jper1679/sorter-v2/docs/src/content/lab/concepts/index.md

---
layout: default
title: Concepts
type: explanation
section: lab
slug: lab-concepts
kicker: Design and research — Variants
lede: Design proposals for the Sorter V2 that nobody has built yet, written down so they can be read, checked and argued with.
permalink: /lab/concepts/
audience: contributor or builder interested in changing the design
applies_to: hardware-v2
owner: docs
last_verified: 2026-10-11
---

A concept is a proposal for changing the standard Sorter V2 that has not been built. That is the difference from a [tested variant]({{ '/lab/variants/' | relative_url }}), which somebody has made and run on their own machine. A concept page says what is measured and what is estimated, so the claims in it can be checked before anyone prints anything.

None of these is part of the build instructions in [Hardware]({{ '/hardware/' | relative_url }}), and none is in the parts calculator.

## Proposals so far

<div class="callout-grid">
  <div class="callout">
    <strong><a href="{{ '/lab/concepts/floating-chute-stack/' | relative_url }}">Floating chute stack</a></strong>
    <p>Take every electrical part off the rotating chute stack, build each bin layer as its own module, and hold a column of chutes at two points.</p>
  </div>
  <div class="callout">
    <strong><a href="{{ '/lab/concepts/power-manager/' | relative_url }}">Push-button power manager</a></strong>
    <p>Start the machine with one button and shut it down cleanly through a remote-control power supply, with the Orange Pi shutting itself down first.</p>
  </div>
</div>
