jper1679/sorter-v2/docs/src/content/hardware/assembly/distribution/top-interface.md

---
layout: default
title: Top interface
type: how-to
section: hardware
slug: assembly-top-interface
kicker: Distribution — Top interface
lede: The interface between the feeder and the bin tower.
permalink: /hardware/assembly/distribution/top-interface/
og_image: https://assets.basically.website/sorter-parts/top-interface-finished-full-65eb32ba52dc.png
author: zed0
contributors: [barthel, brickcyclealice, dodgybob]
parts_needed:
  - part: interface-upper-fixed-section
    qty: 1
  - part: interface-rib
    qty: 5
  - part: interface-rib-switch
    qty: 1
  - part: interface-bracket
    qty: 6
  - part: interface-spacer
    qty: 6
  - part: interface-nema23-bracket
    qty: 1
  - part: interface-big-spacer
    qty: 1
  - part: limit-switch-housing
    qty: 1
  - part: limit-switch-dowel-pin
    qty: 1
  - part: limit-switch-hammer
    qty: 1
  - part: top-interface-split-spur-gear-3
    qty: 1
  - part: top-interface-split-spur-gear-1
    qty: 1
  - part: top-interface-split-spur-gear-2
    qty: 1
  - part: interface-spur-gear
    qty: 1
  - part: interface-idler-gear
    qty: 1
  - part: chute-stepper-idler-bearing-retainer-outer
    qty: 1
  - part: chute-stepper-idler-bearing-retainer-inner
    qty: 1
  - part: interface-cage-bracket
    qty: 5
  - part: interface-cage-bracket-cable
    qty: 1
  - part: top-plate
    qty: 1
  - part: cable-cage-top
    qty: 1
  - part: cable-cage-bottom
    qty: 1
  - part: cage-top-hex-corner
    qty: 10
  - part: cage-top-motor-piece
    qty: 1
  - part: cable-clamp-outer
    qty: 1
  - part: cable-clamp-inner
    qty: 1
  - part: ribbon-cable-clamp
    qty: 1
  - part: ext-2020-e
    qty: 6
  - part: ext-2020-f
    qty: 6
  - part: brg-lazy-susan
    qty: 1
  - part: brg-608-2rs
    qty: 1
  - part: motor-nema23
    qty: 1
  - part: pulley-20t-8mm
    qty: 1
  - part: endstop-mechanical
    qty: 1
  - part: cable-idc-2x8-long
    qty: 1
  - part: hsi-m3
    qty: 16
  - part: hsi-m4
    qty: 8
  - part: hsi-m5
    qty: 24
  - part: scr-m3-6-cs
    qty: 1
  - part: scr-m3-8-cs
    qty: 9
  - part: scr-m3-12-bhcs
    qty: 3
  - part: scr-m3-12-cs
    qty: 6
  - part: scr-m3-16-shcs
    qty: 2
  - part: scr-m3-20-cs
    qty: 1
  - part: scr-m3-40-fhcs
    qty: 1
  - part: scr-m4-16-cs
    qty: 8
  - part: scr-m5-8-cs
    qty: 6
  - part: scr-m5-12-shcs
    qty: 4
  - part: scr-m5-16-shcs
    qty: 50
  - part: scr-m5-20-shcs
    qty: 24
  - part: scr-m5-22-cs
    qty: 14
  - part: scr-m5-30-shcs
    qty: 6
  - part: scr-m5-35-fhcs
    qty: 6
  - part: nut-m3
    qty: 1
  - part: tnut-m5-2020
    qty: 56
  - part: nut-m5
    qty: 6
tools_needed: ["Hex keys, 2 mm, 2.5 mm, 3 mm and 4 mm", "Spanner, 8 mm, for the M5 nuts", "Soldering iron or heat-set insert press"]
last_verified: 2026-09-24
---

The top interface holds a chute that rotates on a lazy-susan bearing to aim incoming parts at whichever bin layer is currently selected. A NEMA 23 stepper drives the rotation through a small gear train (steps 6 and 9), and a limit switch and hammer (steps 4, 6, 8) give it a fixed reference point to home against, since the stepper alone has no way to know which way it is pointed. Everything on this page bolts onto the Top plate, which then sits on the hex frame built on the bin-frame page.

<div class="prep-item">
  <div class="prep-item-body">
    <p><strong>Have a <a href="{{ '/hardware/assembly/distribution/bin-frame/hex-frame/' | relative_url }}">hex frame</a> ready by step 13.</strong> It's a required component of this page — step 13 places one onto the assembly, it doesn't build one. The rest of this page (steps 1-12, 14+) doesn't need it.</p>
  </div>
  <figure class="prep-item-figure">
    A finished hex frame from above: six B spokes and their printed crossbeams forming the inner ring inside the aluminum outer hexagon, with a printed corner bracket at each of the six vertices
    <figcaption>A finished hex frame. <cite>Photo: BrickCycleAlice.</cite></figcaption>
  </figure>
</div>

<div class="prep-item">
  <div class="prep-item-body">
    <p><strong>Have the <a href="https://parts-calculator.basically.website/lasercut">Top plate</a> laser-cut and ready by step 2.</strong> It's not printed or built on any page, it's ordered or hand-cut ahead of time — see the parts calculator's lasercut page for the DXF and hand-cut instructions.</p>
  </div>
  <figure class="prep-item-figure">
    The machine's hexagonal top plate, laser-cut, with cable holes and stepper mount holes visible
    <figcaption>The Top plate.</figcaption>
  </figure>
</div>

<div class="prep-item">
  <div class="prep-item-body">
    <p><strong>Have the <a href="https://parts-calculator.basically.website/lasercut">Cable cage top</a> laser-cut and ready by step 10, and the Cable cage bottom by step 12.</strong> Same as the Top plate: laser-cut ahead of time, not built on this page.</p>
    <p><strong>Printing the cable cage plates instead?</strong> The parts list offers two options: the two laser-cut plates, or ten printed hex corners and one printed motor piece. For the printed ones, glue the pieces into the two plates first, on <a href="{{ '/hardware/helpers/cable-cage-plates/' | relative_url }}">Preparing the 3D printed cable cage plates</a>, and have them ready by step 10 and step 12. The steps below are the same either way.</p>
  </div>
  <div class="prep-item-figure prep-item-figure-split">
    <figure>
      The Cable cage top, a laser-cut hexagonal plate with a keyed centre cutout
      <figcaption>Cable cage top.</figcaption>
    </figure>
    <figure>
      The Cable cage bottom, a laser-cut hexagonal plate with a large centre cutout
      <figcaption>Cable cage bottom.</figcaption>
    </figure>
  </div>
</div>

The fasteners and quantities are in the parts list above and are called out inline at each step.

{% include fastener-legend.html %}

Several steps below refer to holes in the Top plate by name (S2 and S3 for the stepper mount, I1 to I6 and O1 to O6 for the interface brackets). This map shows which hole is which:

<figure>
  Hole map of the hexagonal top plate: three stepper holes S1 to S3 in a row left of the center opening, six inner-ring holes I1 to I6, six outer-ring holes O1 to O6, and five cable holes C1 to C5, colour-coded by group
  <figcaption>Top plate hole map. S = stepper trio, I = inner ring, O = outer ring, C = cable holes. <cite>Render: Balloon.</cite></figcaption>
</figure>

{% include step.html n="1" title="Preparation" %}

Before assembling anything, press all the heat inserts listed below into their parts while the parts are still loose — this covers every insert used on this page. Fusing them in afterwards is much harder, for example once the Interface upper fixed section is mounted to the Top plate. Later steps repeat each insert count as a reminder only; you don't need to press anything a second time. See [installing heat inserts]({{ '/hardware/helpers/heat-inserts/' | relative_url }}) for the technique.

<div class="prep-item">
  <div class="prep-item-body">
    <p><strong>Interface upper fixed section:</strong> 4 × M4</p>
  </div>
  <figure class="prep-item-figure">
    The Interface upper fixed section ring, underside with the NEMA 23 bracket attached, showing four brass M4 heat inserts around its face
    <figcaption>Underside, with the NEMA 23 bracket attached. <cite>Photo: zed0, a still from the assembly video.</cite></figcaption>
  </figure>
</div>

<div class="prep-item">
  <div class="prep-item-body">
    <p><strong>Interface NEMA 23 bracket:</strong> 6 × M5 (4 at the corners of the motor plate, 2 in a pair on the centre line) and 1 × M3 (on the tail)</p>
  </div>
  <figure class="prep-item-figure">
    The Interface NEMA 23 bracket held up, showing four brass M5 inserts on the top edges and one M3 insert on the long tail
    The underside of the Interface NEMA 23 bracket, showing the two remaining brass M5 heat inserts
    <figcaption>The four at the corners of the motor plate and the M3 on the tail, with the pair on the centre line on the other face. On the machine the four face down, towards the motor, and the pair face up, towards the Top plate. <cite>Photo: zed0, a still from the assembly video.</cite></figcaption>
  </figure>
</div>

<div class="prep-item">
  <div class="prep-item-body">
    <p><strong>Top interface chute mount:</strong> 4 × M4 and 7 × M3</p>
  </div>
  <div class="prep-item-figure prep-item-figure-split">
    <figure>
      The underside of the white Top interface chute mount, showing brass M4 and M3 heat inserts around the ring
      <figcaption>Underside: the 4 M4 and 5 of the M3. The other 2 M3 sit by the cable-clamp recess on the top face. <cite>Photo: zed0, a still from the assembly video.</cite></figcaption>
    </figure>
    <figure>
      A closer grey view of the Top interface chute mount underside, showing two of the M3 inserts on the ring beside the recess for the Limit switch hammer screw
      <figcaption>A closer look at two of the M3 inserts, next to the recess for the Limit switch hammer screw. <cite>Photo: BrickCycleAlice.</cite></figcaption>
    </figure>
  </div>
</div>

<div class="prep-item">
  <div class="prep-item-body">
    <p><strong>Interface bracket:</strong> 3 × M5 (each of the 6)</p>
  </div>
  <figure class="prep-item-figure">
    An Interface bracket held up, showing three brass M5 heat inserts: one near the top boss, one in the middle of the channel, and one at the bottom end
    <figcaption>One M5 on each long side and one on the tail end, including the one in the channel that's easy to miss. <cite>Photo: BrickCycleAlice.</cite></figcaption>
  </figure>
</div>

<div class="prep-item">
  <div class="prep-item-body">
    <p><strong>Limit switch housing:</strong> 2 × M3</p>
  </div>
  <figure class="prep-item-figure">
    The grey Limit switch housing, showing two brass M3 heat inserts on the angled face where the roller lever limit switch mounts, with the dowel pin hole above them
    <figcaption>The two M3 inserts, where the roller lever limit switch mounts. <cite>Photo: BrickCycleAlice.</cite></figcaption>
  </figure>
</div>

<div class="prep-item">
  <div class="prep-item-body">
    <p><strong>Limit switch hammer:</strong> 1 × M3</p>
  </div>
  <figure class="prep-item-figure">
    The Limit switch hammer held up, showing a single brass M3 heat insert in its round disc
    <figcaption>One M3 insert in the round disc. <cite>Photo: zed0, a still from the assembly video.</cite></figcaption>
  </figure>
</div>

<div class="prep-item">
  <div class="prep-item-body">
    <p><strong>Cable cage bracket (cable mount):</strong> 1 × M3</p>
  </div>
  <figure class="prep-item-figure">
    The Cable cage bracket (cable mount) held up, showing a single brass M3 heat insert
    <figcaption>The one M3 insert in the Cable cage bracket (cable mount). <cite>Photo: zed0, a still from the assembly video.</cite></figcaption>
  </figure>
</div>

<div class="prep-item">
  <div class="prep-item-body">
    <p><strong>Interface idler gear:</strong> 4 × M3, around the bearing pocket on the underside</p>
    <p>Build the bearing sub-assembly now too, while the gear is still loose — it is easier off the bracket than on it. Push a 608 2RS bearing into the pocket, fit the Chute stepper idler bearing retainer (inner) over the bearing's bore, then the Chute stepper idler bearing retainer (outer) over that, seated flush in the recess with its 4 holes lined up on the gear's 4 inserts. Secure it with 4 × {% include fastener.html size="M3" variant="countersunk" length="8" %} screws, the same M3 x 8 mm countersunk screw used on the Interface spur gear in step 9. See step 9 for how the idler gear then goes onto the bracket.</p>
  </div>
  <div class="prep-item-figure prep-item-figure-split">
    <figure>
      The Interface idler gear alone, showing all 4 brass M3 heat inserts around the bearing pocket
      <figcaption>The 4 M3 inserts around the bearing pocket, before the bearing goes in. <cite>Photo: BrickCycleAlice.</cite></figcaption>
    </figure>
    <figure>
      An exploded view from below of the idler gear stack in build order: the grey gear, the bearing highlighted in blue, and the inner and outer bearing retainer caps highlighted in red
      <figcaption>Exploded, in build order: gear, bearing, inner cap, outer ring. <cite>Render: Balloon.</cite></figcaption>
    </figure>
    <figure>
      608 2RS bearing pressed into the centre of the grey Interface idler gear, with the 4 brass M3 heat inserts visible around it, before the bearing retainer caps go on
      <figcaption>608 2RS bearing pressed into the pocket, inserts visible, caps not yet on. <cite>Photo: BrickCycleAlice.</cite></figcaption>
    </figure>
    <figure>
      The Interface idler gear seen from below at an angle, assembled, with the bearing highlighted in blue showing through the centre and the outer and inner bearing retainer caps highlighted in red, the outer retainer's four countersunk screw holes visible
      <figcaption>Assembled: bearing pocket recess with both retainer caps fitted. <cite>Render: Balloon.</cite></figcaption>
    </figure>
    <figure>
      The Interface idler gear with the bearing retainer caps mounted for real, the 4 screws seated flush in place of the heat inserts
      <figcaption>The retainer caps mounted for real, matching the render above. <cite>Photo: BrickCycleAlice.</cite></figcaption>
    </figure>
  </div>
</div>

{% include step.html n="2" title="Attach the interface ribs to the upper fixed section" %}

<figure class="video-figure">
  <div class="video-embed video-embed-wide">
    <iframe
      src="https://www.youtube.com/embed/O_ApnzrWRsE?mute=1"
      title="Attaching the interface ribs to the interface upper fixed section"
      allow="encrypted-media; picture-in-picture; web-share"
      allowfullscreen
      loading="lazy"></iframe>
  </div>
  <figcaption><cite>Video: zed0.</cite></figcaption>
</figure>

**Heat inserts first:** press the 4 × M4 inserts into the Interface upper fixed section and the 6 × M5 and 1 × M3 inserts into the Interface NEMA 23 bracket before you assemble anything here.

Attach the Interface rib (switch gap) to the Interface upper fixed section, two positions counterclockwise of the stepper-mount notch when viewed from above (see photo). Use two {% include fastener.html size="M5" variant="socket-button" length="16" %} screws, tapping directly into the plastic.

Attach the remaining 5 Interface ribs to the Interface upper fixed section, two {% include fastener.html size="M5" variant="socket-button" length="16" %} screws each, again tapping into the plastic.

Slot the Interface NEMA 23 bracket into the Interface upper fixed section and secure it from below with an {% include fastener.html size="M3" variant="countersunk" length="12" %} screw.

Attach the whole assembly to the bottom of the Top plate with 2 {% include fastener.html size="M5" variant="countersunk" length="22" %} screws, one through hole S2 and one through hole S3, into the Interface NEMA 23 bracket's pair of M5 inserts. Hole S1 stays empty.

**Alternative:** whether these need a countersunk head depends on how your Top plate was cut. If the S2/S3 holes have a countersink cut in, use a countersunk head; if they don't, {% include fastener.html size="M5" variant="socket-button" length="20" %} screws work here instead. Builder's call depending on their plate, the same as the I1-I6/O1-O6 screws in step 5.

<div class="img-row">
  <figure>
    Six grey Interface ribs attached around the circular Interface upper fixed section
    <figcaption>The 6 Interface ribs attached to the Interface upper fixed section. <cite>Photo: BrickCycleAlice.</cite></figcaption>
  </figure>
  <figure>
    Underside of the Interface upper fixed section with the Interface NEMA 23 bracket seated in its notch
    <figcaption>Underside, with the Interface NEMA 23 bracket seated in its notch. <cite>Photo: BrickCycleAlice.</cite></figcaption>
  </figure>
</div>

<div class="img-row">
  <figure>
    Close-up of a hand-cut plywood Top plate showing a countersunk screw hole near the S3 hole position
    <figcaption>A hand-cut Top plate with the S2/S3 holes countersunk. <cite>Photo: BrickCycleAlice.</cite></figcaption>
  </figure>
</div>

{% include step.html n="3" title="Prepare the interface brackets" %}

<figure class="video-figure">
  <div class="video-embed video-embed-wide">
    <iframe
      src="https://www.youtube.com/embed/-mtU3WXP73M?mute=1"
      title="Preparing the interface brackets"
      allow="encrypted-media; picture-in-picture; web-share"
      allowfullscreen
      loading="lazy"></iframe>
  </div>
  <figcaption><cite>Video: zed0.</cite></figcaption>
</figure>

**Heat inserts first:** each Interface bracket takes 3 × M5 inserts. Press them in before fitting the extrusion.

These six brackets are what the vertical extrusion legs (piece F, step 13) will anchor into once the framing goes on.

Align an Interface bracket with a length of aluminum extrusion, **piece E (Interface spoke, long), 238 mm**.

Place T-nuts in the extrusion, lined up with the 4 holes on the side of the Interface bracket. See [Fitting T-nuts]({{ '/hardware/helpers/t-nuts/' | relative_url }}) for how they go in.

Slide the extrusion into the Interface bracket, careful not to dislodge the T-nuts, and drive four {% include fastener.html size="M5" variant="socket-button" length="16" %} screws into them.

<div class="callout">
  <span class="callout-icon" aria-hidden="true">💡</span>
  <p>Thread the four screws a couple of turns into the T-nuts before sliding the extrusion in, so they hang in place instead of sitting loose in the channel. Easier than aligning four free T-nuts by feel. <cite>Tip: BrickCycleAlice.</cite></p>
</div>

<div class="img-row">
  <figure>
    Four M5 screws threaded a few turns into T-nuts hanging in the Interface bracket's channel before the extrusion is slid in
    <figcaption>Screws threaded into the T-nuts first, ready for the extrusion. <cite>Photo: BrickCycleAlice.</cite></figcaption>
  </figure>
  <figure>
    The extrusion slid into the Interface bracket's channel, with the four M5 screws driven into the T-nuts along the bracket's face and a brass M5 insert at each end of it
    <figcaption>The extrusion slid home and all four screws driven into the T-nuts. <cite>Photo: BrickCycleAlice.</cite></figcaption>
  </figure>
  <figure>
    The joined Interface bracket and extrusion from the outer side, the extrusion projecting past the bracket's lower end and the square socket for the vertical leg at the top
    <figcaption>The finished joint from the outer side, with the socket for the vertical leg at the top. <cite>Photo: BrickCycleAlice.</cite></figcaption>
  </figure>
</div>

Repeat for all 6 Interface brackets.

{% include step.html n="4" title="Prepare the limit switch interface bracket" %}

<figure class="video-figure">
  <div class="video-embed video-embed-wide">
    <iframe
      src="https://www.youtube.com/embed/YzYzytRl3p4?mute=1"
      title="Preparing the limit switch interface bracket"
      allow="encrypted-media; picture-in-picture; web-share"
      allowfullscreen
      loading="lazy"></iframe>
  </div>
  <figcaption><cite>Video: zed0.</cite></figcaption>
</figure>

**Heat inserts first:** the Limit switch housing takes 2 × M3 inserts. Press them in before assembling it.

This switch is the chute's home reference: because the stepper motor that will drive the chute (step 9) has no inherent sense of position, the machine homes against this switch and hammer on startup to know which bin the chute is aimed at.

Push the Printed dowel pin into the Limit switch housing.

Attach the Roller lever limit switch (the "endstop-mechanical" part in your kit) with two {% include fastener.html size="M3" variant="socket-button" length="16" %} screws (into the housing's 2 M3 inserts) so the roller sits next to the dowel pin.

<div class="img-row">
  <figure>
    The roller lever limit switch screwed to the grey Limit switch housing, its roller sitting alongside the printed dowel pin
    <figcaption>The switch on the housing, roller alongside the dowel pin. <cite>Photo: BrickCycleAlice.</cite></figcaption>
  </figure>
  <figure>
    The same limit switch housing from behind, showing both M3 screws through the switch body and the dowel pin standing proud of the housing
    <figcaption>From behind, with both M3 screws in and the dowel pin seated. <cite>Photo: BrickCycleAlice.</cite></figcaption>
  </figure>
</div>

Align the switch housing with the extrusion of one of the prepared Interface brackets so the limit switch is on the same face as the sloped side of the bracket. Slide 2 T-nuts into the extrusion and fasten the Limit switch housing to the extrusion with two {% include fastener.html size="M5" variant="socket-button" length="16" %} screws. Slide it as far toward the Interface bracket as possible for now; it gets aligned properly later.

<div class="callout">
  <span class="callout-icon" aria-hidden="true">💡</span>
  <p>Same trick as the Interface brackets above: thread the two screws into the T-nuts first, then slide the extrusion in with them already hanging in place. <cite>Tip: BrickCycleAlice.</cite></p>
</div>

<div class="img-row">
  <figure>
    Two T-nuts threaded onto their screws on the Limit switch housing's mounting face, ready for the extrusion
    <figcaption>T-nuts threaded on before the extrusion goes in. <cite>Photo: BrickCycleAlice.</cite></figcaption>
  </figure>
</div>

<div class="img-row">
  <figure>
    The limit switch housing bolted to the extrusion of a prepared Interface bracket, seen along the whole length of the bracket
    <figcaption>The housing on the bracket's extrusion, slid up toward the bracket. <cite>Photo: BrickCycleAlice.</cite></figcaption>
  </figure>
  <figure>
    Close view of the limit switch housing on the extrusion, with its two M5 screws and the switch facing the same way as the sloped side of the bracket
    <figcaption>Closer: the two M5 screws, switch on the same face as the bracket's slope. <cite>Photo: BrickCycleAlice.</cite></figcaption>
  </figure>
</div>

{% include step.html n="5" title="Install the brackets" %}

<figure class="video-figure">
  <div class="video-embed video-embed-wide">
    <iframe
      src="https://www.youtube.com/embed/K7r15si5yxI?mute=1"
      title="Installing the interface brackets"
      allow="encrypted-media; picture-in-picture; web-share"
      allowfullscreen
      loading="lazy"></iframe>
  </div>
  <figcaption><cite>Video: zed0.</cite></figcaption>
</figure>

Slide a T-nut just into the end of the extrusion of the limit switch interface bracket. Slide the extrusion into the Interface rib (switch gap) and Interface upper fixed section, securing it loosely with an {% include fastener.html size="M5" variant="countersunk" length="8" %} screw. Slide the extrusion slightly in and out to align the holes on the Interface bracket with the holes on the Top plate, then tighten the screw.

<div class="callout">
  <span class="callout-icon" aria-hidden="true">💡</span>
  <p>Keep this loose for now, the bracket also gets fixed through the Top plate in the next step. Check by looking straight through the Top plate's own screw hole, not by feel alone. <cite>Tip: BrickCycleAlice.</cite></p>
</div>

<div class="img-row">
  <figure>
    A bracket's extrusion slid into an Interface rib on the underside of the Top plate, held by a single screw
    <figcaption>The extrusion slid into its rib, still loose on one screw. <cite>Photo: BrickCycleAlice.</cite></figcaption>
  </figure>
  <figure>
    Closer view of the same joint with the rib, the bracket and the Top plate's hole lined up
    <figcaption>Closer, with the bracket's holes lined up on the Top plate's. <cite>Photo: BrickCycleAlice.</cite></figcaption>
  </figure>
</div>

<div class="img-row">
  <figure>
    Looking down through one of the Top plate's screw holes, with light visible through it into the extrusion channel below
    <figcaption>What a clear sightline through the hole looks like. <cite>Photo: BrickCycleAlice.</cite></figcaption>
  </figure>
</div>

<div class="callout callout-warning">
  <span class="callout-icon" aria-hidden="true">⚠</span>
  <p>The M5 × 8 mm is a snug fit here, it barely reaches the T-nut. Opening the countersink a little and tightening firmly gets the head to sit flush.</p>
</div>

Repeat with the 5 other prepared Interface brackets into the 5 other Interface ribs.

Flip the whole assembly and screw all 6 Interface brackets into place with 12 {% include fastener.html size="M5" variant="countersunk" length="22" %} screws, one through each of holes I1 to I6 and O1 to O6.

<div class="img-row">
  <figure>
    All six Interface brackets and their extrusions installed around the Interface upper fixed section, seen from above, with the limit switch bracket among them
    <figcaption>All six brackets in, the limit switch one among them. <cite>Photo: BrickCycleAlice.</cite></figcaption>
  </figure>
  <figure>
    The assembly flipped onto its Top plate, the plate's face up with the marked I and O holes around the centre opening
    <figcaption>Flipped over, ready for the I and O screws. <cite>Photo: BrickCycleAlice.</cite></figcaption>
  </figure>
</div>

<div class="callout callout-warning">
  <span class="callout-icon" aria-hidden="true">⚠</span>
  <p>Alternative: the Top plate's laser-cut holes are not countersunk, so a countersunk head does not seat flush. {% include fastener.html size="M5" variant="socket-button" length="20" %} screws work here instead.</p>
</div>

<div class="callout">
  <span class="callout-icon" aria-hidden="true">💡</span>
  <p>Go back and fully tighten the M5 × 8 mm screws left loose earlier in this step, now that each bracket is also bolted through its I/O holes. This is also where a hand-cut Top plate's I/O holes show up as inaccurate, if they do; widen them if a bolt is binding. <cite>Tip: BrickCycleAlice.</cite></p>
</div>

{% include step.html n="6" title="Prepare the interface chute gear and mount" %}

<figure class="video-figure">
  <div class="video-embed video-embed-wide">
    <iframe
      src="https://www.youtube.com/embed/7oYiOXYF8rA?mute=1"
      title="Preparing the interface chute gear and mount"
      allow="encrypted-media; picture-in-picture; web-share"
      allowfullscreen
      loading="lazy"></iframe>
  </div>
  <figcaption><cite>Video: zed0.</cite></figcaption>
</figure>

**Heat inserts first:** the Top interface chute mount takes 4 × M4 and 7 × M3 inserts, and the Limit switch hammer takes 1 × M3. Press them in before assembling.

Slot the Limit switch hammer into the Top interface chute mount, then secure it from below with an {% include fastener.html size="M3" variant="countersunk" length="6" %} screw (into the hammer's M3 insert).

<div class="callout callout-warning">
  <span class="callout-icon" aria-hidden="true">⚠</span>
  <p>The M3 × 6 mm screw head must sit completely flush with the printed Top interface chute mount. It lies inside the Lazy Susan's rotation path, so a raised head will catch.</p>
</div>

Align the Chute gear on the Top interface chute mount with the notch by the screw for the Limit switch hammer. Attach it with five {% include fastener.html size="M3" variant="countersunk" length="12" %} screws.

Align the Top interface lazy Susan washer with the 4 inner heat inserts on the Top interface chute mount. Align the inner ring of the [Lazy Susan]({{ '/hardware/parts/lazy-susan/' | relative_url }}) with these 4 heat inserts too. Screw the Lazy Susan into position through the washer and into the Top interface chute mount with four {% include fastener.html size="M4" variant="countersunk" length="16" %} screws.

<div class="callout callout-warning">
  <span class="callout-icon" aria-hidden="true">⚠</span>
  <p>These screws have to be very tight. A drill or electric screwdriver will not get them there, so finish them with a hex key by hand. Machine vibration works a loose one out.</p>
</div>

Once complete, the free section of the Lazy Susan should rotate freely.

<div class="img-row">
  <figure>
    Gear side of the assembled Top interface chute mount, showing the chute gear, Lazy Susan, and Limit switch hammer
    <figcaption>Gear side, with the Chute gear, Lazy Susan, and Limit switch hammer installed. <cite>Photo: BrickCycleAlice.</cite></figcaption>
  </figure>
  <figure>
    Chute side of the assembled Top interface chute mount with the Limit switch hammer extending from the edge
    <figcaption>Chute side of the assembled gear and mount. <cite>Photo: BrickCycleAlice.</cite></figcaption>
  </figure>
</div>

{% include step.html n="7" title="Attach the interface chute to the assembly" %}

<figure class="video-figure">
  <div class="video-embed video-embed-wide">
    <iframe
      src="https://www.youtube.com/embed/FxpaGbyANHA?mute=1"
      title="Attaching the interface chute to the assembly"
      allow="encrypted-media; picture-in-picture; web-share"
      allowfullscreen
      loading="lazy"></iframe>
  </div>
  <figcaption><cite>Video: zed0.</cite></figcaption>
</figure>

Place the Interface big spacer on the Interface upper fixed section with its 4 holes lined up with the 4 heat inserts.

Rotate the free part of the Lazy Susan on the chute mount assembly from step 6 so that 3 of its holes line up with the holes in the Top interface chute mount. Place the assembly on top of the Interface big spacer with the 3 holes aligned with 3 of the heat inserts. Screw these together tightly with three {% include fastener.html size="M4" variant="countersunk" length="16" %} screws.

Rotate the Top interface chute mount 90 degrees relative to the Interface upper fixed section to reveal the 4th screw hole in the Lazy Susan (it should also line up with a hole in the Interface big spacer and a heat insert). Drive a fourth {% include fastener.html size="M4" variant="countersunk" length="16" %} screw tightly through this hole.

Once done, check that the chute rotates freely relative to the Interface upper fixed section.

{% include step.html n="8" title="Adjust the limit switch" %}

<figure class="video-figure">
  <div class="video-embed video-embed-wide">
    <iframe
      src="https://www.youtube.com/embed/FxpaGbyANHA?start=160&mute=1"
      title="Adjusting the limit switch"
      allow="encrypted-media; picture-in-picture; web-share"
      allowfullscreen
      loading="lazy"></iframe>
  </div>
  <figcaption><cite>Video: zed0.</cite></figcaption>
</figure>

Loosen the screws attaching the Limit switch housing to the extrusion. Slide the housing so the Limit switch hammer passes between the Roller lever limit switch and the Printed dowel pin. **The hammer has to strike the switch from both directions of rotation, and it must not run on the dowel pin.** Rotate the chute slowly to each limit by hand: you should feel and hear the switch click just before the hammer would otherwise hit the dowel pin. If the hammer rubs against the dowel pin, slide the housing slightly further away and re-test. Tighten the screws to keep the housing in this position.

<div class="img-row">
  <figure>
    The chute and its ring gear installed on the interface assembly, seen from above with all six brackets around it
    <figcaption>The chute in place, which is the state this adjustment starts from. <cite>Photo: BrickCycleAlice.</cite></figcaption>
  </figure>
  <figure>
    Close view of the Limit switch hammer swung in between the roller lever limit switch and the printed dowel pin, beside the chute's ring gear teeth
    <figcaption>The hammer passing between the roller and the dowel pin, clear of both. <cite>Photo: BrickCycleAlice.</cite></figcaption>
  </figure>
  <figure>
    Looking straight down on the ring gear and the limit switch housing: the hammer swung in towards the roller lever of the microswitch, with a clear gap between the hammer and the printed dowel pin beside it
    <figcaption>From above, where the gap to the dowel pin is easiest to judge. <cite>Photo: BrickCycleAlice.</cite></figcaption>
  </figure>
</div>

{% include step.html n="9" title="Install the chute stepper motor" %}

<figure class="video-figure">
  <div class="video-embed video-embed-wide">
    <iframe
      src="https://www.youtube.com/embed/z-L7_pNB8A8?mute=1"
      title="Installing the chute stepper motor"
      allow="encrypted-media; picture-in-picture; web-share"
      allowfullscreen
      loading="lazy"></iframe>
  </div>
  <figcaption><cite>Video: zed0.</cite></figcaption>
</figure>

<div class="callout callout-warning">
  <span class="callout-icon" aria-hidden="true">⚠</span>
  <p>This video predates the idler gear's bearing retainer caps. It shows the idler gear built the old way, with a loose washer under the M3 × 35 screw instead of the two printed caps from step 1.</p>
</div>

The idler gear bridges the gap between the spur gear on the motor shaft and the chute's ring gear (built in step 6), so the motor can sit off to the side of the chute mount rather than driving it directly.

Slide the prepared [Timing pulley]({{ '/hardware/helpers/pulley-gear-mod/' | relative_url }}) over the shaft of the NEMA 23 stepper motor and tighten its two set screws (grub screws). Slide the Interface spur gear onto the Timing pulley and secure it with five {% include fastener.html size="M3" variant="countersunk" length="8" %} screws: three tapped into the Interface spur gear and two bracing against the Timing pulley (exact split may vary — check the hole pattern in the photo).

<div class="img-row">
  <figure>
    Timing pulley installed on the shaft of a NEMA 23 stepper motor
    <figcaption>Timing pulley installed on the NEMA 23 shaft. <cite>Photo: BrickCycleAlice.</cite></figcaption>
  </figure>
  <figure>
    Grey Interface spur gear secured over the timing pulley with five countersunk screws
    <figcaption>Interface spur gear secured over the Timing pulley with five M3 × 8 mm screws. <cite>Photo: BrickCycleAlice.</cite></figcaption>
  </figure>
</div>

Push the prepared Interface idler gear — bearing, inner retainer cap, and outer retainer already fitted, see step 1 — onto the Interface NEMA 23 bracket with the bearing facing outwards.

<div class="img-row">
  <figure>
    The Interface idler gear pushed onto the NEMA 23 bracket and meshed with the chute's ring gear, its bearing bore still open with no screw through it
    <figcaption>The idler gear pushed onto the bracket, bearing facing out, before the screw goes in. <cite>Photo: BrickCycleAlice.</cite></figcaption>
  </figure>
</div>

Drive an {% include fastener.html size="M3" variant="countersunk" length="20" %} screw through the middle of the gear and into the bracket, so its head lands on the inner retainer cap. Tighten until it's seated, then check that the idler gear still spins freely.

Use a countersunk (flat/pancake) head here, not a socket or button head. If you only have a pan head on hand, hand-rotate the chute past this screw and check it clears the Limit switch hammer before closing everything up.

Slot the NEMA 23 onto the Interface NEMA 23 bracket and secure it with four {% include fastener.html size="M5" variant="socket-button" length="12" %} screws.

At this point the chute should still rotate, but you will now feel resistance from the stepper motor. Rotate the chute fully in both directions by hand: it should turn smoothly against that resistance, with no catch or scrape as the idler screw head passes the Limit switch hammer.

<div class="img-row">
  <figure>
    The Interface idler gear on the NEMA 23 bracket with the outer retainer over its bearing and a countersunk screw driven flush through the middle of it
    <figcaption>Screw seated flush through the outer retainer. This is the last state before the motor goes on. <cite>Photo: BrickCycleAlice.</cite></figcaption>
  </figure>
  <figure>
    The NEMA 23 stepper motor installed, its spur gear meshed with the idler gear and the chute's ring gear
    <figcaption>The finished step: stepper, spur gear and idler all meshed. <cite>Photo: BrickCycleAlice.</cite></figcaption>
  </figure>
</div>

{% include step.html n="10" title="Attach the cable cage top" %}

<figure class="video-figure">
  <div class="video-embed video-embed-wide">
    <iframe
      src="https://www.youtube.com/embed/NUDDwb5BZH8?mute=1"
      title="Attaching the cable cage top"
      allow="encrypted-media; picture-in-picture; web-share"
      allowfullscreen
      loading="lazy"></iframe>
  </div>
  <figcaption><cite>Video: zed0.</cite></figcaption>
</figure>

The cable cage (top, bottom, and clamps) is the channel the ribbon cable (`RIB1`) runs in while the chute rotates.

**Heat inserts first:** the Cable cage bracket (cable mount) takes 1 × M3 insert. Press it in before assembling.

Slot the Cable cage top over the Top interface chute mount, with the corners of the hexagon aligning with the Interface brackets. Of the two cage plates, the one that goes on here is the one with the **plain round centre hole**. The plate with the keyed cutout in its centre hole is the other one, and it goes on at [step 12](#step-12).

Screw the Cable cage bracket (cable mount) to the tail end of the Interface bracket opposite the Limit switch housing, using an {% include fastener.html size="M5" variant="socket-button" length="30" %} screw into the M5 heat insert. This clamps the Cable cage top firmly in place.

<figure class="diagram diagram-inline">
    <svg viewBox="0 0 660 350" width="620" xmlns="http://www.w3.org/2000/svg" role="img" aria-label="Two top-down hexagon diagrams of the top interface, each with the NEMA 23 stepper on a flat side, the limit switch bracket on the corner two round from it and the cable mount bracket on the corner straight across from the limit switch. Left, looking at the underside of the plate while you build: the stepper is on the left, so the limit switch is at the top and the cable mount at the bottom. Right, looking down on the finished machine: the same layout mirrored, with the stepper on the right.">
      <text x="175" y="49" text-anchor="middle" font-size="13" font-weight="700" fill="var(--ink)">While you build</text>
      <text x="175" y="65" text-anchor="middle" font-size="11" fill="var(--muted)">looking at the underside of the plate</text>
      <polygon points="175.0,113.0 95.3,159.0 95.3,251.0 175.0,297.0 254.7,251.0 254.7,159.0" fill="var(--surface)" stroke="var(--ink)" stroke-width="1.6"/>
      <circle cx="175" cy="205" r="34" fill="var(--bg)" stroke="var(--muted)" stroke-width="1.4"/>
      <text x="175" y="209" text-anchor="middle" font-size="11" fill="var(--muted)">chute</text>
      <line x1="175.0" y1="123.0" x2="175.0" y2="287.0" stroke="var(--muted)" stroke-width="1" stroke-dasharray="4 4"/>
      <circle cx="95.3" cy="159.0" r="5" fill="var(--bg)" stroke="var(--ink)" stroke-width="1.4"/>
      <circle cx="95.3" cy="251.0" r="5" fill="var(--bg)" stroke="var(--ink)" stroke-width="1.4"/>
      <circle cx="254.7" cy="251.0" r="5" fill="var(--bg)" stroke="var(--ink)" stroke-width="1.4"/>
      <circle cx="254.7" cy="159.0" r="5" fill="var(--bg)" stroke="var(--ink)" stroke-width="1.4"/>
      <rect x="167.0" y="105.0" width="16" height="16" fill="var(--primary)" stroke="var(--ink)" stroke-width="1.4"/>
      <text x="175.0" y="97.0" text-anchor="middle" font-size="12" font-weight="700" fill="var(--primary)">Limit switch</text>
      <polygon points="175.0,287.0 185.0,297.0 175.0,307.0 165.0,297.0" fill="#0055bf" stroke="var(--ink)" stroke-width="1.4"/>
      <text x="175.0" y="323.0" text-anchor="middle" font-size="12" font-weight="700" fill="#0055bf">Cable mount</text>
      <rect x="63.3" y="183.0" width="30" height="44" rx="3" fill="var(--ink)"/>
      <text x="55.3" y="209" text-anchor="end" font-size="12" font-weight="700" fill="var(--ink)">Stepper</text>
      <text x="495" y="49" text-anchor="middle" font-size="13" font-weight="700" fill="var(--ink)">On the machine</text>
      <text x="495" y="65" text-anchor="middle" font-size="11" fill="var(--muted)">looking down from above</text>
      <polygon points="495.0,113.0 415.3,159.0 415.3,251.0 495.0,297.0 574.7,251.0 574.7,159.0" fill="var(--surface)" stroke="var(--ink)" stroke-width="1.6"/>
      <circle cx="495" cy="205" r="34" fill="var(--bg)" stroke="var(--muted)" stroke-width="1.4"/>
      <text x="495" y="209" text-anchor="middle" font-size="11" fill="var(--muted)">chute</text>
      <line x1="495.0" y1="123.0" x2="495.0" y2="287.0" stroke="var(--muted)" stroke-width="1" stroke-dasharray="4 4"/>
      <circle cx="415.3" cy="159.0" r="5" fill="var(--bg)" stroke="var(--ink)" stroke-width="1.4"/>
      <circle cx="415.3" cy="251.0" r="5" fill="var(--bg)" stroke="var(--ink)" stroke-width="1.4"/>
      <circle cx="574.7" cy="251.0" r="5" fill="var(--bg)" stroke="var(--ink)" stroke-width="1.4"/>
      <circle cx="574.7" cy="159.0" r="5" fill="var(--bg)" stroke="var(--ink)" stroke-width="1.4"/>
      <rect x="487.0" y="105.0" width="16" height="16" fill="var(--primary)" stroke="var(--ink)" stroke-width="1.4"/>
      <text x="495.0" y="97.0" text-anchor="middle" font-size="12" font-weight="700" fill="var(--primary)">Limit switch</text>
      <polygon points="495.0,287.0 505.0,297.0 495.0,307.0 485.0,297.0" fill="#0055bf" stroke="var(--ink)" stroke-width="1.4"/>
      <text x="495.0" y="323.0" text-anchor="middle" font-size="12" font-weight="700" fill="#0055bf">Cable mount</text>
      <rect x="576.7" y="183.0" width="30" height="44" rx="3" fill="var(--ink)"/>
      <text x="614.7" y="209" text-anchor="start" font-size="12" font-weight="700" fill="var(--ink)">Stepper</text>
    </svg>

  <figcaption>The cable mount bracket goes on the corner straight across from the limit switch bracket, and the limit switch bracket is the second corner round from the stepper. Looking at the underside, as the build video and most build photos do, the limit switch is clockwise of the stepper. From above, as the <a href="{{ '/hardware/electronics/installation/' | relative_url }}">electronics layout</a> is drawn, it is counter-clockwise.</figcaption>
</figure>

Screw the remaining Cable cage brackets to the other 5 corners of the Cable cage top with {% include fastener.html size="M5" variant="socket-button" length="30" %} screws.

<div class="callout callout-warning">
  <span class="callout-icon" aria-hidden="true">⚠</span>
  <p><b>Check the chute still turns after every single screw.</b> The cage jams the rotation easily, and the two usual causes are a hand-cut cage plate and an over-tightened screw. Checking after each one tells you which screw did it; checking at the end of the step only tells you that something did.</p>
</div>

<div class="img-row">
  <figure>
    Looking down on the hexagonal plywood cage top slotted over the chute mount, the square mount standing through its centre hole and the printed brackets at the hexagon's corners
    <figcaption>The cage top over the chute mount, corners on the interface brackets. <cite>Photo: BrickCycleAlice.</cite></figcaption>
  </figure>
  <figure>
    The same plate from a lower angle, the round centre hole and the gap between it and the chute mount visible
    <figcaption>The gap around the mount is where the ribbon runs. <cite>Photo: BrickCycleAlice.</cite></figcaption>
  </figure>
  <figure>
    A wider view of the plate in place with all six brackets around it and the cable clamp at the near edge of the centre hole
    <figcaption>All six corners on, clamp at the near edge. <cite>Photo: BrickCycleAlice.</cite></figcaption>
  </figure>
</div>

{% include step.html n="11" title="Put the ribbon cable (`RIB1`) in the cable cage" %}

<figure class="video-figure">
  <div class="video-embed video-embed-wide">
    <iframe
      src="https://www.youtube.com/embed/aCNjETS1X9A?mute=1"
      title="Installing the ribbon cable (RIB1) in the cable cage"
      allow="encrypted-media; picture-in-picture; web-share"
      allowfullscreen
      loading="lazy"></iframe>
  </div>
  <figcaption><cite>Video: zed0.</cite></figcaption>
</figure>

Place an {% include fastener.html size="M3" variant="nut" %} into the bottom of the Cable clamp (outer) (the video skips this), then push it into the recess in the Top interface chute mount. Fasten it with two {% include fastener.html size="M3" variant="socket-button" length="12" %} screws.

<div class="callout callout-warning">
  <span class="callout-icon" aria-hidden="true">⚠</span>
  <p>The nut is not captive: nothing holds it in the pocket until the clamp is pushed into the recess. Check it is lying flat on the bottom of the pocket and keep that face upwards while you mount the clamp. If it falls out or sits skewed, the long screw later in this step has nothing to start on, and you cannot get at it once the clamp is bolted down.</p>
</div>

Rotate the chute until it hits the limit switch.

Fold your IDC ribbon cable (`RIB1`) around the Cable clamp (inner), following the guides on the clamp. Slide the cable and clamp together into the Cable clamp (outer), leaving a tail to connect to the chute above.

**Leave about 80 mm (3 in) of tail**, measured from where it leaves the clamp, which is what it takes to reach the layer adapter board on the chute core that sits on top of this assembly.

**The connector goes on pins up.** You should be able to see into the connector from above when the tail is lying where it will sit; if it is facing down at the bench, the cable is on the wrong way round. Getting this wrong is expensive: three steps have to come apart to turn it over.

<figure class="single-figure">
  The ribbon cable folded around the white cable clamp with its grey IDC plug standing at the end of the tail, the plug's socket openings facing up so you can see into it
  <figcaption>The plug pins up, so you can see into it. <cite>Photo: DodgyBob.</cite></figcaption>
</figure>

Guide the rest of the ribbon cable (`RIB1`) around the side of the Top interface chute mount, in the direction the chute can rotate, back to the Cable cage bracket (cable mount).

Screw the Ribbon cable clamp lightly to the Cable cage bracket (cable mount) with one {% include fastener.html size="M3" variant="socket-button" length="12" %} screw, clamping the ribbon cable (`RIB1`) between the two. Leave the clamp standing slightly off the bracket face rather than pulling it down hard, so the ribbon is not crushed.

<div class="img-row">
  <figure>
    The curved ribbon cable clamp screwed to the post of the cable mount bracket with a single screw through its middle, no cable in it yet
    <figcaption>The clamp on the bracket's post, before the ribbon goes in. <cite>Photo: BrickCycleAlice.</cite></figcaption>
  </figure>
  <figure>
    The ribbon cable running under the clamp on the bracket and folding back on itself, the red stripe along its edge, with one screw holding the clamp
    <figcaption>The ribbon clamped and turning back on itself at the bracket. <cite>Photo: BrickCycleAlice.</cite></figcaption>
  </figure>
</div>

<figure class="single-figure">
  The ribbon cable brought up beside the chute mount with its IDC connector standing free, a loop of cable running down to the plywood, and four brass heat inserts in the face beside it
  <figcaption>The tail left standing for the chute above, about 80 mm (3 in) of it. The layer adapter board is not fitted here; it mounts on the four inserts in view. <cite>Photo: BrickCycleAlice.</cite></figcaption>
</figure>

<figure class="single-figure">
  Onshape render of the cable-mount cage bracket (teal) with the ribbon cable clamp (purple) bolted to its post, one M3 hole visible through both
  <figcaption>The clamp (purple) on the bracket's post (teal), and the one M3 that goes through both. The ribbon cable is not shown. <cite>Rendered from the part geometry, not from a build. Render: Spencer.</cite></figcaption>
</figure>

Check that the chute can rotate fully to the limit switch in both directions, then tighten the Ribbon cable clamp screw. Use a long {% include fastener.html size="M3" variant="flat" length="40" %} screw through the Cable clamp (inner) into the {% include fastener.html size="M3" variant="nut" %} in the bottom of the Cable clamp (outer) to secure that end.

{% include step.html n="12" title="Attach the cable cage bottom" %}

<figure class="video-figure">
  <div class="video-embed video-embed-wide">
    <iframe
      src="https://www.youtube.com/embed/CE3OKs5nXSk?mute=1"
      title="Attaching the cable cage bottom"
      allow="encrypted-media; picture-in-picture; web-share"
      allowfullscreen
      loading="lazy"></iframe>
  </div>
  <figcaption><cite>Video: zed0.</cite></figcaption>
</figure>

Place the Cable cage bottom over the Top interface chute mount. This is the plate with the **keyed cutout** in its centre hole, the pocket that bulges outward on one side. Use 6 {% include fastener.html size="M5" variant="flat" length="35" %} screws and {% include fastener.html size="M5" variant="nut" %}s to clamp the Cable cage bottom, Cable cage top, and Cable cage brackets together.

After this step the chute should still rotate to each of its limits. Same as step 10: check after each screw rather than at the end, and back a screw off rather than forcing the chute past a tight spot.

{% include step.html n="13" title="Attach the framing" %}

Install four T-nuts and their {% include fastener.html size="M5" variant="socket-button" length="20" %} screws in each Interface bracket, then fit in an extrusion **piece F (Interface vertical support), 274 mm**. The [framing cut list](https://parts-calculator.basically.website/framing) has every length on this page. Leave **165 mm of the extrusion standing out of the bracket**, measured from the edge where it exits to the free end. <a href="{{ '/hardware/assembly/distribution/top-interface/' | relative_url }}#step-14">Step 14</a> shows the corner in section.

<figure>
  Six vertical extrusion supports bolted into the interface brackets, seen from above on the hexagonal top plate
  <figcaption><cite>Photo: zed0.</cite></figcaption>
</figure>

Slide an Interface spacer onto each piece of extrusion, with the lip at the top facing toward the center of the assembly.

<figure>
  An interface spacer slid onto each vertical extrusion support, lips facing inward
  <figcaption><cite>Photo: zed0.</cite></figcaption>
</figure>

Build a [hex frame]({{ '/hardware/assembly/distribution/bin-frame/hex-frame/' | relative_url }}), then place it onto the interface assembly.

Roll 6 {% include fastener.html size="M5" variant="t-nut" text="T-nuts" %} into this hex frame's own extrusions while you are here, 2 each for the PSU box, the control board housing and the Orange Pi housing. All three bolt onto this frame later, and the layout render on [installing the electronics]({{ '/hardware/electronics/installation/' | relative_url }}) shows where each one sits. Their screws and the rest of their hardware are listed on those pages, not here.

<div class="callout">
  <p><b>No problem if you forget them.</b> The {% include fastener.html size="M5" variant="t-nut" text="T-nut" %} this build specifies is the spring-loaded roll-in kind, which drops into the slot anywhere along its length, so these six can still go in later without taking the frame apart.</p>
</div>

<figure>
  A hex frame lowered onto the interface assembly
  <figcaption><cite>Photo: zed0.</cite></figcaption>
</figure>

Attach an External bracket cover to each of the External bracket sides, then fasten each one with 2 {% include fastener.html size="M5" variant="socket-button" length="16" %} screws into the holes at the base of the External bracket sides, bracing against the extrusion. These holes run parallel to the extrusion profile, and the screws are self-tapping. There is no External bracket — bottom vertical at this joint; see [step 14](#step-14) for what's different here.

{% include step.html n="14" title="How the interface joins the top layer" %}

<figure>
  <a href="https://assets.basically.website/sorter-docs/assembly-top-interface-framing-joint-full-ed0a06d244ff.png" target="_blank" rel="noopener">
    The interface assembly upside down on its top plate with six vertical extrusions standing out of it, each held in an interface bracket and sleeved by an interface spacer
  </a>
  <figcaption>The interface framing before the top layer goes on, with one arm marked 1 to 3. Click the photo to open it full size. <cite>Photo: zed0.</cite></figcaption>
</figure>

<figure class="figure-float-right">
  <a href="https://assets.basically.website/sorter-docs/assembly-top-interface-joint-section-v4-full-61893a48b612.png" target="_blank" rel="noopener">
    Vertical cross-section through one interface corner, drawn the right way up with the top plate across the top
  </a>
  <figcaption>Cut through the centre of the profile. On the build the assembly is upside down at this stage. Purple is the interface, blue the top layer's bracket, grey the extrusion. The pale band is how far the Interface bracket really reaches and how it slopes out as it rises to the plate, in outline because its arms run at right angles to this cut. Part lengths are measured; heights come from seating each part on the one below. Click to enlarge. <cite>Drawn from the part geometry rather than from a build, by Balloon.</cite></figcaption>
</figure>

This joint is not the same as the one between two layers, so it is worth naming what is different. There is **no External bracket — bottom vertical and no flange here**, and therefore none of the vertical screws that hold one layer to the next. Piece F is instead gripped at the interface end and clamped at the layer end, and it is sleeved the whole way between them, so no extrusion shows on a finished machine.

The numbers on the photo and the drawing:

<ol class="keyed-list">
  <li><strong>Interface bracket</strong>, one per corner, a 120 mm channel around the extrusion. Piece F is held in it by 4 {% include fastener.html size="M5" variant="socket-button" length="20" %} screws into {% include fastener.html size="M5" variant="t-nut" text="T-nuts" %}, the only place in the framing where a vertical is fixed with T-nuts rather than a self-tapping screw.</li>
  <li><strong>Interface spacer</strong>, a 129.7 mm sleeve, slid onto the extrusion with its lip at the top facing the centre. It takes no screws and simply sits between the bracket and the layer's collar.</li>
  <li><strong>Piece F</strong>, 274 mm cut (280 mm in CAD) against a layer's 154 mm, so the interface sits 120 mm further above the top layer than one layer's spacing.</li>
  <li><strong>The top layer's External bracket — side</strong>, with its cover, exactly the collar any layer has.</li>
  <li class="key-screw"><strong>Two {% include fastener.html size="M5" variant="socket-button" length="16" %} screws</strong> at the base of that bracket brace it against the extrusion, the same screws and holes a layer's own vertical gets. Nothing else fastens the interface to the layer.</li>
</ol>

**Piece F does not reach the top of the Interface bracket, and it comes nowhere near the top plate.** The 165 mm standing out of the bracket in step 13 is what sets where it sits.

## The finished result

The top plate, its six bracket mounts and their extrusion, the rotating chute mount and its gear train, and a hex frame closed onto the bottom of the verticals.

<figure class="single-figure">
  The finished top interface seen the way up it sits on the machine: the hexagonal top plate uppermost with the round opening through its centre, the six interface brackets splayed below it, and the chute mount hanging in the middle
  <figcaption>The finished interface the way up it sits on the machine, with the plate at the top and the chute mount hanging through it. <cite>Rendered from the parts' own geometry in assembly position, not from a build. Render: Balloon.</cite></figcaption>
</figure>

The [Distribution]({{ '/hardware/assembly/distribution/' | relative_url }}) page contains the instructions for the entire assembly, and is where you should return once you're done here.
