jper1679/sorter-v2/docs/src/content/hardware/electronics/installation/psu-box.md

---
layout: default
title: PSU box
type: how-to
section: hardware
slug: electronics-psu-box
kicker: Electronics — PSU box
lede: The printed housing around the Mean Well LRS-350-24, its mains inlet, and the wiring inside it.
permalink: /hardware/electronics/installation/psu-box/
author: barthel
contributors: [spencer, brickcyclealice, jensr80, dodgybob]
og_image: https://assets.basically.website/sorter-docs/psu-box-finished-closed-w1600-f8bd8bb5814a.jpg
last_verified: 2026-09-26
tools_needed: ["Hex keys, 2 mm and 2.5 mm", "Screwdriver for the supply's M3.5 terminal screws", "Pliers, for the jacks' nuts", "Multimeter, with a continuity buzzer"]
parts_needed:
  - part: psu-24v-350w
    qty: 1
  - part: psu-switch-fused
    qty: 1
  - part: mains-cord-c13
    qty: 1
  - part: meanwell-psu-housing-shell-rear
    qty: 1
  - part: meanwell-psu-housing-shell-front
    qty: 1
  - part: meanwell-psu-housing-front-panel
    qty: 1
  - part: meanwell-psu-housing-lid-rear
    qty: 1
  - part: meanwell-psu-housing-lid-front
    qty: 1
  - part: scr-m4-12-cs
    qty: 4
  - part: scr-m3-12-cs
    qty: 8
  - part: scr-m3-8-cs
    qty: 2
---

<div class="prep-item">
  <div class="prep-item-body">
    <p><strong>Make three <a href="{{ '/hardware/helpers/psu-pigtail/' | relative_url }}">PSU output pigtails</a> (<code>PSU1</code> to <code>PSU3</code>) before you start.</strong> Each is a panel-mount barrel jack with a fork terminal crimped onto each of its two leads, and they are commonly sold with the leads already on. That page builds them; step 1 here fits and wires them.</p>
  </div>
  <figure class="prep-item-figure">
    An assembled PSU output pigtail: a panel-mount barrel jack with red and black 18 AWG (0.82 mm²) leads, each ending in an insulated fork terminal
    <figcaption>One finished pigtail: the jack, its red and black leads, and a fork terminal on each. <cite>Photo: Jon.</cite></figcaption>
  </figure>
</div>

The fasteners and quantities are in the parts list above and are called out inline at each step.

{% include fastener-legend.html %}

<div class="callout callout-warning">
  <span class="callout-icon" aria-hidden="true">⚠</span>
  <p><b>Until this box is finished it has exposed mains wiring.</b> Observe basic electrical safety precautions: do not plug a cable into the IEC inlet until the assembly is complete, the wiring is verified and both lids are on.</p>
</div>

## The five printed parts

<figure class="harness-figure">
  Exploded render of the five printed parts of the PSU housing in build order: the blue front panel at the front left, the light grey shell front module behind it, the grey shell rear tray with its honeycomb floor and vented walls, and above them the plain front lid and the vented rear lid
  <figcaption>The five parts, in the order they go together. The blue front panel carries the mains inlet and the three jacks. The two lids screw down onto the two shells. <cite>Rendered from the parts' own STLs.</cite></figcaption>
</figure>

**Build the front panel in your hand first.** Both wiring steps are easier with it loose, and it is the last thing that goes on.

{% include step.html n="1" title="Fit and wire the three jacks" %}

Push each jack through a round hole **from the outside**, so its knurled bezel sits on the outer face of the panel and the threaded barrel and the two leads come through into the box. Any of the three round holes will do.

<figure class="harness-figure">
  Dimensioned drawing of the PSU housing front panel seen from outside: a landscape panel 131 by 50 mm, with three 12 mm round jack holes in a row on the left at 20 mm pitch, and on the right a 47.5 by 28 mm rectangular mains inlet cutout with a 2.8 mm screw pilot hole above it and another below it, 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
  <figcaption>The front panel from outside: inlet on the right, jacks on the left. <cite>Drawn from the part's STL, not from a build.</cite></figcaption>
</figure>

Each jack comes with a hex nut and a **spring washer**. Both go on the thread inside the box, in that order:

<ol class="numbered-steps">
  <li><b>Spring washer first</b>, down the thread until it sits flat against the inside face of the panel.</li>
  <li><b>Then the nut</b>, run down onto the washer and tightened until the washer has flattened out.</li>
</ol>

Without the washer the nut works loose in the printed plastic, and a loose jack turns in its hole every time a plug goes in.

<figure class="single-figure">
  The inside of the front panel with three barrel jacks through it: the left jack bare, the middle one with its spring washer down on the thread and its nut still loose on the leads below, and the right one with the washer flattened under a tightened nut
  <figcaption>The three jacks from inside, left to right in the order they go on: bare, spring washer down against the panel, then the nut tightened onto it. <cite>Photo: JensR80.</cite></figcaption>
</figure>

Set the panel down beside the supply for now. The leads land on the terminal block in step 4, once the supply is in the tray.

{% include step.html n="2" title="Fit the mains inlet" %}

<div class="callout callout-warning">
  <span class="callout-icon" aria-hidden="true">⚠</span>
  <p><b>No mains cable (<code>AC1</code>) in the inlet.</b> Not for this step, not for any of the ones after it, and not until the box is closed and the wiring checked.</p>
</div>

The **IEC C14 inlet, switch + 10 A fuse** is the machine's mains entry and its on/off switch. Its three leads come already attached, so there is no AC cable to make.

**The cable from the wall is an ordinary IEC C13 mains lead (`AC1`)**, the cord a desktop PC or a monitor comes with, with the plug your country uses. It is in the parts above. Three core, because the machine earths through it and out to the supply's earth screw, and 10 A or better, which matches the module's own fuse and is far more than the machine draws. It is the one part of this build most people already own, so check a drawer before buying one.

Push the inlet module into the rectangular cutout from the outside, so its flange sits flat on the outer face of the panel and its two holes line up with the panel's two small holes. **The rocker can face either way**, left or right, and nothing later depends on which.

Run an {% include fastener.html size="M3" variant="countersunk" length="8" %} into each of the two holes. Each screw cuts its own thread in the panel, and nothing goes behind it.

Stop as soon as the flange is tight. The panel bows outward before the screw gives, so the screw will not tell you when to stop.

**If a screw turns and never pulls the flange down**, your front panel is an older print whose holes are too wide to bite. Print the front panel again from the file in the parts list above: it is the smallest part in the set, under an hour on the plate.

{% include step.html n="3" title="Bolt the supply into the rear tray" %}

<div class="callout callout-warning">
  <span class="callout-icon" aria-hidden="true">⚠</span>
  <p><b>Set the supply's input voltage selector before it goes in the tray.</b> The LRS-350-24 is not universal input: a small slide switch on the side of its case, marked <code>115V</code> and <code>230V</code>, sets which mains voltage it runs on, and it has to match the socket the machine will be plugged into. Check which way it is set now, while the supply is loose and nothing is plugged in, and slide it across if it is wrong. Once it is bolted into the tray with both lids over it you cannot reach it. Left on 115 V and plugged into 230 V mains, the supply is destroyed the moment the rocker goes on.</p>
</div>

The supply's case has four threaded holes in its back face, and the tray's floor has four plain round holes that line up with them. Sit the supply in the tray and run 4 {% include fastener.html size="M4" variant="countersunk" length="12" %} screws up through the floor into the case.

**Nothing longer goes in these four holes.** The supply's circuit board is right behind that face. If a screw stops before it pulls the supply down, back it out rather than force it.

**Put the terminal-block end at the open end of the tray**, the end the front module butts up to. The other end is where the supply's own fan is, and that is the end the vented rear lid covers.

<div class="img-row">
  <figure>
    Photograph of the Mean Well LRS-350-24 seen from its back, with its four plain M4 threaded holes ringed, two at each end of the case, and the finned terminal-block end labelled
    <figcaption>The four threaded holes on the back of the supply, and which end the terminal block is on. The hex-stamped holes beside them are the case's own screws, not these. <cite>Manufacturer photo, marked up.</cite></figcaption>
  </figure>
  <figure>
    Render of the shell rear tray seen from above and to one side, its honeycomb floor and vented walls visible, with the four round clearance holes the M4 screws pass through ringed
    <figcaption>The same four, in the tray's floor. The screws go in from underneath. <cite>Rendered from the part's own STL.</cite></figcaption>
  </figure>
</div>

{% include step.html n="4" title="Land every lead on the terminal block" %}

The block is nine screws and the numbers are Mean Well's own, printed on the supply beside it.

If you have been testing the inlet module on the bench, screw it into the panel first: once these leads are under the terminal screws there is no slack left to work with.

Hold the front panel up to the open end of the tray, close enough that its leads reach, and land them all:

<ol class="numbered-steps">
  <li><b>The three pigtails (<code>PSU1</code> to <code>PSU3</code>)</b>, one per <b>+V/-V</b> pair: <b>7 with 4, 8 with 5, 9 with 6</b>, the red terminal on the +V screw and the black on the -V screw of the same pair. Each pigtail must keep to one pair.</li>
  <li><b>The inlet's three leads</b>: <b>live on 1</b> (AC/L), <b>neutral on 2</b> (AC/N), <b>earth on 3</b>. The earth lead is the green-yellow one.</li>
</ol>

<div class="callout callout-warning">
  <span class="callout-icon" aria-hidden="true">⚠</span>
  <p><b>Find out which of the other two is live. Do not go by colour.</b> These modules are sold with red and blue leads and <b>both orders have been found in the post</b>, so the colour tells you nothing about which one the fuse and the switch are in. Land them the wrong way round and the machine is fused and switched in its neutral: the supply stays live with the rocker off.</p>
</div>

**The test**, with nothing plugged in: take the fuse out of its drawer, [set the meter to continuity]({{ '/hardware/helpers/multimeter/' | relative_url }}#continuity-for-tracing-a-cable), and probe from each coloured lead to each of the two flat pins inside the C14. The pair that still beeps with the fuse out is **neutral**. The one that beeps only with the fuse back in and the rocker on is **live**, because the fuse and the switch sit in the live side. That lead goes on screw 1.

**Nothing tinned goes under a screw terminal.** Solder cold-flows under a clamped screw, so a tinned end that is tight today is slack in a few months, and a slack joint carrying this much current heats up. Use the fork terminals this page calls for. If you would rather put a bare lead straight under the screw, cut the tinned end off first and clamp clean stranded copper.

For each one: back the screw off a few turns, slide the fork terminal in under it, and tighten it down. Mean Well's figure for these M3.5 screws is 8 to 10 kgf&middot;cm, about 0.8 to 1.0 N&middot;m, which is firm rather than hard. Tug-test each terminal once it is down.

<figure class="harness-figure">
  Diagram of the Mean Well LRS-350-24 seen from above, its nine-way terminal block down the left edge numbered 1 at the bottom to 9 at the top, the numbers being Mean Well's own and printed on the supply. Red leads run from screws 9, 8 and 7 and black leads from 6, 5 and 4, pairing 9 with 6, 8 with 5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
  <figcaption>Every lead that lands on the block, and the screw it lands on. The red and blue drawn at the bottom are one module's: check which of yours is live rather than copying the colours. <cite>Drawn from the Mean Well LRS-350 spec sheet, the inlet's catalog entry and the harness drawings.</cite></figcaption>
</figure>

{% include step.html n="5" title="Close the box" %}

Slot the front panel down into the front module, either way up, then bring the front module up against the tray so the two shells meet. Lay the leads so none of them rests against the mains screws.

Then the two lids, 8 {% include fastener.html size="M3" variant="countersunk" length="12" %}. They cut their own thread in the shell parts, so run each one in until the lid is tight and stop.

<ol class="numbered-steps">
  <li><b>Rear lid</b>, the vented one, over the supply's fan end.</li>
  <li><b>Front lid</b>, over the other end. It traps the front panel, so check the panel is fully seated before it goes on.</li>
</ol>

<figure class="harness-figure">
  Render of the PSU housing with both lids lifted off and set down beside it, the plain front lid and the vented rear lid side by side, and all eight self-tapping bosses in the two shell parts ringed on the open box
  <figcaption>Both lids lifted off, with all eight screw holes ringed. <cite>Rendered from the parts' own STLs.</cite></figcaption>
</figure>

The box is closed before the machine sees mains.

## The finished result

The supply inside the closed housing, both lids down, the mains inlet and the three jacks in the front panel, and the two clamp bosses ready for the frame.

<figure class="harness-figure">
  The closed PSU box on a white table, seen from the front corner: the front panel with three barrel jacks, the mains inlet and its red rocker switch, the black lids screwed down over the shells with the vented rear lid at the far end, and a clamp boss with a screw hole at each end of the base
  <figcaption>The box closed, with its two clamp bosses ready for the frame. <cite>Photo: DodgyBob.</cite></figcaption>
</figure>

<div class="callout callout-warning">
  <span class="callout-icon" aria-hidden="true">⚠</span>
  <p><b>Once it is in service, pull the cord (<code>AC1</code>) out of the wall before you open this box.</b> The rocker is not an isolator you can rely on: a plug that goes in either way round means the switch may be breaking the neutral rather than the live, so treat everything inside as live whenever the cord is in.</p>
</div>

**Bolting it to the frame is on the [installation overview]({{ '/hardware/electronics/installation/' | relative_url }})**, once all three enclosures are built.

Next: [preparing the control board]({{ '/hardware/electronics/installation/control-board-prep/' | relative_url }}).
