jper1679/sorter-v2/docs/src/content/hardware/assembly/feeder/c-channels/index.md

---
layout: default
title: C-channels
type: landing
section: hardware
slug: assembly-c-channels
kicker: Feeder — C-channels
lede: Four drive stages on one common core, each finished differently for the job it does.
permalink: /hardware/assembly/feeder/c-channels/
og_image: https://assets.basically.website/sorter-docs/assembly-channel-core-finished-top-w1600-4713962f4dfd.jpg
author: spencer
contributors: [barthel, brickcyclealice, christoph, danny]
last_verified: 2026-09-25
---

A C-channel is one drive unit: a rotor turning inside a stator, driven by a NEMA 17 stepper through a gear train. A machine has four, and **all four are built on the same core**. What differs is the rotor that drops in and what hangs off it.

Build the core four times, then finish each one on its own page.

<ol class="numbered-steps">
  <li><strong><a href="{{ '/hardware/assembly/feeder/c-channels/channel-core/' | relative_url }}">Channel core</a></strong>. Stator, NEMA bracket, gear train, stepper. Build four.</li>
  <li><strong><a href="{{ '/hardware/assembly/feeder/c-channels/bulk-channel/' | relative_url }}">Bulk channel (C1)</a></strong>. The faceted rotor and the Bulk cap. No lamp, no output guide.</li>
  <li><strong><a href="{{ '/hardware/assembly/feeder/c-channels/feeder-channels/' | relative_url }}">Feeder channels (C2 and C3)</a></strong>. The faceted rotor and an output guide. Build two.</li>
  <li><strong><a href="{{ '/hardware/assembly/feeder/c-channels/classification-channel/' | relative_url }}">Classification channel (C4)</a></strong>. The finned rotor and its cap.</li>
</ol>

Each page finishes its channel on the bench, rotor in. Once all four are built, [arranging C-channels]({{ '/hardware/assembly/feeder/arranging-c-channels/' | relative_url }}) sets their heights and hangs the [camera lamps]({{ '/hardware/assembly/feeder/camera-lamp/' | relative_url }}).

## The finished result

Each page ends in one of these.

<div class="img-row">
  <figure>
    A finished channel core from directly above: the stator ring open at one side, the three-armed NEMA bracket fastened across it with the raised hub at its centre, the gear train at the ring's edge and the stepper motor standing outside the wall with its lead, and no rotor in the hub
    <figcaption><a href="{{ '/hardware/assembly/feeder/c-channels/channel-core/' | relative_url }}">Channel core</a>, no rotor in it yet. <cite>Photo: BrickCycleAlice.</cite></figcaption>
  </figure>
  <figure>
    A finished C1 on the bench: the tall cylindrical bulk cap seated on the channel below it, its outlet opening at the front right, the stepper motor at the front with its lead coiled
    <figcaption><a href="{{ '/hardware/assembly/feeder/c-channels/bulk-channel/' | relative_url }}">Bulk channel</a>, the cap on. <cite>Photo: BrickCycleAlice.</cite></figcaption>
  </figure>
  <figure>
    A C-channel from above on a plain surface: the faceted rotor sitting down in the stator ring, with the stepper motor and its lead standing off one side
    <figcaption><a href="{{ '/hardware/assembly/feeder/c-channels/feeder-channels/' | relative_url }}">Feeder channel</a>, rotor in. The output guide is not in this shot. <cite>Photo: BrickCycleAlice.</cite></figcaption>
  </figure>
  <figure>
    A finished classification channel on a wooden bench: the white finned rotor sitting down in the black stator ring with a small grey cap at its centre, the stepper motor at the left and the orange output gear showing at the gap in the ring
    <figcaption><a href="{{ '/hardware/assembly/feeder/c-channels/classification-channel/' | relative_url }}">Classification channel</a>, the capped rotor in. <cite>Photo: JensR80.</cite></figcaption>
  </figure>
</div>
