jper1679/sorter-v2/docs/src/content/hardware/assembly/feeder/camera-lamp/lamp-arm.md

---
layout: default
title: Lamp arm
type: how-to
section: hardware
slug: assembly-lamp-arm
kicker: Feeder — Lamp arm
lede: The arm and the ring it carries, the reflector with its ring of LED strip, and the cover that goes over the top. The half of a camera lamp that is the same on all three. Build three.
permalink: /hardware/assembly/feeder/camera-lamp/lamp-arm/
author: jensr80
contributors: [spencer, danny, brickcyclealice, barthel]
og_image: https://assets.basically.website/sorter-docs/camera-lamp-render-underside-full-0e2b1e5a0fb9.png
last_verified: 2026-09-25
tools_needed: ["Hex key, 2 mm"]
parts_needed:
  - part: c-channel-arm-mount
    qty: 1
  - part: camera-lamp-arm
    qty: 1
  - part: arm-bracket-a
    qty: 1
  - part: arm-bracket-b
    qty: 1
  - part: camera-lamp-ring
    qty: 1
  - part: lamp-inner-reflector
    qty: 1
  - part: inner-reflector-led-hook
    qty: 6
  - part: lamp-outer-cover
    qty: 1
  - part: led-strip-24v
    qty: 1
  - part: scr-m3-12-cs
    qty: 12
---

This page builds the part of a camera lamp that is the same on every channel: the arm with its ring at one end and its dovetail at the other, and the shaded lamp that sits over the ring. **No camera goes on here.** That is the [feeder camera lamp]({{ '/hardware/assembly/feeder/camera-lamp/feeder-camera-lamp/' | relative_url }}) page for C2 and C3, and the [classification camera lamp]({{ '/hardware/assembly/feeder/camera-lamp/classification-camera-lamp/' | relative_url }}) page for C4.

**The parts list above is one arm's worth. Build three**, for C2, C3 and the classification channel. **The bulk channel (C1) takes none**, because the machine does not look at it.

<div class="prep-item">
  <div class="prep-item-body">
    <p><strong>Prepare an <a href="{{ '/hardware/helpers/led-strip/' | relative_url }}">LED strip</a> before you start.</strong> One per lamp: a two-turn length cut off the roll, about 920 mm (36 in), with a short pigtail (<code>LED2</code>, <code>LED3</code> or <code>LED4</code>) on the end (ending in a male barrel plug, optional but recommended), either clamped on or soldered. That page has the strip, the connector, the plug and the board cable (<code>LED2a</code>, <code>LED3a</code> or <code>LED4a</code>); step 4 here only hooks it on.</p>
  </div>
  <figure class="prep-item-figure">
    A length of 8 mm COB LED strip with a clear clamp-on connector on its cut end, a red and a black wire leaving the other side of the connector in a white sheath
    <figcaption>A prepared strip: the cut end, the joint, and the pigtail (<code>LED2</code> to <code>LED4</code>) that leaves it. <cite>Manufacturer photo (SuperBrightLEDs).</cite></figcaption>
  </figure>
</div>

{% include fastener-legend.html %}

{% include step.html n="1" title="Preparation" %}

<div class="prep-item">
  <div class="prep-item-body">
    <p><strong>Colours.</strong> The <strong>Lamp inner reflector</strong> and its six <strong>LED hooks</strong> must print ivory white, and that is not cosmetic: they are the reflector, and a coloured one tints every picture the camera takes. The <strong>Lamp outer cover</strong>, the arm, the mount, both brackets and the ring can be any colour; the parts calculator puts them in the C-channel colour.</p>
  </div>
  <figure class="prep-item-figure">
    CAD render of the camera lamp in profile: the disc-shaped lamp overhanging at the top, carried on an arm that steps down at an angle to the C-channel arm mount, with a bracket along each joint
    <figcaption>The whole thing in profile. <cite>Rendered from the part geometry, not from a build. Render: Spencer.</cite></figcaption>
  </figure>
</div>

<div class="prep-item">
  <div class="prep-item-body">
    <p><strong>Six LED hooks per lamp, 18 for the machine.</strong> They are the ones people come up short on.</p>
  </div>
  <div class="prep-item-figure prep-item-figure-split">
    <figure>
      The printed lamp inner reflector lying face up, ivory white, with six LED hooks clipped evenly around its rim and a small grey rectangular plate sitting on the flat
      <figcaption>The inner reflector with its six LED hooks around the rim. <cite>Photo: BrickCycleAlice.</cite></figcaption>
    </figure>
    <figure>
      A closer view of the same reflector, two of the hooks standing off the rim and the grey rectangular plate on the flat between them
      <figcaption>Closer, with two of the hooks in view. <cite>Photo: BrickCycleAlice.</cite></figcaption>
    </figure>
  </div>
</div>

{% include step.html n="2" title="Bracket the arm to the C-channel arm mount" %}

The arm and the mount butt together end to end, with bracket A on one face and bracket B on the other.

<ol class="numbered-steps">
  <li>Butt the arm and the mount together. The ends are shaped, so they only mate one way round. If it does not seem to fit, swap the piece end for end rather than forcing it.</li>
  <li>Lay bracket A across the joint on one face and bracket B on the other, <strong>angled ends towards the dovetail</strong>.</li>
  <li>Drive 8 {% include fastener.html size="M3" variant="countersunk" length="12" %} screws, four per bracket. Stop as each head seats.</li>
</ol>

**The two brackets share their holes**, four holes with a screw into each end, so half of every hole belongs to the other bracket's screw. **Use the 12 mm here.** Two 16 mm screws would meet inside a hole before either seated.

<div class="img-row">
  <figure>
    The camera lamp arm butted to its mount with a bracket screwed across the joint, two countersunk screws in it, and the printed dovetail at the far end of the arm
    <figcaption>The joint with a bracket on, angled end towards the dovetail. <cite>Photo: BrickCycleAlice.</cite></figcaption>
  </figure>
  <figure>
    The far section of the camera lamp arm lying on the bench, the lamp ring at one end and the shaped mating end at the other
    <figcaption>The other section, ring end and shaped end. <cite>Photo: BrickCycleAlice.</cite></figcaption>
  </figure>
  <figure>
    A wider view of a camera lamp on the machine, showing the full length of the arm from the lamp down to the C-channel, with a bracket screwed along the joint and the LED leads cable-tied along the arm
    <figcaption>The same joint on the machine, leads running down the arm. <cite>Photo: Spencer.</cite></figcaption>
  </figure>
</div>

{% include step.html n="3" title="Screw the camera lamp ring onto the arm" %}

The ring goes on the far end of the arm, and is what the lamp and the camera hang from. It straddles the arm, and it works the same way as the joint below it: 4 more {% include fastener.html size="M3" variant="countersunk" length="12" %} screws, two per side, into the same two holes.

That is **12 M3 × 12 per arm**: 8 at the mount joint, 4 here. Six holes, a screw into each end of every one.

<figure class="single-figure">
  The whole camera lamp arm assembled on the bench: the dovetailed mount end, the bracket running along the joint with its screws, the bend, and the lamp ring at the far end
  <figcaption>Both sections joined, dovetail at one end and the ring at the other. <cite>Photo: BrickCycleAlice.</cite></figcaption>
</figure>

{% include step.html n="4" title="Hook the prepared LED strip onto the reflector" %}

Push the six **Inner reflector LED hooks** into the sockets around the rim of the **Lamp inner reflector**, evenly spaced. They are a friction fit and there are no screws. Each hook holds the LED strip against the reflector.

The strip itself is cut and wired on [Preparing the LED strip]({{ '/hardware/helpers/led-strip/' | relative_url }}): two turns of the skirt, about 920 mm (36 in), cut on a printed mark, with a short pigtail (`LED2` to `LED4`) on the cut end, which ends in a barrel plug if you fit the optional but recommended plug and socket. Have one ready before you start this step.

**Fitting it.** Two turns, LEDs facing inwards. **Do not stick the strip to the skirt.** Leave the blue film on and let the hooks hold it: it hangs in the air with room behind it, which keeps it cooler, and the adhesive lets go in the end anyway.

<ol class="numbered-steps">
  <li>Start the strip under one of the hooks, film still on, with the wired end where you want the leads to leave the lamp.</li>
  <li>Work it round the skirt, under each hook in turn, until you are back where you started. That is one turn.</li>
  <li>Drop down to the next hooks and go round again for the second turn.</li>
</ol>

<div class="img-row">
  <figure>
    The strip run once around the inside of the reflector skirt, back at its starting point, with the blue film being peeled off the length still to go
    <figcaption>One turn round. <cite>Photo: BrickCycleAlice.</cite></figcaption>
  </figure>
  <figure>
    Both turns of strip in the skirt, one above the other, film gone, with the red and black leads leaving the reflector at one side
    <figcaption>Second turn in, on the next clips down, leads out at one side. <cite>Photo: BrickCycleAlice.</cite></figcaption>
  </figure>
</div>

**Nothing fastens the reflector to the arm.** The arm's ring pushes up into the middle of the reflector from underneath and is held by the fit alone. That happens on the camera page for your channel, with the camera already clasped in the ring, so the arm and the lamp stay separate until then.

The strip comes with its pigtail (`LED2` to `LED4`) already on it from [Preparing the LED strip]({{ '/hardware/helpers/led-strip/' | relative_url }}); strap that lead down the arm so it is not hanging in the channel (hook-and-loop straps rather than zip ties, see [securing the cables]({{ '/hardware/electronics/connecting/' | relative_url }}#securing-the-cables)). It can leave the lamp two ways, and machines have been built both: straight out of the bottom of the shade, or up through the slot in the cover and down the outside alongside the camera lead. Whichever you pick, keep the run clear of where the strip's own joint sits inside the shade. Plugging it into the board is step 4 of [connecting the components]({{ '/hardware/electronics/connecting/' | relative_url }}). Nothing is joined end to end here, so the far end of the strip stays dead. The strip runs at 24 V off the basically board.

{% include step.html n="5" title="Press the outer cover onto the reflector" %}

The **Lamp outer cover** pushes down over the reflector. It is a friction fit and has no screw hole anywhere. Put the reflector flat on the table, sit the cover on it and press straight down until it seats. It stands slightly proud of the reflector, so the camera clasp ends up recessed in the opening at its centre.

**The lamp is finished here, and it is finished without a camera.** The camera goes into the ring on the arm, and the arm goes up into the underside of this lamp, on the camera page for your channel. The cover stays on while that happens: the clasp is wider than the opening in the middle of the cover, so the cover overlaps its rim and is what holds the camera down once the arm is home.

<figure class="single-figure">
  The lamp lit, photographed from underneath: a ring of LED strip glowing around the outside of the white reflector, the reflector's central funnel in the middle, and the arm behind it
  <figcaption>Lit, from below. The strip rings the reflector and the light reaches the parts off the white. <cite>Photo: Spencer.</cite></figcaption>
</figure>

## The finished result

An arm with its dovetail at one end and its ring at the other, plus a finished lamp: reflector, LED strip and cover. Build three of each, and take them to the camera page for the channel they belong to, where the camera goes in the ring and the arm goes up into the lamp.

<figure class="single-figure">
  CAD render of the camera lamp seen from below: the inside of the cover with the reflector dome, the LED hooks spaced around the rim, and the arm reaching up into the middle of it
  <figcaption>From below: the reflector inside the cover, the hooks around the rim and the arm reaching up into the middle. <cite>Rendered from the part geometry, not from a build. Render: Spencer.</cite></figcaption>
</figure>

Back to [Camera lamps]({{ '/hardware/assembly/feeder/camera-lamp/' | relative_url }}).
