jper1679/sorter-v2/electronics/KiCad/1_Distribution_Board/1_Distribution_Board.kicad_pcb

## KiCad design electronics/KiCad/1_Distribution_Board/1_Distribution_Board.kicad_pcb (2026-11-07)

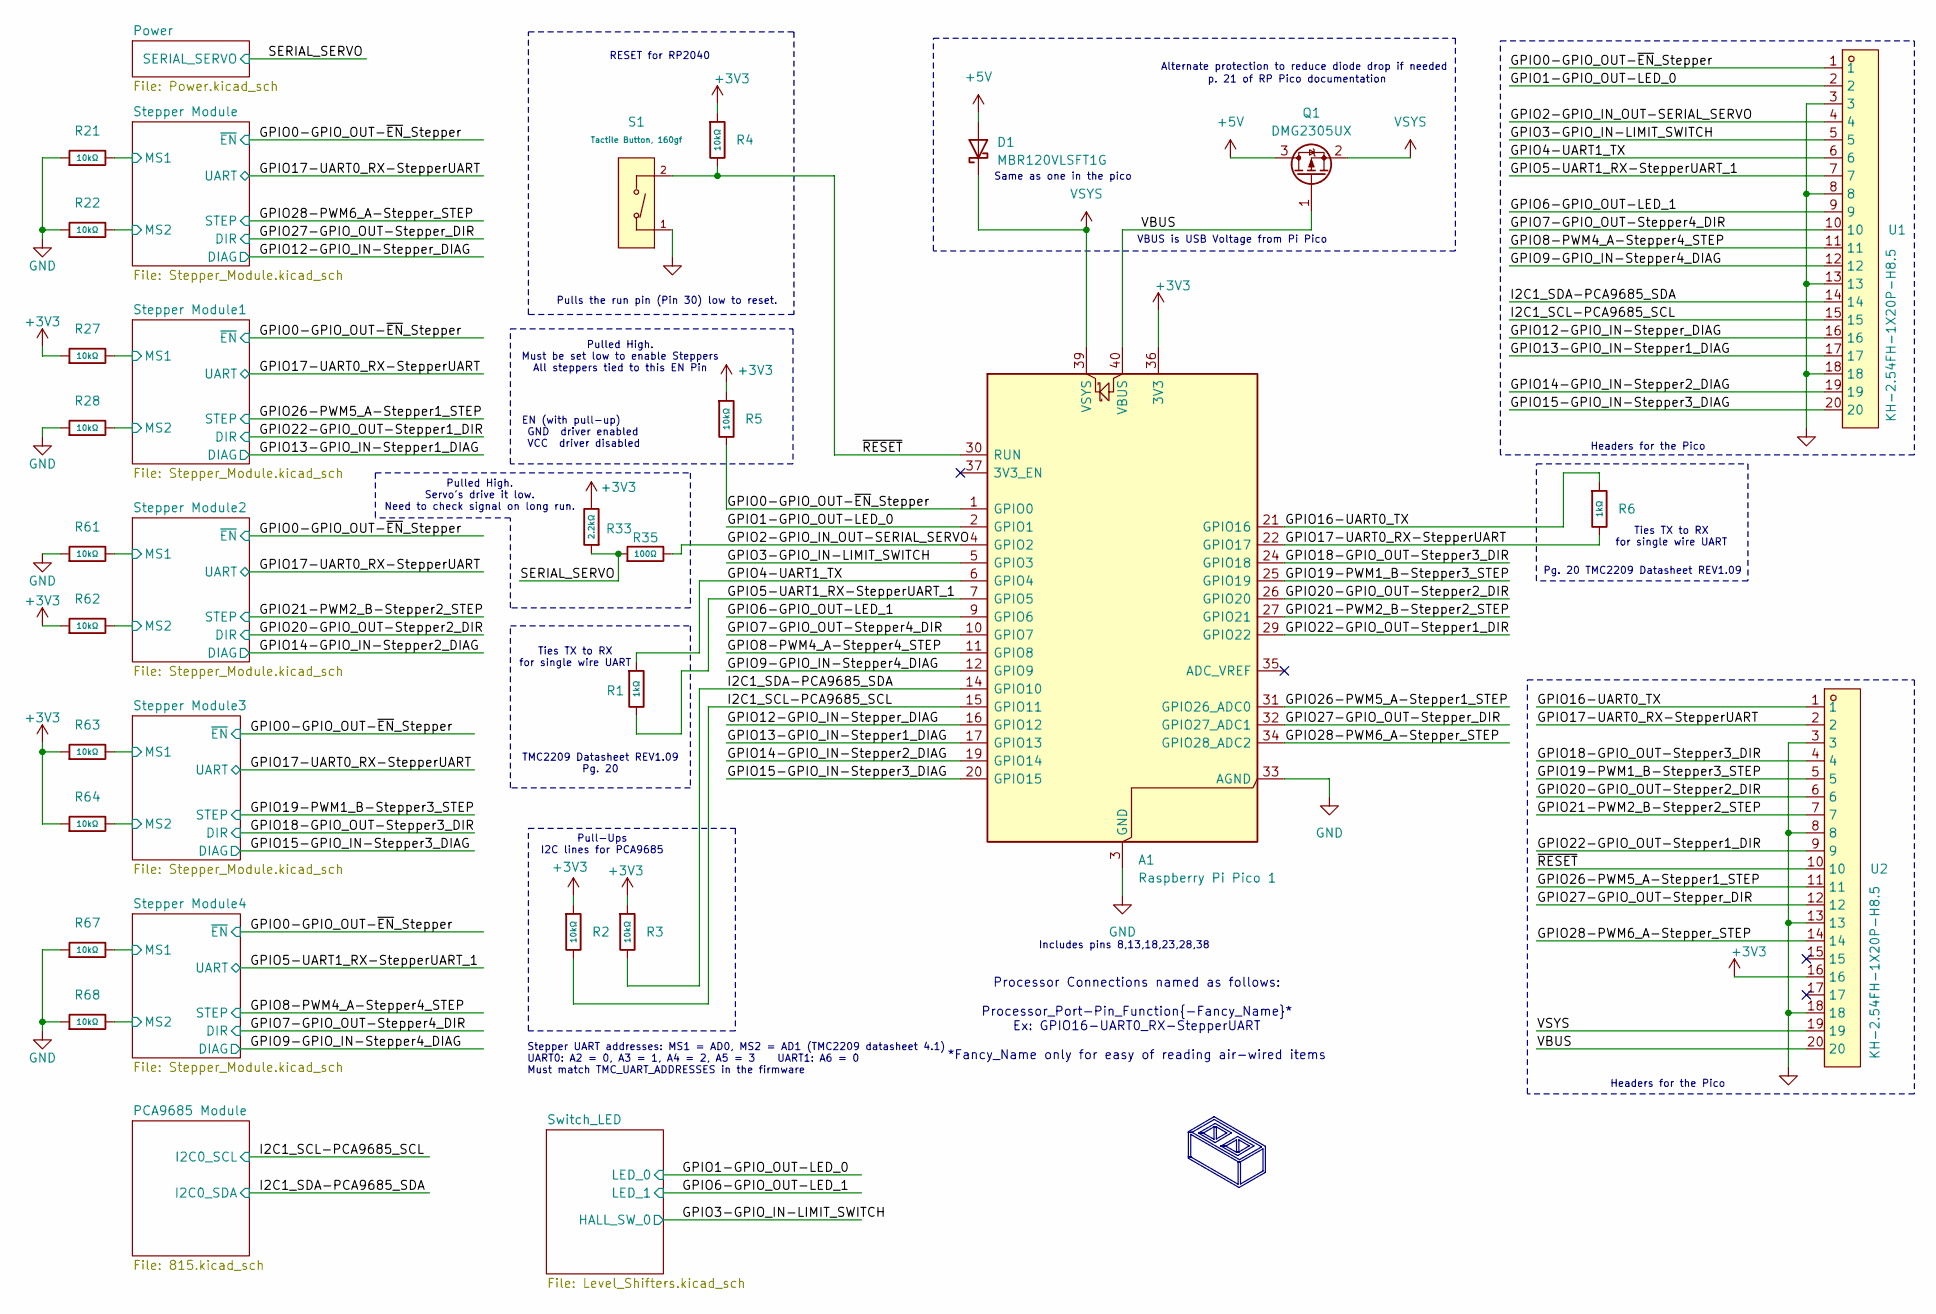
[picture p1: schematic 1_Distribution_Board.kicad_sch, Distribution Board]

Parts:
A1: Raspberry Pi Pico 1; RaspberryPi_Pico_Common_Unspecified
D1: MBR120VLSFT1G; SOD-123; LCSC C223608
Q1: DMG2305UX; SOT-23; LCSC C144153
R1, R6: 1kΩ; R_0603; Overload Voltage (Max) 75V; Tolerance ±1%; Part 0603WAF1001T5E; LCSC C21190
R2, R3, R4, R5, R21, R22, R27, R28, R61, R62, R63, R64, R67, R68: 10kΩ; R_0603; Overload Voltage (Max) 75V; Tolerance ±1%; Part 0603WAF1002T5E; LCSC C25804
R33: 2.2kΩ; R_0603; Overload Voltage (Max) 75V; Tolerance ±1%; Part 0603WAF2201T5E; LCSC C4190
R35: 100Ω; R_0603; Overload Voltage (Max) 75V; Tolerance ±1%; Part 0603WAF1000T5E; LCSC C22775
S1: Tactile Button, 160gf; SW_TS-1088-AR02016; Voltage Rating (Dc) 12V; Part TS-1088-AR02016; LCSC C720477
U1, U2: KH-2.54FH-1X20P-H8.5; HDR-TH_20P-P2.54-V-F-2; LCSC Part C2905423

Connections:
+3V3: A1.36 (3V3), R2.1, R3.1, R4.1, R5.1, R27.1, R33.2, R62.1, R63.1, R64.1, U2.16; also elsewhere on the board
+5V: D1.2 (A), Q1.3 (D); also elsewhere on the board
/GPIO0-GPIO_OUT-~EN_Stepper: A1.1 (GPIO0), R5.2, U1.1; also elsewhere on the board
/GPIO1-GPIO_OUT-LED_0: A1.2 (GPIO1), U1.2; also elsewhere on the board
/GPIO2-GPIO_IN_OUT-SERIAL_SERVO: A1.4 (GPIO2), R35.2, U1.4
/GPIO3-GPIO_IN-LIMIT_SWITCH: A1.5 (GPIO3), U1.5; also elsewhere on the board
/GPIO4-UART1_TX: A1.6 (GPIO4), R1.1, U1.6
/GPIO5-UART1_RX-StepperUART_1: A1.7 (GPIO5), R1.2, U1.7; also elsewhere on the board
/GPIO6-GPIO_OUT-LED_1: A1.9 (GPIO6), U1.9; also elsewhere on the board
/GPIO7-GPIO_OUT-Stepper4_DIR: A1.10 (GPIO7), U1.10; also elsewhere on the board
/GPIO8-PWM4_A-Stepper4_STEP: A1.11 (GPIO8), U1.11; also elsewhere on the board
/GPIO9-GPIO_IN-Stepper4_DIAG: A1.12 (GPIO9), U1.12; also elsewhere on the board
/GPIO12-GPIO_IN-Stepper_DIAG: A1.16 (GPIO12), U1.16; also elsewhere on the board
/GPIO13-GPIO_IN-Stepper1_DIAG: A1.17 (GPIO13), U1.17; also elsewhere on the board
/GPIO14-GPIO_IN-Stepper2_DIAG: A1.19 (GPIO14), U1.19; also elsewhere on the board
/GPIO15-GPIO_IN-Stepper3_DIAG: A1.20 (GPIO15), U1.20; also elsewhere on the board
/GPIO16-UART0_TX: A1.21 (GPIO16), R6.1, U2.1
/GPIO17-UART0_RX-StepperUART: A1.22 (GPIO17), R6.2, U2.2; also elsewhere on the board
/GPIO18-GPIO_OUT-Stepper3_DIR: A1.24 (GPIO18), U2.4; also elsewhere on the board
/GPIO19-PWM1_B-Stepper3_STEP: A1.25 (GPIO19), U2.5; also elsewhere on the board
/GPIO20-GPIO_OUT-Stepper2_DIR: A1.26 (GPIO20), U2.6; also elsewhere on the board
/GPIO21-PWM2_B-Stepper2_STEP: A1.27 (GPIO21), U2.7; also elsewhere on the board
/GPIO22-GPIO_OUT-Stepper1_DIR: A1.29 (GPIO22), U2.9; also elsewhere on the board
/GPIO26-PWM5_A-Stepper1_STEP: A1.31 (GPIO26_ADC0), U2.11; also elsewhere on the board
/GPIO27-GPIO_OUT-Stepper_DIR: A1.32 (GPIO27_ADC1), U2.12; also elsewhere on the board
/GPIO28-PWM6_A-Stepper_STEP: A1.34 (GPIO28_ADC2), U2.14; also elsewhere on the board
/I2C1_SCL-PCA9685_SCL: A1.15 (GPIO11), R2.2, U1.15; also elsewhere on the board
/I2C1_SDA-PCA9685_SDA: A1.14 (GPIO10), R3.2, U1.14; also elsewhere on the board
/SERIAL_SERVO: R33.1, R35.1; also elsewhere on the board
/Stepper Module1/MS1: R27.2; also elsewhere on the board
/Stepper Module1/MS2: R28.2; also elsewhere on the board
/Stepper Module2/MS1: R61.2; also elsewhere on the board
/Stepper Module2/MS2: R62.2; also elsewhere on the board
/Stepper Module3/MS1: R63.2; also elsewhere on the board
/Stepper Module3/MS2: R64.2; also elsewhere on the board
/Stepper Module4/MS1: R67.2; also elsewhere on the board
/Stepper Module4/MS2: R68.2; also elsewhere on the board
/Stepper Module/MS1: R21.2; also elsewhere on the board
/Stepper Module/MS2: R22.2; also elsewhere on the board
/VBUS: A1.40 (VBUS), Q1.1 (G), U2.20
/~RESET: A1.30 (RUN), R4.2, S1.2 (B), U2.10
GND: A1.3 (GND), A1.8 (GND), A1.13 (GND), A1.18 (GND), A1.23 (GND), A1.28 (GND), A1.33 (AGND), A1.38 (GND), R21.1, R22.1, R28.1, R61.1, R67.1, R68.1, S1.1 (A), U1.3, U1.8, U1.13, U1.18, U2.3, U2.8, U2.13, U2.18; also elsewhere on the board
VSYS: A1.39 (VSYS), D1.1 (K), Q1.2 (S), U2.19; also elsewhere on the board

Notes on the sheet:
Processor Connections named as follows: Processor_Port-Pin_Function{-Fancy_Name}* Ex: GPIO16-UART0_RX-StepperUART *Fancy_Name only for easy of reading air-wired items
Pulls the run pin (Pin 30) low to reset.
Ties TX to RX for single wire UART
p. 21 of RP Pico documentation
Pulled High. Servo's drive it low. Need to check signal on long run.
RESET for RP2040
TMC2209 Datasheet REV1.09 Pg. 20
VBUS is USB Voltage from Pi Pico
Pg. 20 TMC2209 Datasheet REV1.09
Stepper UART addresses: MS1 = AD0, MS2 = AD1 (TMC2209 datasheet 4.1) UART0: A2 = 0, A3 = 1, A4 = 2, A5 = 3 UART1: A6 = 0 Must match TMC_UART_ADDRESSES in the firmware
Pulled High. Must be set low to enable Steppers All steppers tied to this EN Pin
Pull-Ups I2C lines for PCA9685
Alternate protection to reduce diode drop if needed
Same as one in the pico
EN (with pull-up) GND driver enabled VCC driver disabled
Includes pins 8,13,18,23,28,38
Headers for the Pico

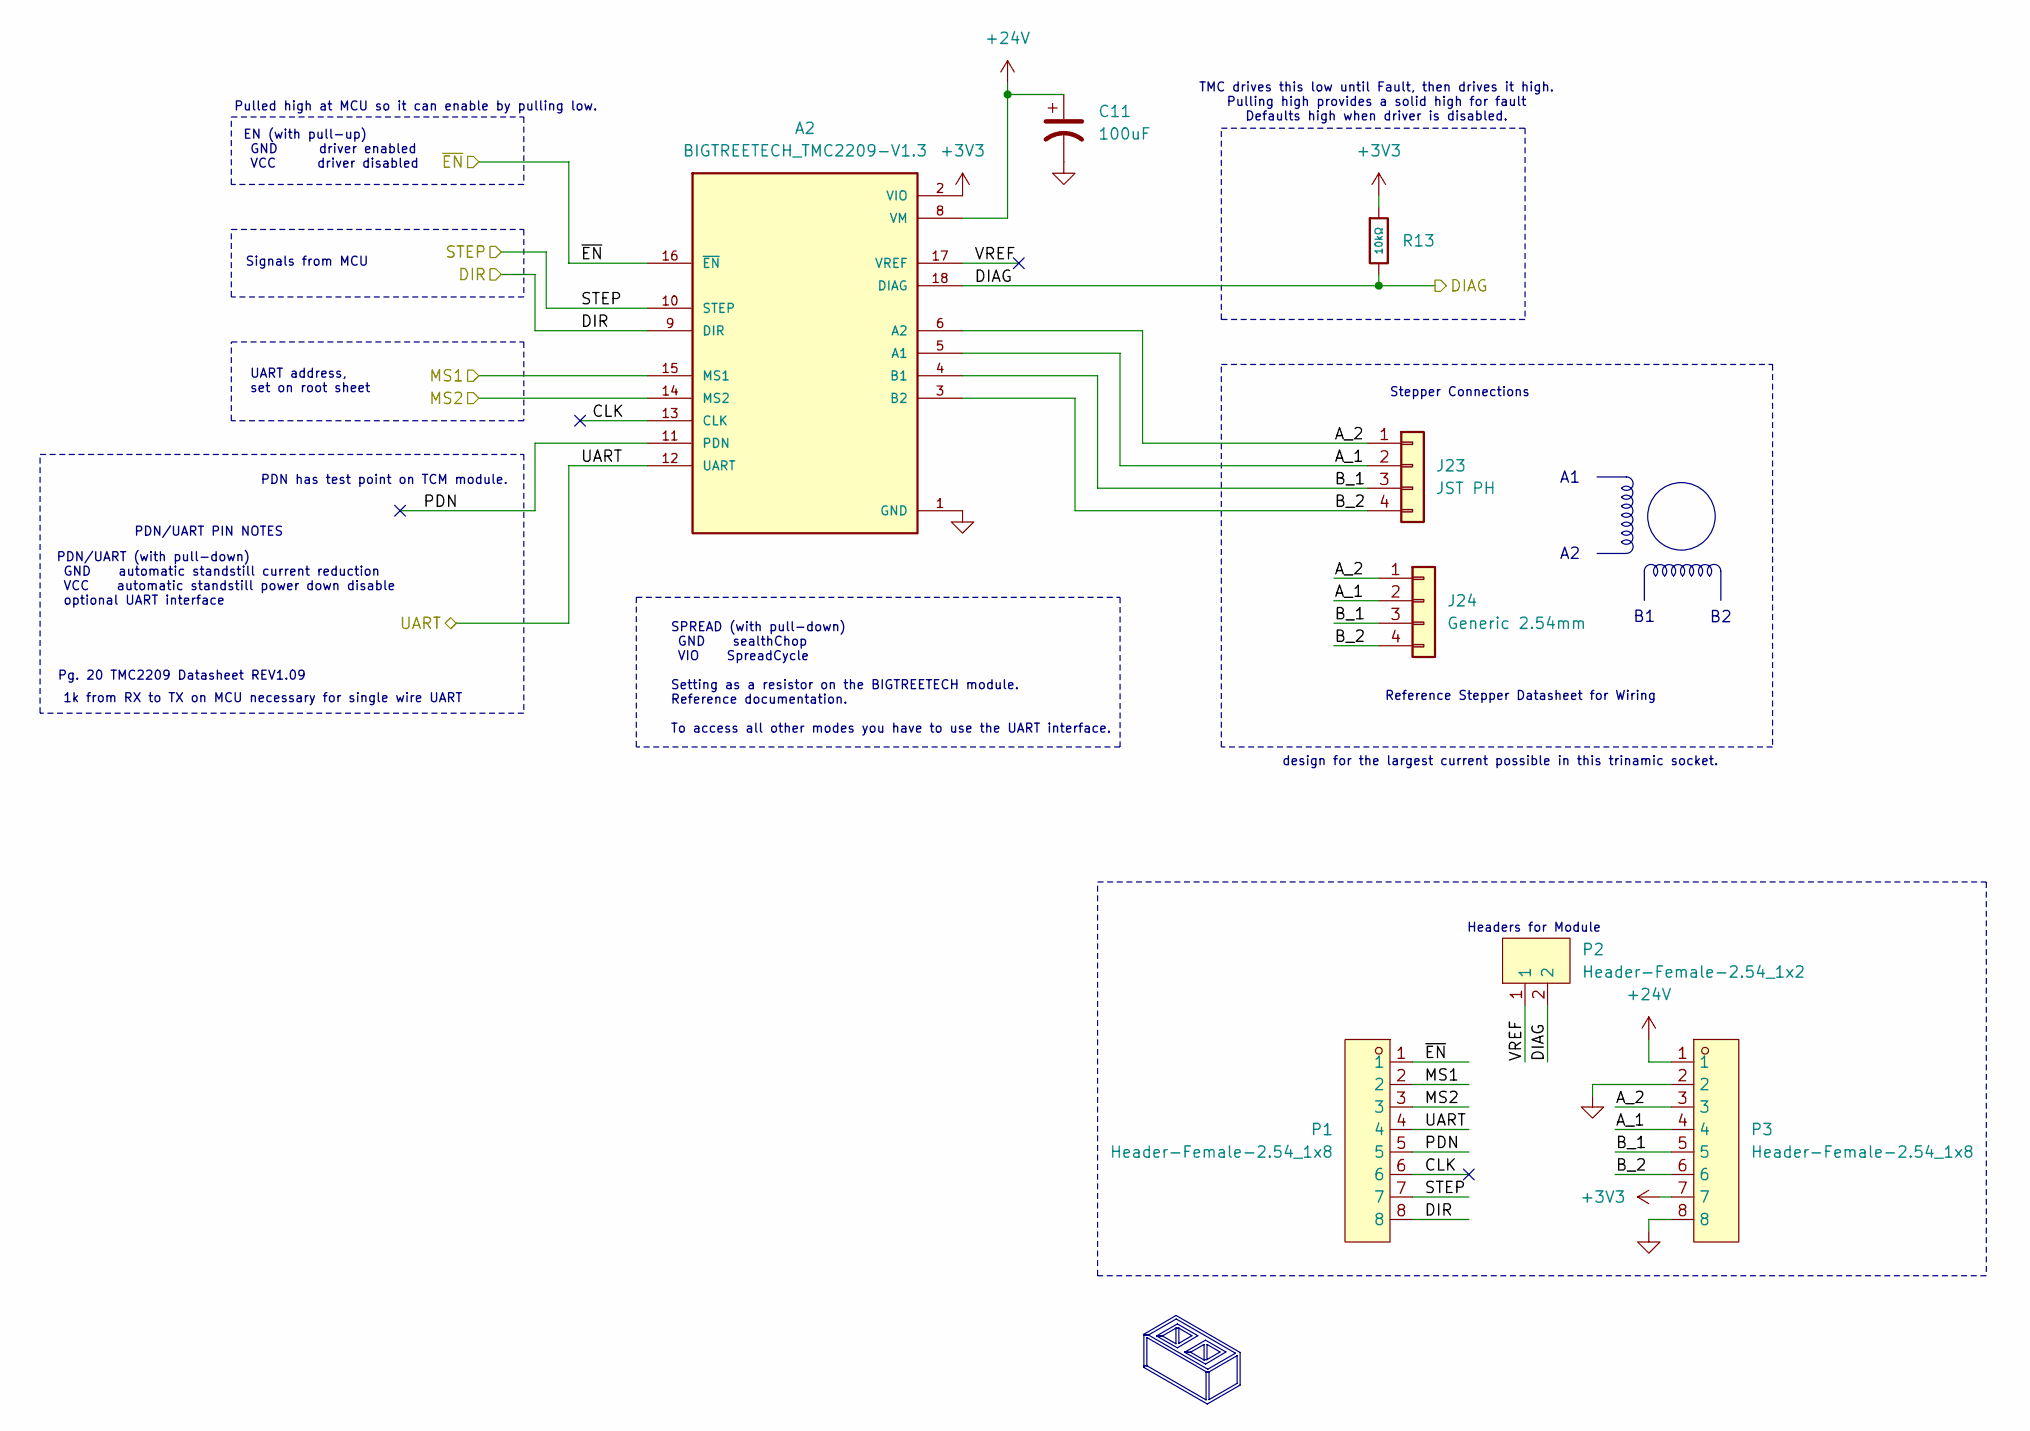
[picture p2: schematic Stepper_Module.kicad_sch, Distribution Board]

Parts:
A2: BIGTREETECH_TMC2209-V1.3; MODULE_TMC2209_SILENTSTEPSTICK; PARTREV 1.3
C11: 100uF; CAP-SMD_BD6.3-L6.6-W6.6-LS7.4-FD; LCSC C2836442
J23: JST PH; JST_PH_B4B-PH-K_1x04_P2.00mm_Vertical; LCSC Part C131334
J24: Generic 2.54mm; PinHeader_1x04_P2.54mm_Vertical; LCSC Part C2691448
P1, P3: Header-Female-2.54_1x8; PinSocket_1x08_P2.54mm_Vertical; LCSC Part C27438
P2: Header-Female-2.54_1x2; PinSocket_1x02_P2.54mm_Vertical; LCSC Part C49661
R13: 10kΩ; R_0603; Overload Voltage (Max) 75V; Tolerance ±1%; Part 0603WAF1002T5E; LCSC C25804

Connections:
+3V3: A2.2 (VIO), P3.7, R13.1; also elsewhere on the board
+24V: A2.8 (VM), C11.1, P3.1; also elsewhere on the board
/GPIO0-GPIO_OUT-~EN_Stepper: A2.16 (~EN), P1.1; also elsewhere on the board
/GPIO12-GPIO_IN-Stepper_DIAG: P2.2, R13.2; also elsewhere on the board
/GPIO17-UART0_RX-StepperUART: P1.4; also elsewhere on the board
/GPIO27-GPIO_OUT-Stepper_DIR: P1.8; also elsewhere on the board
/GPIO28-PWM6_A-Stepper_STEP: P1.7; also elsewhere on the board
/Stepper Module/A_1: J23.2, J24.2, P3.4
/Stepper Module/A_2: J23.1, J24.1, P3.3
/Stepper Module/B_1: J23.3, J24.3, P3.5
/Stepper Module/B_2: J23.4, J24.4, P3.6
/Stepper Module/CLK: P1.6
/Stepper Module/MS1: P1.2; also elsewhere on the board
/Stepper Module/MS2: P1.3; also elsewhere on the board
/Stepper Module/PDN: P1.5
/Stepper Module/VREF: P2.1
GND: A2.1 (GND), A2.7 (GND), C11.2, P3.2, P3.8; also elsewhere on the board

Parts of its further copies:
C12, C13, C14, C15: 100uF; CAP-SMD_BD6.3-L6.6-W6.6-LS7.4-FD; LCSC C2836442
J27, J31, J35, J39: JST PH; JST_PH_B4B-PH-K_1x04_P2.00mm_Vertical; LCSC Part C131334
J28, J32, J36, J40: Generic 2.54mm; PinHeader_1x04_P2.54mm_Vertical; LCSC Part C2691448
P4, P6, P7, P9, P10, P12, P13, P15: Header-Female-2.54_1x8; PinSocket_1x08_P2.54mm_Vertical; LCSC Part C27438
P5, P8, P11, P14: Header-Female-2.54_1x2; PinSocket_1x02_P2.54mm_Vertical; LCSC Part C49661
R16, R65, R66, R71: 10kΩ; R_0603; Overload Voltage (Max) 75V; Tolerance ±1%; Part 0603WAF1002T5E; LCSC C25804

Connections of its further copies:
+3V3: P6.7, P9.7, P12.7, P15.7, R16.1, R65.1, R66.1, R71.1; also elsewhere on the board
+24V: C12.1, C13.1, C14.1, C15.1, P6.1, P9.1, P12.1, P15.1; also elsewhere on the board
/GPIO0-GPIO_OUT-~EN_Stepper: P4.1, P7.1, P10.1, P13.1; also elsewhere on the board
/GPIO5-UART1_RX-StepperUART_1: P13.4; also elsewhere on the board
/GPIO7-GPIO_OUT-Stepper4_DIR: P13.8; also elsewhere on the board
/GPIO8-PWM4_A-Stepper4_STEP: P13.7; also elsewhere on the board
/GPIO9-GPIO_IN-Stepper4_DIAG: P14.2, R71.2; also elsewhere on the board
/GPIO13-GPIO_IN-Stepper1_DIAG: P5.2, R16.2; also elsewhere on the board
/GPIO14-GPIO_IN-Stepper2_DIAG: P8.2, R65.2; also elsewhere on the board
/GPIO15-GPIO_IN-Stepper3_DIAG: P11.2, R66.2; also elsewhere on the board
/GPIO17-UART0_RX-StepperUART: P4.4, P7.4, P10.4; also elsewhere on the board
/GPIO18-GPIO_OUT-Stepper3_DIR: P10.8; also elsewhere on the board
/GPIO19-PWM1_B-Stepper3_STEP: P10.7; also elsewhere on the board
/GPIO20-GPIO_OUT-Stepper2_DIR: P7.8; also elsewhere on the board
/GPIO21-PWM2_B-Stepper2_STEP: P7.7; also elsewhere on the board
/GPIO22-GPIO_OUT-Stepper1_DIR: P4.8; also elsewhere on the board
/GPIO26-PWM5_A-Stepper1_STEP: P4.7; also elsewhere on the board
/Stepper Module1/A_1: J27.2, J28.2, P6.4
/Stepper Module1/A_2: J27.1, J28.1, P6.3
/Stepper Module1/B_1: J27.3, J28.3, P6.5
/Stepper Module1/B_2: J27.4, J28.4, P6.6
/Stepper Module1/CLK: P4.6
/Stepper Module1/MS1: P4.2; also elsewhere on the board
/Stepper Module1/MS2: P4.3; also elsewhere on the board
/Stepper Module1/PDN: P4.5
/Stepper Module1/VREF: P5.1
/Stepper Module2/A_1: J31.2, J32.2, P9.4
/Stepper Module2/A_2: J31.1, J32.1, P9.3
/Stepper Module2/B_1: J31.3, J32.3, P9.5
/Stepper Module2/B_2: J31.4, J32.4, P9.6
/Stepper Module2/CLK: P7.6
/Stepper Module2/MS1: P7.2; also elsewhere on the board
/Stepper Module2/MS2: P7.3; also elsewhere on the board
/Stepper Module2/PDN: P7.5
/Stepper Module2/VREF: P8.1
/Stepper Module3/A_1: J35.2, J36.2, P12.4
/Stepper Module3/A_2: J35.1, J36.1, P12.3
/Stepper Module3/B_1: J35.3, J36.3, P12.5
/Stepper Module3/B_2: J35.4, J36.4, P12.6
/Stepper Module3/CLK: P10.6
/Stepper Module3/MS1: P10.2; also elsewhere on the board
/Stepper Module3/MS2: P10.3; also elsewhere on the board
/Stepper Module3/PDN: P10.5
/Stepper Module3/VREF: P11.1
/Stepper Module4/A_1: J39.2, J40.2, P15.4
/Stepper Module4/A_2: J39.1, J40.1, P15.3
/Stepper Module4/B_1: J39.3, J40.3, P15.5
/Stepper Module4/B_2: J39.4, J40.4, P15.6
/Stepper Module4/CLK: P13.6
/Stepper Module4/MS1: P13.2; also elsewhere on the board
/Stepper Module4/MS2: P13.3; also elsewhere on the board
/Stepper Module4/PDN: P13.5
/Stepper Module4/VREF: P14.1
GND: C12.2, C13.2, C14.2, C15.2, P6.2, P6.8, P9.2, P9.8, P12.2, P12.8, P15.2, P15.8; also elsewhere on the board

Notes on the sheet:
Reference Stepper Datasheet for Wiring
Pg. 20 TMC2209 Datasheet REV1.09
PDN has test point on TCM module.
SPREAD (with pull-down) GND sealthChop VIO SpreadCycle Setting as a resistor on the BIGTREETECH module. Reference documentation. To access all other modes you have to use the UART interface.
PDN/UART (with pull-down) GND automatic standstill current reduction VCC automatic standstill power down disable optional UART interface
Stepper Connections
Signals from MCU
design for the largest current possible in this trinamic socket.
EN (with pull-up) GND driver enabled VCC driver disabled
UART address, set on root sheet
Pulled high at MCU so it can enable by pulling low.
PDN/UART PIN NOTES
Headers for Module
1k from RX to TX on MCU necessary for single wire UART
TMC drives this low until Fault, then drives it high. Pulling high provides a solid high for fault Defaults high when driver is disabled.

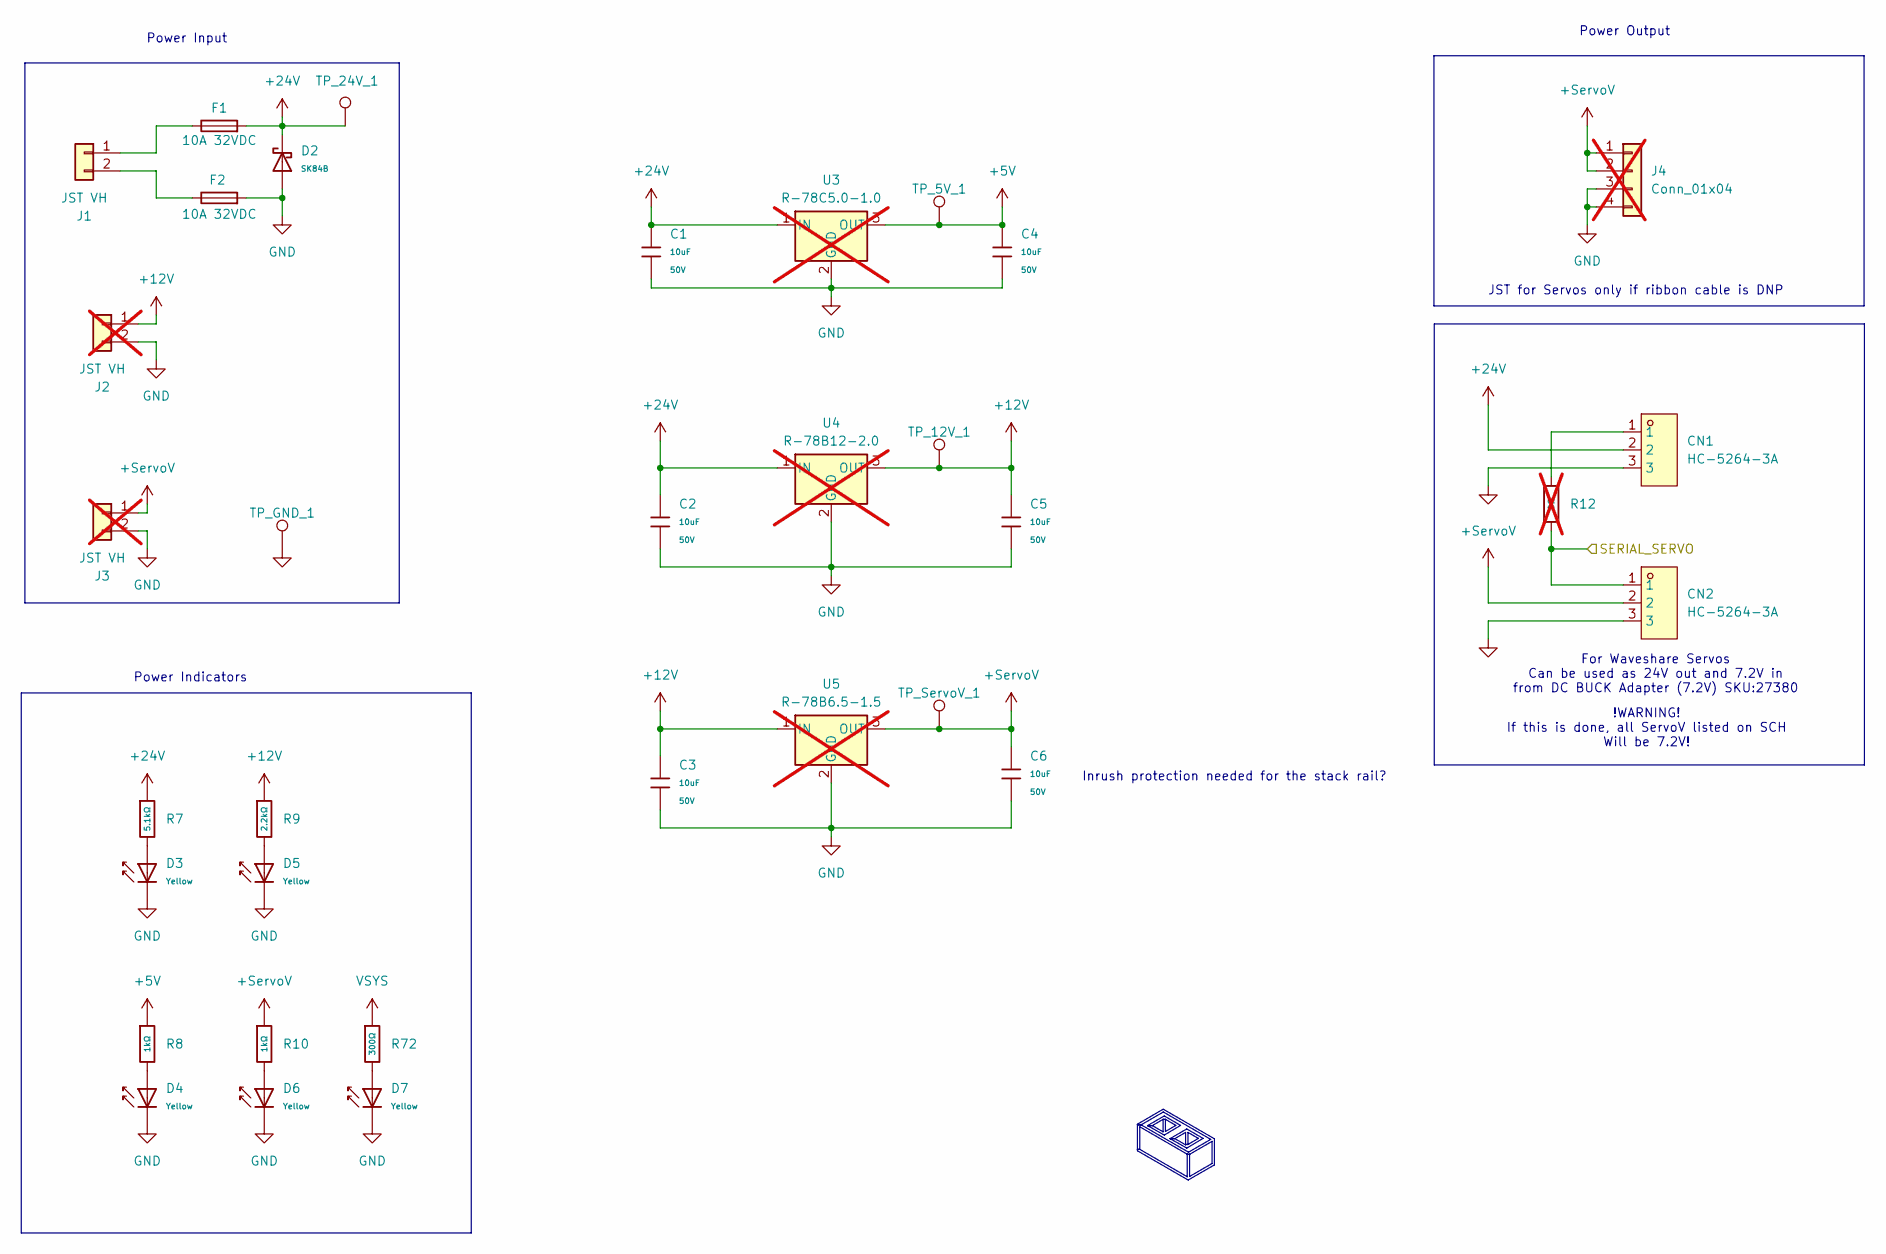
[picture p3: schematic Power.kicad_sch, Distribution Board]

Parts:
C1, C2, C3, C4, C5, C6: 10uF; C_0805; Voltage Rated 50V; Tolerance ±10%; Part GRM21BR61H106KE43L; LCSC C440198
CN1, CN2: HC-5264-3A; CONN-TH_3P-P2.50_HCTL_HC-5264-3A; LCSC Part C2845815
D2: SK84B; D_SMB; Voltage - Forward(Vf@If) 550mV@8.0A; Voltage - DC Reverse(Vr) 40V; Part SK84B; LCSC C41410774
D3, D4, D5, D6, D7: Yellow; D_0603; Forward Voltage (VF) 1.6V~2.6V; Part NCD0603Y2; LCSC C89811
F1, F2: Fuse; Fuse_1206_3216Metric_Pad1.42x1.75mm_HandSolder; Rating 10A 32VDC; LCSC C2925020
J1: JST VH; JST_VH_B2P-VH-FB-B_1x02_P3.96mm_Vertical; LCSC C160315
J2, J3: JST VH; JST_VH_B2P-VH-FB-B_1x02_P3.96mm_Vertical; LCSC C160315; not fitted
J4: Conn_01x04; JST_XA_B04B-XASK-1-A_1x04_P2.50mm_Vertical; LCSC C264994; not fitted
R7: 5.1kΩ; R_0805; Overload Voltage (Max) 150V; Tolerance ±1%; Part 0805W8F5101T5E; LCSC C27834
R8, R10: 1kΩ; R_0805; Overload Voltage (Max) 150V; Tolerance ±1%; Part 0805W8F1001T5E; LCSC C17513
R9: 2.2kΩ; R_0805; Overload Voltage (Max) 150V; Tolerance ±1%; Part 0805W8F2201T5E; LCSC C17520
R12: 0Ω; R_0603; Overload Voltage (Max) 75V; Tolerance ±1%; Part 0603WAF0000T5E; LCSC C21189; not fitted
R72: 300Ω; R_0603; Overload Voltage (Max) 75V; Tolerance ±1%; Part 0603WAF3000T5E; LCSC C23025
TP_5V_1, TP_12V_1, TP_24V_1: PTH; TestPoint_THTPad_D2.0mm_Drill1.0mm
TP_GND_1: PTH; TestPoint_THTPad_D2.0mm_Drill1.0mm
TP_ServoV_1: PTH; TestPoint_THTPad_D2.0mm_Drill1.0mm
U3: R-78C5.0-1.0; Converter_DCDC_RECOM_R-78E-0.5_THT; not fitted
U4: R-78B12-2.0; Converter_DCDC_RECOM_R-78B-2.0_THT; not fitted
U5: R-78B6.5-1.5; Converter_DCDC_RECOM_R-78B-2.0_THT; not fitted

Connections:
+5V: C4.1, R8.1, TP_5V_1.1 (1_1), U3.3 (OUT); also elsewhere on the board
+12V: C3.1, C5.1, J2.1, R9.1, TP_12V_1.1 (1_1), U4.3 (OUT), U5.1 (IN)
+24V: C1.1, C2.1, CN1.2, D2.1, F1.2, R7.1, TP_24V_1.1 (1_1), U3.1 (IN), U4.1 (IN); also elsewhere on the board
+ServoV: C6.1, CN2.2, J3.1, J4.1, J4.2, R10.1, TP_ServoV_1.1 (1_1), U5.3 (OUT); also elsewhere on the board
/SERIAL_SERVO: CN2.1, R12.2; also elsewhere on the board
GND: C1.2, C2.2, C3.2, C4.2, C5.2, C6.2, CN1.3, CN2.3, D2.2, D3.1, D4.1, D5.1, D6.1, D7.1, F2.2, J2.2, J3.2, J4.3, J4.4, TP_GND_1.1 (1_1), U3.2 (GND), U4.2 (GND), U5.2 (GND); also elsewhere on the board
unnamed: CN1.1, R12.1
unnamed: D3.2, R7.2
unnamed: D4.2, R8.2
unnamed: D5.2, R9.2
unnamed: D6.2, R10.2
unnamed: D7.2, R72.2
unnamed: F1.1, J1.1
unnamed: F2.1, J1.2
VSYS: R72.1; also elsewhere on the board

Notes on the sheet:
JST for Servos only if ribbon cable is DNP
Power Output
!WARNING! If this is done, all ServoV listed on SCH Will be 7.2V!
Inrush protection needed for the stack rail?
Power Indicators
For Waveshare Servos Can be used as 24V out and 7.2V in from DC BUCK Adapter (7.2V) SKU:27380
Power Input

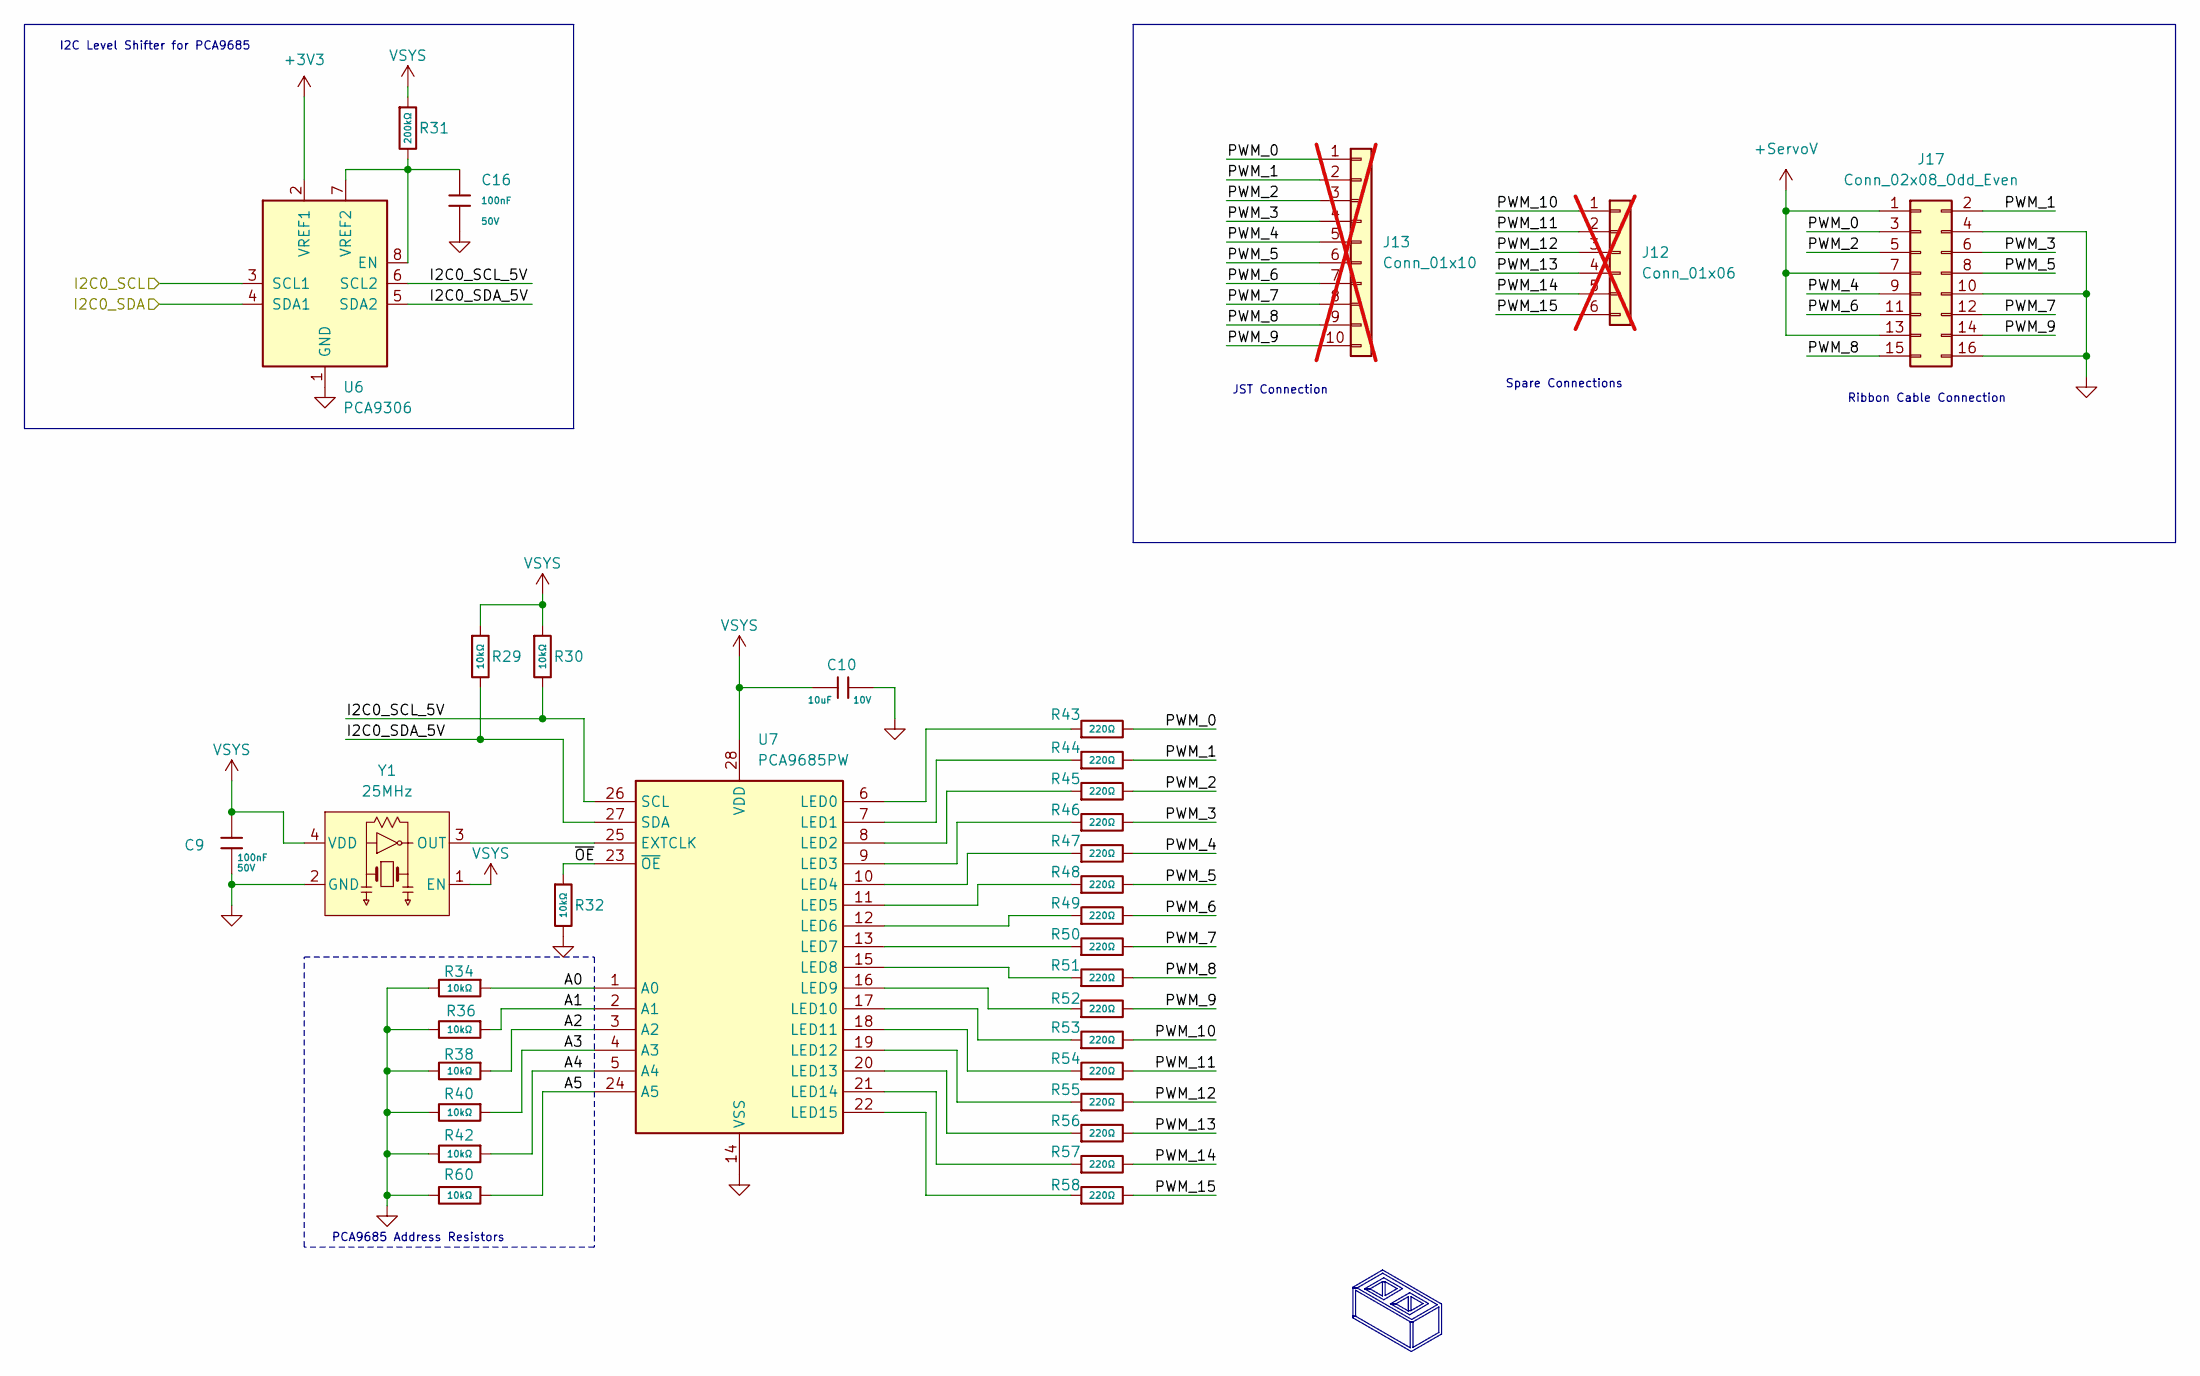
[picture p4: schematic 815.kicad_sch, Distribution Board]

Parts:
C9, C16: 100nF; C_0603; Voltage Rated 50V; Tolerance ±10%; Part CC0603KRX7R9BB104; LCSC C14663
C10: 10uF; C_0603; Voltage Rated 10V; Tolerance ±10%; Part CL10A106KP8NNNC; LCSC C19702
J12: Conn_01x06; PinHeader_1x06_P2.54mm_Vertical; LCSC C37208; not fitted
J13: Conn_01x10; JST_XA_B10B-XASK-1-A_1x10_P2.50mm_Vertical; LCSC C378928; not fitted
J17: Conn_02x08_Odd_Even; IDC-Header_2x08_P2.54mm_Vertical; LCSC C429960
R29, R30, R32, R34, R36, R38, R40, R42, R60: 10kΩ; R_0603; Overload Voltage (Max) 75V; Tolerance ±1%; Part 0603WAF1002T5E; LCSC C25804
R31: 200kΩ; R_0603; Overload Voltage (Max) 75V; Tolerance ±1%; Part 0603WAF2003T5E; LCSC C25811
R43, R44, R45, R46, R47, R48, R49, R50, R51, R52, R53, R54, R55, R56, R57, R58: 220Ω; R_0603; Overload Voltage (Max) 75V; Tolerance ±1%; Part 0603WAF2200T5E; LCSC C22962
U6: PCA9306; Texas_S-PDSO-G8_3x3mm_P0.65mm; LCSC C123752
U7: PCA9685PW; TSSOP-28_4.4x9.7mm_P0.65mm; LCSC C92206
Y1: 25MHz; Crystal_SMD_3.2x2.5mm; MPN SX3M25.000A10F20TNN; LCSC C41361435

Connections:
+3V3: U6.2 (VREF1); also elsewhere on the board
+ServoV: J17.1, J17.7, J17.13; also elsewhere on the board
/I2C1_SCL-PCA9685_SCL: U6.3 (SCL1); also elsewhere on the board
/I2C1_SDA-PCA9685_SDA: U6.4 (SDA1); also elsewhere on the board
/PCA9685 Module/A0: R34.1, U7.1 (A0)
/PCA9685 Module/A1: R36.1, U7.2 (A1)
/PCA9685 Module/A2: R38.1, U7.3 (A2)
/PCA9685 Module/A3: R40.1, U7.4 (A3)
/PCA9685 Module/A4: R42.1, U7.5 (A4)
/PCA9685 Module/A5: R60.1, U7.24 (A5)
/PCA9685 Module/I2C0_SCL_5V: R30.2, U6.6 (SCL2), U7.26 (SCL)
/PCA9685 Module/I2C0_SDA_5V: R29.2, U6.5 (SDA2), U7.27 (SDA)
/PCA9685 Module/PWM_0: J13.1, J17.3, R43.2
/PCA9685 Module/PWM_1: J13.2, J17.2, R44.2
/PCA9685 Module/PWM_2: J13.3, J17.5, R45.2
/PCA9685 Module/PWM_3: J13.4, J17.6, R46.2
/PCA9685 Module/PWM_4: J13.5, J17.9, R47.2
/PCA9685 Module/PWM_5: J13.6, J17.8, R48.2
/PCA9685 Module/PWM_6: J13.7, J17.11, R49.2
/PCA9685 Module/PWM_7: J13.8, J17.12, R50.2
/PCA9685 Module/PWM_8: J13.9, J17.15, R51.2
/PCA9685 Module/PWM_9: J13.10, J17.14, R52.2
/PCA9685 Module/PWM_10: J12.1, R53.2
/PCA9685 Module/PWM_11: J12.2, R54.2
/PCA9685 Module/PWM_12: J12.3, R55.2
/PCA9685 Module/PWM_13: J12.4, R56.2
/PCA9685 Module/PWM_14: J12.5, R57.2
/PCA9685 Module/PWM_15: J12.6, R58.2
/PCA9685 Module/~OE: R32.1, U7.23 (~OE)
GND: C9.1, C10.2, C16.2, J17.4, J17.10, J17.16, R32.2, R34.2, R36.2, R38.2, R40.2, R42.2, R60.2, U6.1 (GND), U7.14 (VSS), Y1.2 (GND); also elsewhere on the board
unnamed: C16.1, R31.2, U6.7 (VREF2), U6.8 (EN)
unnamed: U7.25 (EXTCLK), Y1.3 (OUT)
unnamed: R43.1, U7.6 (LED0)
unnamed: R44.1, U7.7 (LED1)
unnamed: R45.1, U7.8 (LED2)
unnamed: R46.1, U7.9 (LED3)
unnamed: R47.1, U7.10 (LED4)
unnamed: R48.1, U7.11 (LED5)
unnamed: R49.1, U7.12 (LED6)
unnamed: R50.1, U7.13 (LED7)
unnamed: R51.1, U7.15 (LED8)
unnamed: R52.1, U7.16 (LED9)
unnamed: R53.1, U7.17 (LED10)
unnamed: R54.1, U7.18 (LED11)
unnamed: R55.1, U7.19 (LED12)
unnamed: R56.1, U7.20 (LED13)
unnamed: R57.1, U7.21 (LED14)
unnamed: R58.1, U7.22 (LED15)
VSYS: C9.2, C10.1, R29.1, R30.1, R31.1, U7.28 (VDD), Y1.1 (EN), Y1.4 (VDD); also elsewhere on the board

Notes on the sheet:
JST Connection
Spare Connections
I2C Level Shifter for PCA9685
PCA9685 Address Resistors
Ribbon Cable Connection
