jper1679/sorter-v2/electronics/KiCad/1_Distribution_Board/1_Distribution_Board.kicad_pcb

## KiCad design electronics/KiCad/1_Distribution_Board/1_Distribution_Board.kicad_pcb (continued)

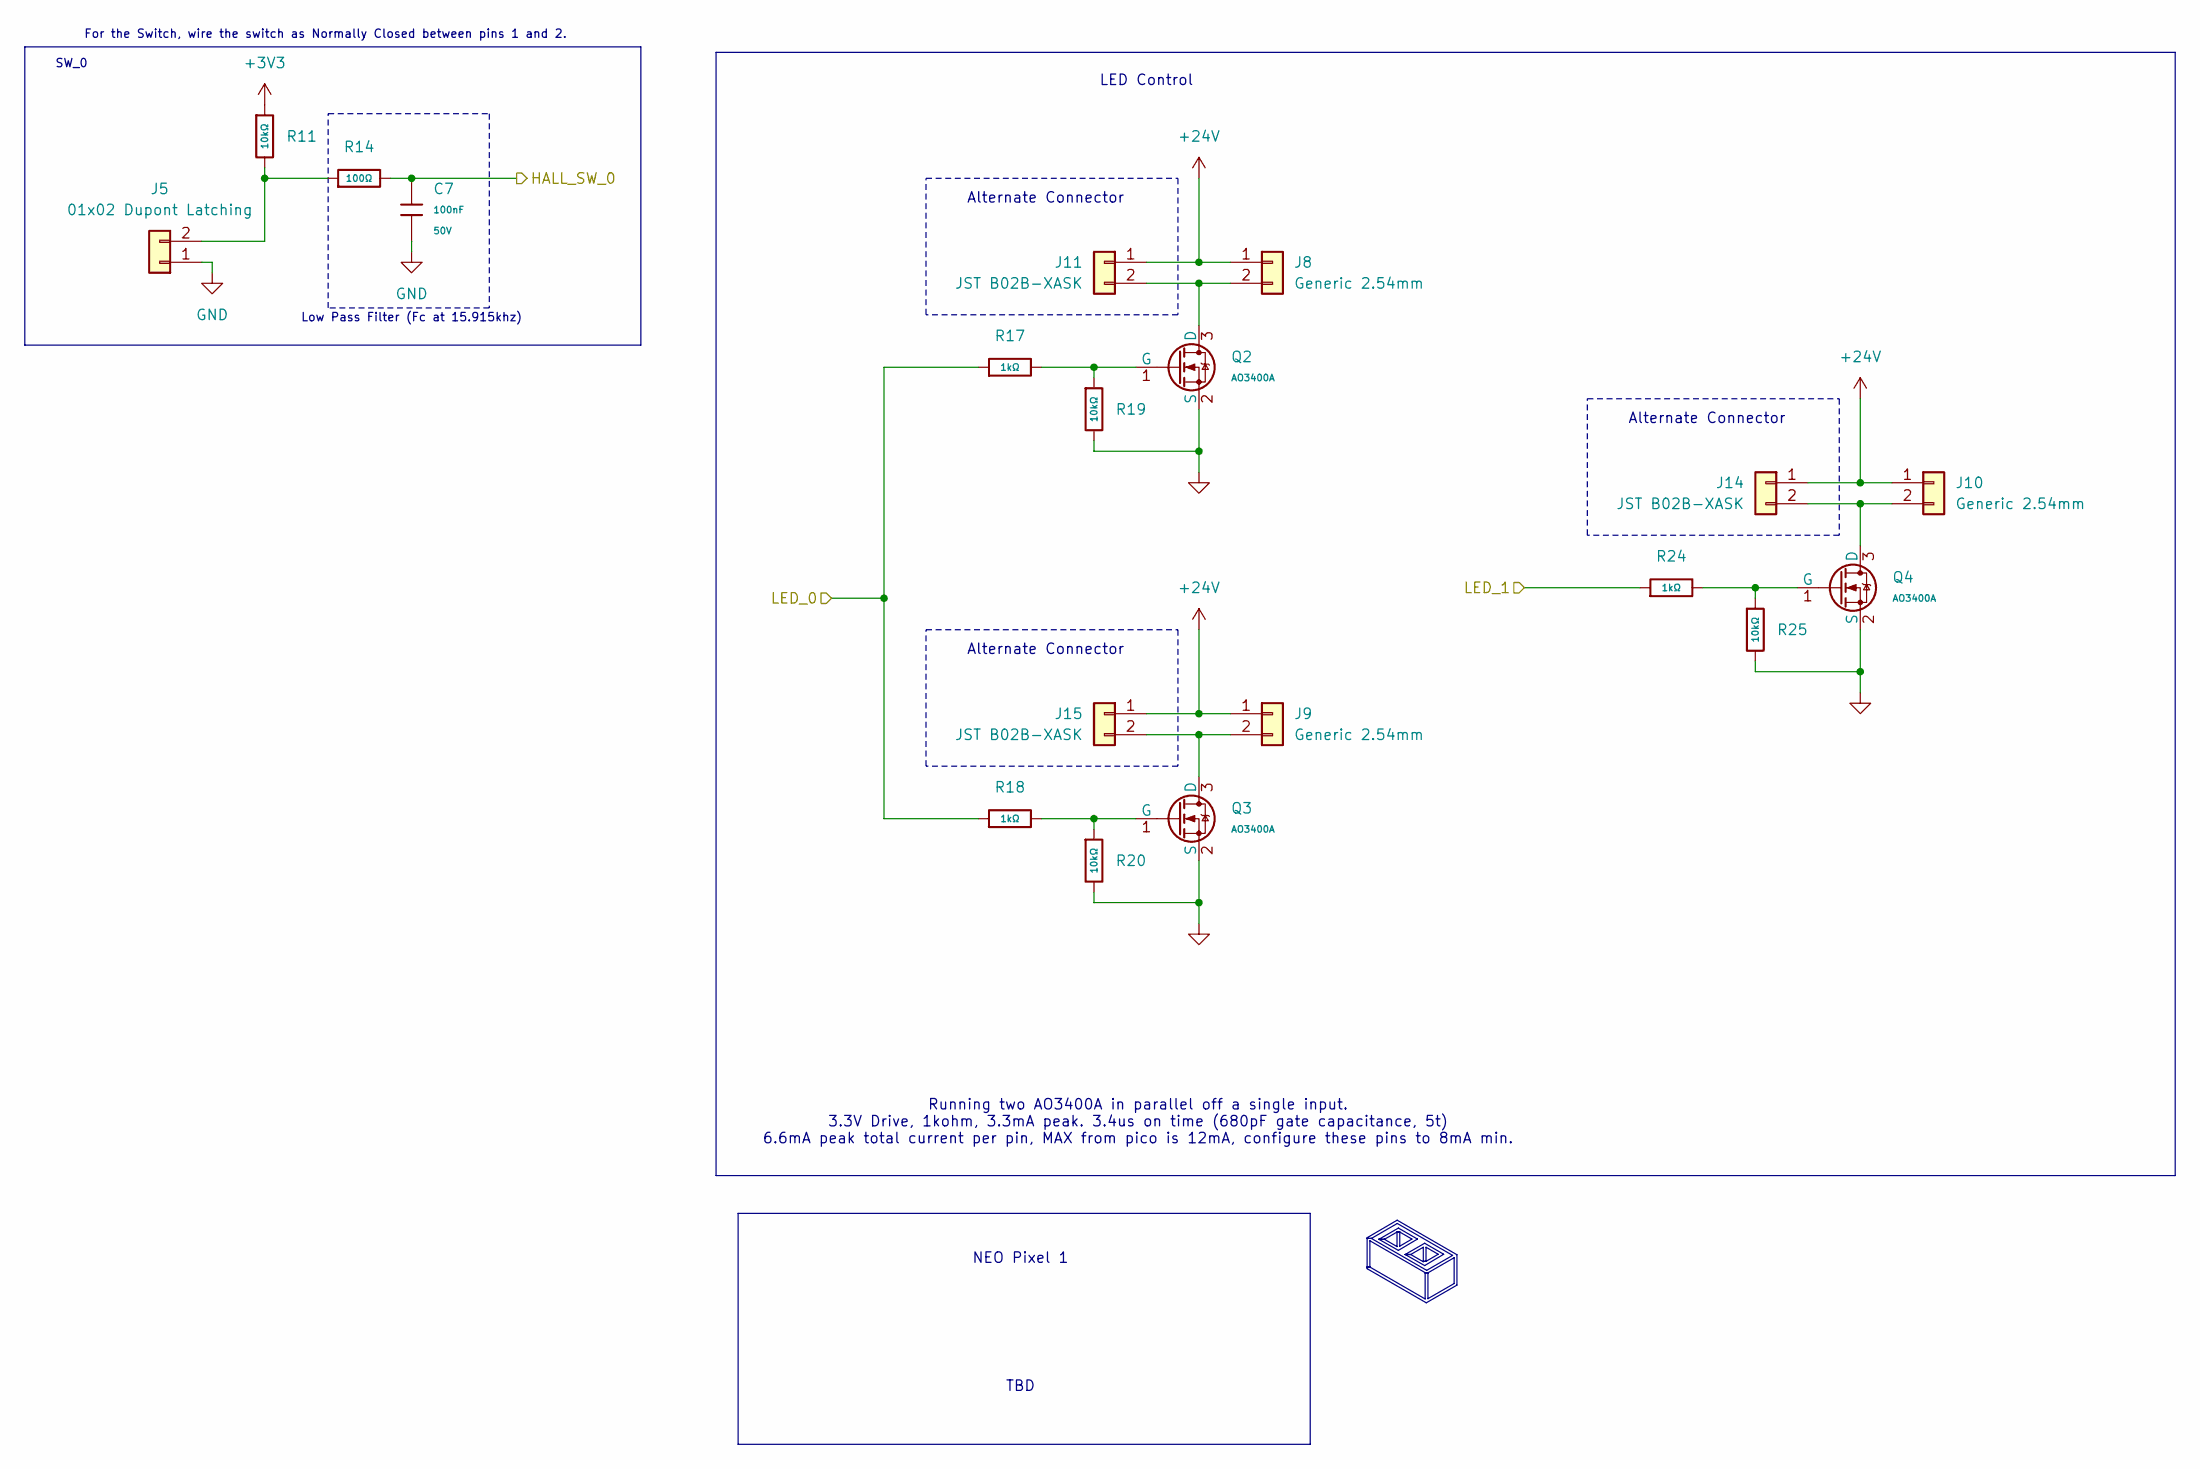
[picture p5: schematic Level_Shifters.kicad_sch, Distribution Board]

Parts:
C7: 100nF; C_0603; Voltage Rated 50V; Tolerance ±10%; Part CC0603KRX7R9BB104; LCSC C14663
J5: 01x02 Dupont Latching; Molex_SL_171971-0002_1x02_P2.54mm_Vertical; LCSC C50129
J8, J9, J10: Generic 2.54mm; PinHeader_1x02_P2.54mm_Vertical; LCSC C492401
J11, J14, J15: JST B02B-XASK; JST_XA_B02B-XASK-1-A_1x02_P2.50mm_Vertical; LCSC C265077
Q2, Q3, Q4: AO3400A; Q_SOT-23; Part AO3400A; LCSC C20917
R11, R19, R20, R25: 10kΩ; R_0603; Overload Voltage (Max) 75V; Tolerance ±1%; Part 0603WAF1002T5E; LCSC C25804
R14: 100Ω; R_0603; Overload Voltage (Max) 75V; Tolerance ±1%; Part 0603WAF1000T5E; LCSC C22775
R17, R18, R24: 1kΩ; R_0603; Overload Voltage (Max) 75V; Tolerance ±1%; Part 0603WAF1001T5E; LCSC C21190

Connections:
+3V3: R11.1; also elsewhere on the board
+24V: J8.1, J9.1, J10.1, J11.1, J14.1, J15.1; also elsewhere on the board
/GPIO1-GPIO_OUT-LED_0: R17.1, R18.1; also elsewhere on the board
/GPIO3-GPIO_IN-LIMIT_SWITCH: C7.1, R14.2; also elsewhere on the board
/GPIO6-GPIO_OUT-LED_1: R24.1; also elsewhere on the board
GND: C7.2, J5.1, Q2.2 (S), Q3.2 (S), Q4.2 (S), R19.2, R20.2, R25.2; also elsewhere on the board
unnamed: J5.2, R11.2, R14.1
unnamed: J10.2, J14.2, Q4.3 (D)
unnamed: J8.2, J11.2, Q2.3 (D)
unnamed: J9.2, J15.2, Q3.3 (D)
unnamed: Q2.1 (G), R17.2, R19.1
unnamed: Q3.1 (G), R18.2, R20.1
unnamed: Q4.1 (G), R24.2, R25.1

Notes on the sheet:
SW_0
Running two AO3400A in parallel off a single input. 3.3V Drive, 1kohm, 3.3mA peak. 3.4us on time (680pF gate capacitance, 5t) 6.6mA peak total current per pin, MAX from pico is 12mA, configure these pins to 8mA min.
Alternate Connector
For the Switch, wire the switch as Normally Closed between pins 1 and 2.
LED Control
Low Pass Filter (Fc at 15.915khz)
TBD
NEO Pixel 1

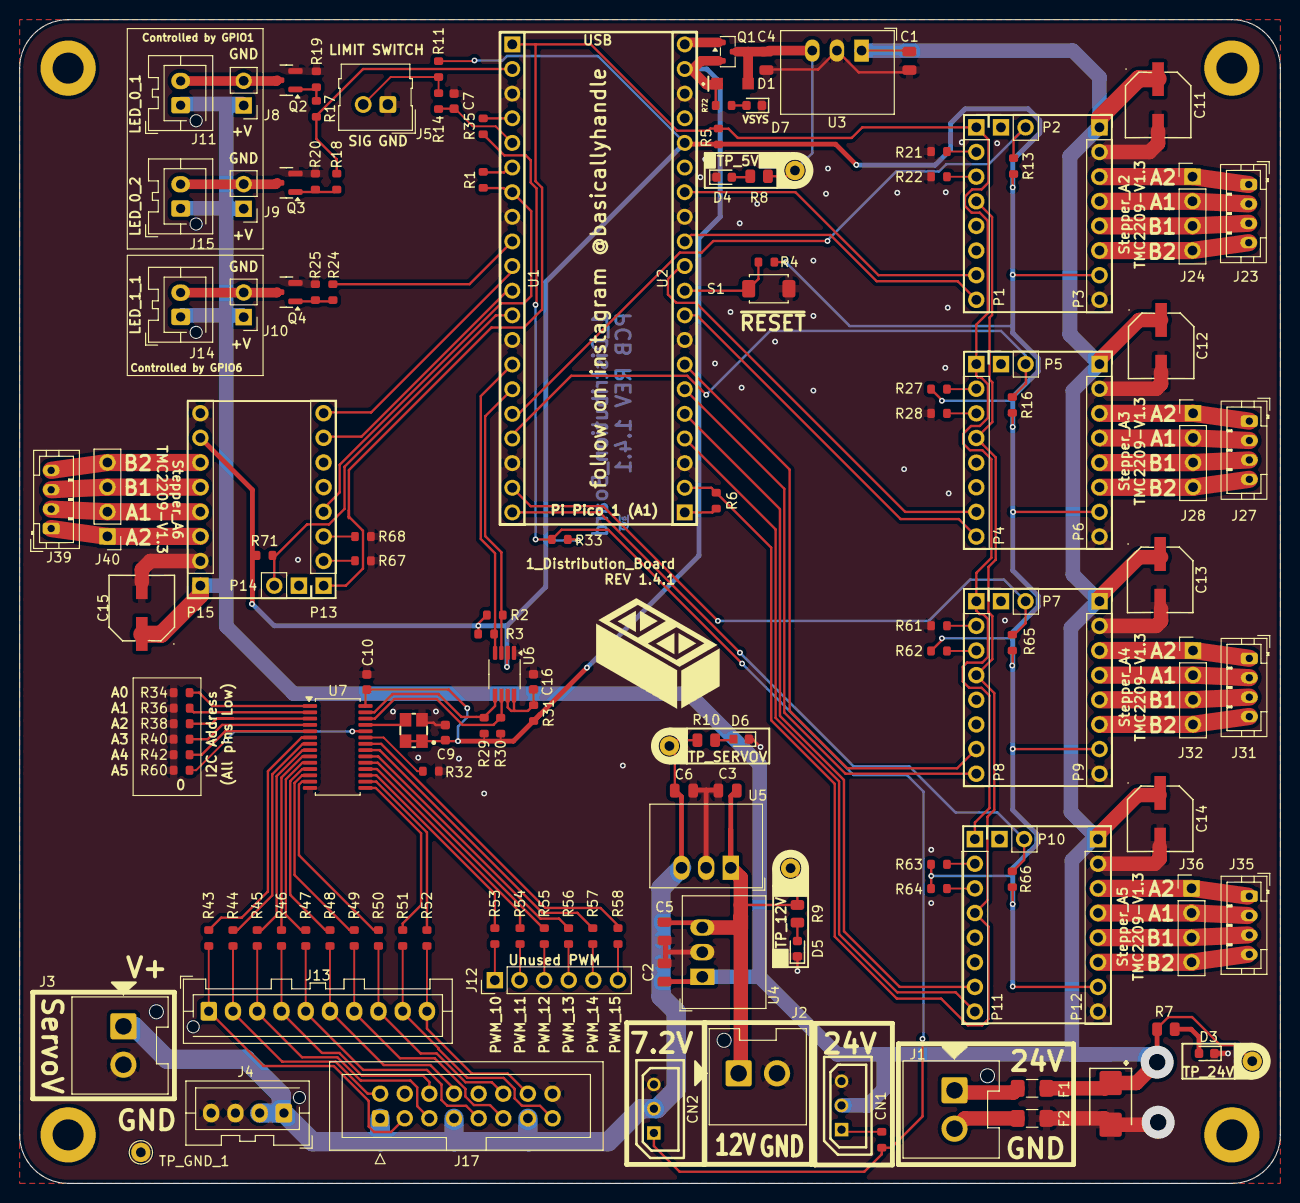
[picture p6: board 1_Distribution_Board.kicad_pcb from above]

Board: 2 copper layers, 130.0 x 120.0 mm, 151 parts (1 on the bottom side), 124 nets.

Other parts of the board:
JAW: Maker's Mark; JAW
M1, M1#2, M1#3, M1#4: MountingHole_3.2mm_M3_ISO7380_Pad
