jper1679/sorter-v2/software/sorter/backend/hardware/sorter_interface.py

"""Implementation of the Sorter Interface hardware drivers"""

# Copyright (c) 2026 Jose I. Romero
#
# Licensed under the MIT License. See LICENSE file in the project root for full license information.


import math
import os
import time
import json
from dataclasses import dataclass
from typing import Protocol
from .bus import MCUDevice, BaseCommandCode
import struct
from global_config import GlobalConfig

# Kill switch for the firmware StallGuard/DIAG path. When set, the backend never
# sends ENABLE_STALL_DETECTION / GET_STALL_STATUS / CLEAR_STALL (0x1A/0x1B/0x1C)
# and never writes SGTHRS/TCOOLTHRS — for boards (e.g. basically v1-1) whose DIAG
# isn't wired, where the v0.6.0 stallguard polling returns corrupt/partial frames
# and fails moves. Read once at import; set in the machine .env before start.
DISABLE_STALLGUARD = os.getenv("DISABLE_STALLGUARD", "0") == "1"

class InterfaceCommandCode(BaseCommandCode):
    """Command codes specific to the Sorter Interface."""
    # Stepper commands
    STEPPER_MOVE_STEPS = 0x10
    STEPPER_MOVE_AT_SPEED = 0x11
    STEPPER_SET_SPEED_LIMITS = 0x12
    STEPPER_SET_ACCELERATION = 0x13
    STEPPER_IS_STOPPED = 0x14
    STEPPER_GET_POSITION = 0x15
    STEPPER_SET_POSITION = 0x16
    STEPPER_HOME = 0x17
    STEPPER_JITTER = 0x18
    STEPPER_IS_JITTERING = 0x19
    STEPPER_ENABLE_STALL_DETECTION = 0x1A
    STEPPER_GET_STALL_STATUS = 0x1B  # channel ignored; returns a per-board stall bitmask
    STEPPER_CLEAR_STALL = 0x1C
    STEPPER_SET_DIAG_PIN = 0x1D  # int8 GPIO, -1 for none; boards keep their own DIAG pins until it is sent
    # Stepper driver commands
    STEPPER_DRV_SET_ENABLED = 0x20
    STEPPER_DRV_SET_MICROSTEPS = 0x21
    STEPPER_DRV_SET_CURRENT = 0x22
    STEPPER_DRV_READ_REGISTER = 0x28
    STEPPER_DRV_WRITE_REGISTER = 0x29
    # Digital I/O commands
    DIGITAL_READ = 0x30
    DIGITAL_WRITE = 0x31
    DIGITAL_WRITE_PWM = 0x32  # payload: uint16 duty (0 = off, 65535 = full on)
    # Servo commands
    SERVO_MOVE_TO = 0x40
    SERVO_SET_SPEED_LIMITS = 0x41
    SERVO_SET_ACCELERATION = 0x42
    SERVO_GET_POSITION = 0x43
    SERVO_IS_STOPPED = 0x44
    SERVO_SET_ENABLED = 0x46
    SERVO_SET_DUTY_LIMITS = 0x47
    SERVO_MOVE_TO_AND_RELEASE = 0x48  # payload: uint16 pos (0.1°), uint16 max_duration_ms (0 = firmware default)


class DigitalInputPin:
    def __init__(self, device: MCUDevice, channel: int, gc: GlobalConfig):
        self._dev = device
        self._channel = channel
        self._gc = gc

    @property
    def value(self):
        res = self._dev.send_command(InterfaceCommandCode.DIGITAL_READ, self._channel, b'')
        return bool(res.payload[0])
    
    @property
    def channel(self):
        return self._channel
    
# Duty is a uint16 on the wire. The firmware wraps its PWM counter at 65534 so
# that 0 is genuinely always-low and DIGITAL_OUTPUT_DUTY_MAX always-high.
DIGITAL_OUTPUT_DUTY_MAX = 65535


class DigitalOutputDevice(Protocol):
    # The whole surface a digital output needs from its board. Narrower than
    # MCUDevice because writes never inspect the response.
    def send_command(self, command: int, channel: int, payload: bytes) -> object: ...


class DigitalOutputPin:
    def __init__(self, device: DigitalOutputDevice, channel: int, gc: GlobalConfig):
        self._dev = device
        self._channel = channel
        self._value = False
        self._duty = 0
        self._enabled = True
        self._pwm_armed = False
        self._gc = gc

    @property
    def value(self):
        return self._value

    @value.setter
    def value(self, value: bool):
        self._value = bool(value)
        self._duty = DIGITAL_OUTPUT_DUTY_MAX if self._value else 0
        self._gc.logger.info(f"DigitalOutput ch{self._channel}: set value={self._value}")
        payload = struct.pack("<?", self._value) # 1 byte, boolean
        self._dev.send_command(InterfaceCommandCode.DIGITAL_WRITE, self._channel, payload)
        # The firmware hands the pad back to SIO on a plain write, so the next
        # duty write has to re-arm PWM mode.
        self._pwm_armed = False

    @property
    def duty(self) -> int:
        return self._duty

    def setDuty(self, duty: int) -> None:
        clamped = max(0, min(DIGITAL_OUTPUT_DUTY_MAX, int(duty)))
        if not self._pwm_armed:
            # The board only routes the pad to its PWM block on the first duty
            # write after a plain one, and it tracks that with a flag that its
            # INIT command does not clear. INIT is what board discovery sends on
            # every host start, and it drives the pad low via SIO — so a board
            # that was left in PWM mode by a previous host process comes back
            # dark with its flag still saying "already PWM", and every later duty
            # write lands on a pad the PWM block no longer drives. Older firmware
            # is out in the field with that bug, so open each process's first duty
            # write with a plain one: it clears the flag on both sides.
            self._dev.send_command(
                InterfaceCommandCode.DIGITAL_WRITE, self._channel, struct.pack("<?", False)
            )
            self._pwm_armed = True
        payload = struct.pack("<H", clamped)
        self._dev.send_command(
            InterfaceCommandCode.DIGITAL_WRITE_PWM, self._channel, payload
        )
        self._duty = clamped
        self._value = clamped > 0
        self._gc.logger.info(f"DigitalOutput ch{self._channel}: set duty={clamped}")

    @property
    def channel(self):
        return self._channel

# What a stepper runs at before anything is configured (Stepper.cpp).
FIRMWARE_DEFAULT_ACCELERATION = 10000
FIRMWARE_DEFAULT_MIN_SPEED = 16


def _controlDataRecordCommand(payload: dict) -> None:
    # Feeder-dynamics capture: every motor command is half of a (state, action)
    # transition. No-op unless a capture segment is open (machine sorting).
    try:
        import time as _time

        import control_data_store

        payload["type"] = "cmd"
        payload["t"] = _time.time()
        payload["mono"] = _time.monotonic()
        control_data_store.record(payload)
    except Exception:
        pass


@dataclass(frozen=True)
class StepperMove:
    """A move the board took: when it was sent (time.monotonic), how many
    microsteps, the speed it cruises at and how long it should take."""

    sent_at: float
    steps: int
    max_speed: int
    duration_s: float


class StepperMotor:
    def __init__(self, device: MCUDevice, channel: int, gc: GlobalConfig):
        self._dev = device
        self._channel = channel
        self._steps_per_revolution = 200
        self._microsteps = 8
        self._enabled = True
        self._name = f"stepper_{channel}"
        self._hardware_name = self._name
        self._direction_inverted = False
        self._current_position_steps = 0
        self._last_set_current: dict[str, int] | None = None
        self._gc = gc
        self.software_disabled = False
        # StallGuard config, stamped from [stepper_stallguard.*] at init by
        # _configureStepper (irl/config.py). The stall monitor reads these to decide which
        # steppers to arm and at what threshold. sgthrs is None => unconfigured.
        self.stallguard_sgthrs: int | None = None
        self.stallguard_tcoolthrs: int = 0xFFFFF
        self.stallguard_enabled: bool = False
        # Live per-stepper stall state, mirrored from the firmware DIAG latch by the
        # stall monitor each poll. The single source of truth for "is this motor
        # stalled" — the operator incident and the per-stepper UI both derive from it.
        self.stalled: bool = False
        # Per-stepper default acceleration, set from StepperConfig at init. Every
        # move re-asserts it (see _ensure_move_acceleration) so a move never runs
        # on a stale acceleration left behind by a prior operation. None means
        # "unmanaged" — leave whatever the firmware currently holds.
        self._default_acceleration: int | None = None
        # Last acceleration we sent to the firmware; lets _ensure_move_acceleration
        # skip the UART write when the value is already correct.
        self._applied_acceleration: int | None = None
        # Moves the firmware refused because the axis was still running. Callers
        # that wait for `stopped` never see one; a rising count is a caller bug.
        self.refused_moves = 0
        # Last speed limits sent. The firmware keeps them until INIT (which only
        # discovery sends, to fresh StepperMotor objects) and jitter restores its
        # own, so an unchanged pair is not sent again before every pulse.
        self._applied_speed_limits: tuple[int, int] | None = None
        # When a move was last commanded (monotonic), and whether the axis was
        # last told to run at a speed until told otherwise. fleet_telemetry reads
        # the driver only while an axis is likely to be moving.
        self.last_commanded_at: float | None = None
        self.running_at_speed = False
        # The last move_steps the board took. The StallGuard tuner reads the
        # driver while one runs.
        self.last_move: StepperMove | None = None

    def _logical_to_physical_steps(self, value: int) -> int:
        return -value if self._direction_inverted else value

    def _physical_to_logical_steps(self, value: int) -> int:
        return -value if self._direction_inverted else value

    def move_degrees(self, degrees: float, *, acceleration: int | None = None, force: bool = False) -> bool:
        """
        Move the stepper by a given number of degrees (positive or negative).
        Uses steps_per_revolution to calculate the number of steps.
        """
        steps = self.microsteps_for_degrees(degrees)
        return self.move_steps(steps, acceleration=acceleration, force=force)

    def move_steps(self, steps: int, *, acceleration: int | None = None, force: bool = False) -> bool:
        """Move the stepper by a given number of microsteps (positive or negative).

        ``acceleration`` overrides the stepper's default for this move only; when
        None the configured per-stepper default is (re-)asserted first.
        """
        if steps == 0:
            return True
        if self.software_disabled and not force:
            self._gc.logger.debug(f"Stepper '{self._name}' ch{self._channel}: move_steps({steps}) suppressed (software_disabled)")
            return True
        self._ensure_move_acceleration(acceleration)
        physical_steps = self._logical_to_physical_steps(steps)
        self._gc.logger.debug(
            f"Stepper '{self._name}' (hw='{self._hardware_name}') ch{self._channel}: "
            f"move_steps logical={steps} physical={physical_steps} microsteps "
            f"({self.degrees_for_microsteps(steps):.2f}°), pos_before={self._current_position_steps}, "
            f"inverted={self._direction_inverted}"
        )
        payload = struct.pack("<i", physical_steps) # 4 bytes, little-endian signed integer
        sent_mono = time.monotonic()
        self.last_commanded_at = sent_mono
        self.running_at_speed = False
        res = self._dev.send_command(InterfaceCommandCode.STEPPER_MOVE_STEPS, self._channel, payload)
        success = len(res.payload) > 0 and bool(res.payload[0])
        if success:
            self._current_position_steps += steps
            # 0 when no speed limits were sent: the board's own, not known here.
            max_speed = self._applied_speed_limits[1] if self._applied_speed_limits else 0
            duration_ms = self.estimateMoveStepsMs(steps, max_speed=max_speed) if max_speed > 0 else 0
            self.last_move = StepperMove(sent_mono, steps, max_speed, duration_ms / 1000.0)
        else:
            self.refused_moves += 1
            self._gc.logger.warning(
                f"Stepper '{self._name}' ch{self._channel}: move_steps({steps}) refused "
                f"(axis busy; {self.refused_moves} refused so far)"
            )
        _controlDataRecordCommand(
            {
                "cmd": "move_steps",
                "stepper": self._name,
                "steps": steps,
                "deg": round(self.degrees_for_microsteps(steps), 3),
                "accel": self._applied_acceleration,
                "success": success,
                "sent_mono": sent_mono,
            }
        )
        return success
    
    def move_at_speed(self, speed: int, *, acceleration: int | None = None, force: bool = False) -> bool:
        """Move the stepper at a given speed in microsteps per second.

        ``acceleration`` overrides the stepper's default for this move only; when
        None the configured per-stepper default is (re-)asserted first. A stop
        (speed 0) leaves acceleration untouched.
        """
        if self.software_disabled and not force:
            self._gc.logger.debug(f"Stepper '{self._name}' ch{self._channel}: move_at_speed({speed}) suppressed (software_disabled)")
            return True
        if speed != 0:
            self._ensure_move_acceleration(acceleration)
        physical_speed = self._logical_to_physical_steps(speed)
        self._gc.logger.debug(
            f"Stepper '{self._name}' (hw='{self._hardware_name}') ch{self._channel}: "
            f"move_at_speed logical={speed} physical={physical_speed} µsteps/s, "
            f"inverted={self._direction_inverted}"
        )
        payload = struct.pack("<i", physical_speed) # 4 bytes, little-endian signed integer
        self.last_commanded_at = time.monotonic()
        self.running_at_speed = speed != 0
        res = self._dev.send_command(InterfaceCommandCode.STEPPER_MOVE_AT_SPEED, self._channel, payload)
        success = bool(res.payload[0])
        if not success:
            self._gc.logger.error(f"Stepper '{self._name}' ch{self._channel}: move_at_speed({speed}) FAILED")
        _controlDataRecordCommand(
            {
                "cmd": "move_at_speed",
                "stepper": self._name,
                "speed": speed,
                "accel": self._applied_acceleration,
                "success": success,
            }
        )
        return success

    def jitter(self, amplitude_steps: int, cycles: int, speed: int, acceleration: int, *, force: bool = False) -> bool:
        """Oscillate +-amplitude_steps microsteps for `cycles` full back-and-forths.

        The firmware runs the oscillation autonomously on its real-time core and
        returns to the starting position. Amplitude is a magnitude; direction is
        symmetric so motor inversion is irrelevant.
        """
        if self.software_disabled and not force:
            self._gc.logger.debug(f"Stepper '{self._name}' ch{self._channel}: jitter suppressed (software_disabled)")
            return True
        amplitude = abs(int(amplitude_steps))
        if amplitude == 0 or cycles <= 0 or speed <= 0 or acceleration <= 0:
            return False
        self._gc.logger.info(
            f"Stepper '{self._name}' (hw='{self._hardware_name}') ch{self._channel}: "
            f"jitter amplitude={amplitude} µsteps ({self.degrees_for_microsteps(amplitude):.2f}°), "
            f"cycles={cycles}, speed={speed} µsteps/s, accel={acceleration} µsteps/s²"
        )
        payload = struct.pack("<iiii", amplitude, int(cycles), int(speed), int(acceleration))
        res = self._dev.send_command(InterfaceCommandCode.STEPPER_JITTER, self._channel, payload)
        success = len(res.payload) > 0 and bool(res.payload[0])
        if not success:
            self._gc.logger.error(f"Stepper '{self._name}' ch{self._channel}: jitter was not acknowledged")
        _controlDataRecordCommand(
            {
                "cmd": "jitter",
                "stepper": self._name,
                "amplitude_steps": amplitude,
                "cycles": int(cycles),
                "speed": int(speed),
                "accel": int(acceleration),
                "success": success,
            }
        )
        return success

    def jitter_degrees(self, amplitude_degrees: float, cycles: int, speed: int, acceleration: int, *, force: bool = False) -> bool:
        """Jitter with the per-stroke amplitude specified in motor degrees."""
        return self.jitter(self.microsteps_for_degrees(abs(amplitude_degrees)), cycles, speed, acceleration, force=force)

    def is_jittering(self) -> bool:
        """True while a jitter run is in progress. Unlike `stopped`, this does not
        flicker between strokes, so it is the reliable gate for refusing a
        follow-up jitter until the current one has actually completed."""
        if self.software_disabled:
            return False
        res = self._dev.send_command(InterfaceCommandCode.STEPPER_IS_JITTERING, self._channel, b'')
        return len(res.payload) > 0 and bool(res.payload[0])

    def set_speed_limits(self, min_speed: int, max_speed: int) -> None:
        """Set the minimum and maximum speed for the stepper in microsteps per second."""
        if (min_speed, max_speed) == self._applied_speed_limits:
            return
        self._gc.logger.debug(f"Stepper '{self._name}' ch{self._channel}: set_speed_limits min={min_speed} max={max_speed} µsteps/s")
        payload = struct.pack("<II", min_speed, max_speed) # 8 bytes, two little-endian unsigned integers
        self._dev.send_command(InterfaceCommandCode.STEPPER_SET_SPEED_LIMITS, self._channel, payload)
        self._applied_speed_limits = (min_speed, max_speed)
        _controlDataRecordCommand(
            {
                "cmd": "set_speed_limits",
                "stepper": self._name,
                "min_speed": min_speed,
                "max_speed": max_speed,
            }
        )

    def set_acceleration(self, acceleration: int) -> None:
        """Set the acceleration for the stepper in microsteps per second squared."""
        self._gc.logger.info(f"Stepper '{self._name}' ch{self._channel}: set_acceleration={acceleration} µsteps/s²")
        payload = struct.pack("<I", acceleration)  # 4 bytes, little-endian unsigned integer
        self._dev.send_command(InterfaceCommandCode.STEPPER_SET_ACCELERATION, self._channel, payload)
        self._applied_acceleration = int(acceleration)
        _controlDataRecordCommand(
            {"cmd": "set_acceleration", "stepper": self._name, "accel": int(acceleration)}
        )

    def set_default_acceleration(self, acceleration: int) -> None:
        """Store the per-stepper default acceleration (µsteps/s²) that every move
        re-asserts. Set from StepperConfig at init; jitter manages its own."""
        self._default_acceleration = int(acceleration)

    @property
    def default_acceleration(self) -> int | None:
        return self._default_acceleration

    def _ensure_move_acceleration(self, override: int | None) -> None:
        """Assert the acceleration to use for an imminent move: the per-call
        ``override`` if given, otherwise the stepper's default. Sends the command
        only when the firmware is not already at that value, so the steady-state
        sorting path adds no extra bus traffic."""
        accel = override if override is not None else self._default_acceleration
        if accel is None or accel == self._applied_acceleration:
            return
        self.set_acceleration(accel)

    @property
    def stopped(self) -> bool:
        """Check if the stepper is stopped."""
        if self.software_disabled:
            return True
        res = self._dev.send_command(InterfaceCommandCode.STEPPER_IS_STOPPED, self._channel, b'')
        return bool(res.payload[0])

    def stopped_force(self) -> bool:
        if self.software_disabled:
            return True
        res = self._dev.send_command(InterfaceCommandCode.STEPPER_IS_STOPPED, self._channel, b'')
        return bool(res.payload[0])
    
    @property
    def position(self) -> int:
        """Get the current position of the stepper in microsteps."""
        res = self._dev.send_command(InterfaceCommandCode.STEPPER_GET_POSITION, self._channel, b'')
        return self._physical_to_logical_steps(struct.unpack("<i", res.payload)[0])

    @position.setter
    def position(self, position: int):
        """Set the current position of the stepper in microsteps."""
        self._gc.logger.info(f"Stepper '{self._name}' ch{self._channel}: set_position={position} microsteps ({self.degrees_for_microsteps(position):.2f}°)")
        payload = struct.pack("<i", self._logical_to_physical_steps(position))
        self._dev.send_command(InterfaceCommandCode.STEPPER_SET_POSITION, self._channel, payload)
    
    @property
    def position_degrees(self) -> float:
        """Get the current position of the stepper in degrees."""
        microsteps = self.position
        steps = microsteps / self._microsteps
        degrees = (steps / self._steps_per_revolution) * 360.0
        return degrees
    
    @position_degrees.setter
    def position_degrees(self, degrees: float):
        """Set the current position of the stepper in degrees."""
        steps = (degrees / 360.0) * self._steps_per_revolution
        microsteps = int(round(steps * self._microsteps))
        self.position = microsteps

    def home(self, home_speed: int, home_pin: DigitalInputPin | int, home_pin_active_high=True, *, force: bool = False):
        """Home the stepper using the specified home pin and speed.

        home_speed: Speed at which to home the stepper in microsteps per second. Positive values move in one direction, negative values move in the opposite direction.
        home_pin: DigitalInputPin object or integer representing the home pin channel.
        home_pin_active_high: Whether the home pin is active high (True) or active low (False).
        """
        if self.software_disabled and not force:
            self._gc.logger.debug(f"Stepper '{self._name}' ch{self._channel}: home() suppressed (software_disabled)")
            return
        # Re-assert driver current before homing. A prior force-halt (jog auto-stop,
        # jitter, stallguard sweep) disables the TMC chopper via DRV_SET_ENABLED;
        # homing would otherwise run the firmware motion state machine against a
        # de-energized motor that never turns and never trips the endstop, so `home`
        # polls `stopped` until it times out. Firmware >= v0.7.0 self-heals this on
        # any move; this keeps older firmware working. No-op cost when already on.
        if force:
            self.enable_force(True)
        else:
            self.enabled = True
        if isinstance(home_pin, DigitalInputPin):
            # If a DigitalInputPin object is provided, use its channel. ONLY IF IT BELONGS TO THE SAME INTERFACE.
            if home_pin._dev != self._dev:
                raise ValueError("home_pin must belong to the same interface as the stepper")
            pin_channel = home_pin._channel
        else:
            pin_channel = home_pin
        
        physical_speed = self._logical_to_physical_steps(home_speed)
        self._gc.logger.info(
            f"Stepper '{self._name}' (hw='{self._hardware_name}') ch{self._channel}: "
            f"home logical_speed={home_speed} physical_speed={physical_speed} µsteps/s, "
            f"pin={pin_channel}, active_high={home_pin_active_high}, inverted={self._direction_inverted}"
        )
        payload = struct.pack("<iB?", physical_speed, pin_channel, bool(home_pin_active_high)) # 4 bytes for speed (signed), 1 byte for pin channel, 1 byte for active high/low
        self._dev.send_command(InterfaceCommandCode.STEPPER_HOME, self._channel, payload)
    
    @property
    def enabled(self) -> bool:
        return self._enabled
    
    @enabled.setter
    def enabled(self, value: bool):
        """Enable or disable the stepper."""
        self._enabled = bool(value)
        if self.software_disabled:
            return
        self._gc.logger.info(f"Stepper '{self._name}' ch{self._channel}: set_enabled={self._enabled}")
        payload = struct.pack("<?", self._enabled) # 1 byte, boolean
        self._dev.send_command(InterfaceCommandCode.STEPPER_DRV_SET_ENABLED, self._channel, payload)

    def enable_force(self, value: bool):
        self._enabled = bool(value)
        self._gc.logger.info(f"Stepper '{self._name}' ch{self._channel}: set_enabled={self._enabled} (force, software_disabled={self.software_disabled})")
        payload = struct.pack("<?", self._enabled)
        self._dev.send_command(InterfaceCommandCode.STEPPER_DRV_SET_ENABLED, self._channel, payload)
    
    def set_microsteps(self, microsteps: int):
        """Set the microsteps for the stepper."""
        if microsteps not in (1, 2, 4, 8, 16, 32, 64, 128, 256):
            raise ValueError(f"Invalid microsteps value: {microsteps}.")
        self._gc.logger.info(f"Stepper '{self._name}' ch{self._channel}: set_microsteps={microsteps}")
        payload = struct.pack("<H", microsteps) # 2 bytes, little-endian unsigned integer
        self._dev.send_command(InterfaceCommandCode.STEPPER_DRV_SET_MICROSTEPS, self._channel, payload)
        self._microsteps = microsteps
    
    def set_current(self, irun: int, ihold: int, ihold_delay: int):
        self._gc.logger.info(f"Stepper '{self._name}' ch{self._channel}: set_current irun={irun} ihold={ihold} ihold_delay={ihold_delay}")
        payload = struct.pack("<BBB", irun, ihold, ihold_delay) # 3 bytes, three little-endian unsigned integers
        self._dev.send_command(InterfaceCommandCode.STEPPER_DRV_SET_CURRENT, self._channel, payload)
        self._last_set_current = {
            "irun": int(irun),
            "ihold": int(ihold),
            "ihold_delay": int(ihold_delay),
        }

    def read_driver_register(self, address: int) -> int:
        # Debug, not info: sweeps and fleet_telemetry read registers many times a second.
        payload = struct.pack("<B", address) # 1 byte, unsigned integer
        res = self._dev.send_command(InterfaceCommandCode.STEPPER_DRV_READ_REGISTER, self._channel, payload)
        val = struct.unpack("<I", res.payload)[0] # 4 bytes, little-endian unsigned integer
        self._gc.logger.debug(f"Stepper '{self._name}' ch{self._channel}: read_driver_register addr=0x{address:02X} -> 0x{val:08X}")
        return val

    def write_driver_register(self, address: int, value: int):
        self._gc.logger.info(f"Stepper '{self._name}' ch{self._channel}: write_driver_register addr=0x{address:02X} value=0x{value:08X}")
        payload = struct.pack("<BI", address, value) # 1 byte for address, 4 bytes for value
        self._dev.send_command(InterfaceCommandCode.STEPPER_DRV_WRITE_REGISTER, self._channel, payload)

    def enable_stall_detection(self, enable: bool) -> None:
        if DISABLE_STALLGUARD:
            return
        payload = struct.pack("<?", enable)
        self._dev.send_command(InterfaceCommandCode.STEPPER_ENABLE_STALL_DETECTION, self._channel, payload)

    def clear_stall(self) -> None:
        if DISABLE_STALLGUARD:
            return
        self._dev.send_command(InterfaceCommandCode.STEPPER_CLEAR_STALL, self._channel, b'')

    def read_stall_latched(self) -> bool:
        """True iff the firmware currently latches a StallGuard/DIAG stall on this
        channel. One UART round-trip reads the whole board's bitmask. The latch is
        sticky until clear_stall(), and a set bit is an unambiguous TMC DIAG stall —
        unlike a rejected move or a garbled ack. Raises on bus error so callers can
        distinguish 'confirmed not stalled' from 'could not read'."""
        if DISABLE_STALLGUARD:
            return False
        get_status = getattr(self._dev, "get_stall_status", None)
        if not callable(get_status):
            return False
        mask = get_status()
        return bool(mask & (1 << self._channel))

    @property
    def steps_per_revolution(self):
        return self._steps_per_revolution
    
    @steps_per_revolution.setter
    def steps_per_revolution(self, value: int):
        if value <= 0:
            raise ValueError("steps_per_revolution must be a positive integer")
        self._steps_per_revolution = value
    
    @property
    def channel(self):
        return self._channel

    @property
    def last_set_current(self) -> dict[str, int] | None:
        if self._last_set_current is None:
            return None
        return dict(self._last_set_current)

    @property
    def current_position_steps(self) -> int:
        """Get the current position in microsteps."""
        return self._current_position_steps

    @property
    def total_steps_per_rev(self) -> int:
        """Get the total microsteps per revolution (considering microsteps)."""
        return self._steps_per_revolution * self._microsteps

    @property
    def name(self) -> str:
        return self._name

    def set_name(self, name: str) -> None:
        """Set a human-readable name for this stepper."""
        self._name = name

    def set_hardware_name(self, name: str) -> None:
        """Set the physical firmware-reported name for this stepper."""
        self._hardware_name = name

    @property
    def hardware_name(self) -> str:
        return self._hardware_name

    @property
    def board_info(self) -> dict:
        return dict(getattr(self._dev, "_board_info", {}))

    def set_direction_inverted(self, inverted: bool) -> None:
        self._direction_inverted = bool(inverted)
        self._gc.logger.info(
            f"Stepper '{self._name}' (hw='{self._hardware_name}') ch{self._channel}: "
            f"set_direction_inverted={self._direction_inverted}"
        )

    @property
    def direction_inverted(self) -> bool:
        return self._direction_inverted

    def move_steps_blocking(self, steps: int, timeout_ms: int = 5000) -> bool:
        """Move the stepper by a given number of microsteps and wait for completion."""
        if steps == 0:
            return True
        if not self.move_steps(steps):
            return False
        start_time = time.time()
        timeout_sec = timeout_ms / 1000.0
        while time.time() - start_time < timeout_sec:
            if self.stopped:
                return True
            time.sleep(0.01)
        return False

    def move_degrees_blocking(self, degrees: float, timeout_ms: int = 5000) -> bool:
        """Move by degrees and wait for completion."""
        steps = self.microsteps_for_degrees(degrees)
        return self.move_steps_blocking(steps, timeout_ms=timeout_ms)

    def estimateMoveStepsMs(self, steps: int, max_speed: int = 5000) -> int:
        """How long the firmware takes to move `steps` microsteps: from the minimum
        speed it accelerates at the stepper's acceleration up to max_speed and
        brakes the same way (Stepper::moveSteps). Distance over top speed alone was
        about 130 ms short on a feeder pulse."""
        distance = abs(steps)
        if distance == 0:
            return 0
        accel = self._applied_acceleration or self._default_acceleration or FIRMWARE_DEFAULT_ACCELERATION
        v0 = self._applied_speed_limits[0] if self._applied_speed_limits else FIRMWARE_DEFAULT_MIN_SPEED
        vmax = max(max_speed, v0)
        ramp = (vmax * vmax - v0 * v0) / (2 * accel)  # microsteps to reach vmax
        if 2 * ramp >= distance:
            peak = math.sqrt(v0 * v0 + accel * distance)
            seconds = 2 * (peak - v0) / accel
        else:
            seconds = 2 * (vmax - v0) / accel + (distance - 2 * ramp) / vmax
        return max(1, int(seconds * 1000))

    def estimateMoveDegreesMs(self, degrees: float, max_speed: int = 5000) -> int:
        """Estimate movement time for a move specified in degrees."""
        steps = self.microsteps_for_degrees(degrees)
        return self.estimateMoveStepsMs(steps, max_speed=max_speed)

    def microsteps_for_degrees(self, degrees: float) -> int:
        """Convert degrees to microsteps using current motor configuration."""
        return int(
            round((degrees / 360.0) * self._steps_per_revolution * self._microsteps)
        )

    def degrees_for_microsteps(self, steps: int) -> float:
        """Convert microsteps to degrees using current motor configuration."""
        return (float(steps) / (self._steps_per_revolution * self._microsteps)) * 360.0


class ServoMotor:
    def __init__(self, device: MCUDevice, channel: int, gc: GlobalConfig):
        self._dev = device
        self._channel = channel
        self._name = f"servo_{channel}"
        # What we think the servo's angle is. None means "unknown" — we have
        # not commanded a move since boot, so we cannot claim to know where it
        # is. Set on every move_to / move_to_and_release (so it tracks open,
        # close, jog, and homing) and surfaced anywhere the servo is reported.
        self._current_angle: int | None = None
        # No factory defaults: a PWM servo must be calibrated (its open and
        # closed angles locked in via the UI) before it is allowed to move.
        # None means "uncalibrated" — open()/close()/toggle() no-op until both
        # angles are set, so a fresh machine never drives a door to a guessed
        # angle that might be mechanically unsafe.
        self._open_angle: int | None = None
        self._closed_angle: int | None = None
        # Configured motion speeds (°/s, None = firmware default). Speed is
        # sticky firmware state, so callers apply the right one before a move:
        # sorting uses open/close speed (apply_open_speed/apply_close_speed),
        # homing and jog use the standard speed (apply_homing_speed).
        self._open_speed: int | None = None
        self._close_speed: int | None = None
        self._homing_speed: int | None = None
        # Track enabled state locally; the firmware does not provide a GET for enabled.
        self._enabled = False
        self._gc = gc

    @property
    def enabled(self) -> bool:
        return self._enabled

    @enabled.setter
    def enabled(self, value: bool):
        bool_value = bool(value)
        self._gc.logger.debug(f"Servo '{self._name}' ch{self._channel}: set_enabled={bool_value}")
        payload = struct.pack("<?", bool_value) # 1 byte, boolean
        self._dev.send_command(InterfaceCommandCode.SERVO_SET_ENABLED, self._channel, payload)
        self._enabled = bool_value

    def move_to(self, angle: int) -> bool:
        """Move the servo to a given angle in degrees (0-180)."""
        if not 0 <= angle <= 180:
            raise ValueError(f"Servo angle must be 0-180, got {angle}")
        if not self._enabled:
            self.enabled = True
        self._gc.logger.info(f"Servo '{self._name}' ch{self._channel}: move_to {angle}° (from {self._current_angle}°)")
        payload = struct.pack("<H", angle * 10)  # Convert degrees to 0.1° units, 2 bytes uint16
        res = self._dev.send_command(InterfaceCommandCode.SERVO_MOVE_TO, self._channel, payload)
        accepted = bool(res.payload[0])
        if not accepted:
            # Firmware rejected the move (servo not idle or disabled). The flap
            # physically stays put, which otherwise leaves no trace — a piece
            # can land in the wrong layer with an apparently clean log.
            self._gc.logger.warning(
                f"Servo '{self._name}' ch{self._channel}: move_to {angle}° REJECTED by firmware "
                f"(servo busy or disabled) — flap did not move"
            )
        else:
            self._current_angle = angle
        return accepted

    def move_to_and_release(self, angle: int, max_duration_ms: int = 3500) -> bool:
        """Move the servo to a given angle and *guarantee* that PWM will stop.

        Two mechanisms ensure the servo will not be left driving indefinitely:

        - If the firmware's motion profile reaches the target, it releases immediately.
        - Hard safety deadline: after `max_duration_ms` the firmware will unconditionally
          cut the PWM signal (duty=0), even if the servo is stalled, blocked, or the
          simulated position never arrived. This is the key protection against the servo
          pulling stall current and overheating.

        A default of 3500 ms is used if not specified. This is long enough for a full
        0-180° move under normal conditions but short enough that a problem cannot cook
        the servo for a long time.
        """
        if not 0 <= angle <= 180:
            raise ValueError(f"Servo angle must be 0-180, got {angle}")
        if max_duration_ms <= 0:
            max_duration_ms = 3500
        if not self._enabled:
            self.enabled = True
        self._gc.logger.info(
            f"Servo '{self._name}' ch{self._channel}: move_to_and_release {angle}° "
            f"(from {self._current_angle}°), max_duration_ms={max_duration_ms}"
        )
        # Wire format: position (0.1°) + max duration in milliseconds
        payload = struct.pack("<HH", angle * 10, max_duration_ms)
        res = self._dev.send_command(InterfaceCommandCode.SERVO_MOVE_TO_AND_RELEASE, self._channel, payload)
        accepted = bool(res.payload[0])
        if not accepted:
            # Firmware rejected the move (servo not idle or disabled). The flap
            # physically stays put, which otherwise leaves no trace — a piece
            # can land in the wrong layer with an apparently clean log.
            self._gc.logger.warning(
                f"Servo '{self._name}' ch{self._channel}: move_to_and_release {angle}° REJECTED by firmware "
                f"(servo busy or disabled) — flap did not move"
            )
            return False
        self._current_angle = angle
        self._enabled = False  # Will be disabled once the move completes (or deadline hits)
        return True

    @property
    def position(self) -> int:
        """Get the current position of the servo in tenths of degrees."""
        res = self._dev.send_command(InterfaceCommandCode.SERVO_GET_POSITION, self._channel, b'')
        return struct.unpack("<H", res.payload)[0] # 2 bytes, little-endian unsigned integer

    def stop(self):
        """Stop the servo and release it: no PWM signal at all.

        The firmware's SERVO_STOP holds the servo at its stored position, and a
        servo nobody has moved since boot is stored at 0°, so stopping one drove
        it to 0° whether or not that is inside its calibrated range.
        """
        self._gc.logger.info(f"Servo '{self._name}' ch{self._channel}: stop and release (was at {self._current_angle}°)")
        self.enabled = False

    @property
    def stopped(self) -> bool:
        """Check if the servo is stopped."""
        res = self._dev.send_command(InterfaceCommandCode.SERVO_IS_STOPPED, self._channel, b'')
        return bool(res.payload[0])

    @property
    def available(self) -> bool:
        return True

    def open(self, open_angle: int | None = None, max_duration_ms: int = 3500) -> bool:
        """Move servo to open position (with hard release deadline guarantee).
        False when it is uncalibrated or the firmware refused the move."""
        target = open_angle if open_angle is not None else self._open_angle
        if target is None:
            self._gc.logger.warning(
                f"Servo '{self._name}' ch{self._channel}: open() ignored — servo is not calibrated"
            )
            return False
        return self.move_to_and_release(target, max_duration_ms=max_duration_ms)

    def close(self, closed_angle: int | None = None, max_duration_ms: int = 3500) -> bool:
        """Move servo to closed position (with hard release deadline guarantee).
        False when it is uncalibrated or the firmware refused the move."""
        target = closed_angle if closed_angle is not None else self._closed_angle
        if target is None:
            self._gc.logger.warning(
                f"Servo '{self._name}' ch{self._channel}: close() ignored — servo is not calibrated"
            )
            return False
        return self.move_to_and_release(target, max_duration_ms=max_duration_ms)

    def toggle(self) -> None:
        """Toggle between open and closed."""
        if not self.is_calibrated:
            self._gc.logger.warning(
                f"Servo '{self._name}' ch{self._channel}: toggle() ignored — servo is not calibrated"
            )
            return
        if self._current_angle == self._open_angle:
            self.close()
        else:
            self.open()

    def isOpen(self) -> bool:
        """Check if servo is in open position."""
        if self._open_angle is None:
            return False
        return self._current_angle == self._open_angle

    def isClosed(self) -> bool:
        """Check if servo is in closed position."""
        if self._closed_angle is None:
            return False
        return self._current_angle == self._closed_angle

    def set_speed_limits(self, min_speed: int, max_speed: int) -> None:
        """Set the minimum and maximum speed for the servo in tenths of degrees per second."""
        if min_speed < 0 or max_speed < 0:
            raise ValueError("Speed limits must be non-negative")
        if min_speed >= max_speed:
            raise ValueError("min_speed must be less than max_speed")
        self._gc.logger.info(f"Servo '{self._name}' ch{self._channel}: set_speed_limits min={min_speed} max={max_speed} 0.1°/s")
        payload = struct.pack("<HH", min_speed, max_speed) # 4 bytes, two little-endian unsigned integers
        self._dev.send_command(InterfaceCommandCode.SERVO_SET_SPEED_LIMITS, self._channel, payload)

    def set_motion_speeds(
        self,
        open_speed: int | None,
        close_speed: int | None,
        homing_speed: int | None,
    ) -> None:
        """Store the configured open/close/homing speeds (°/s). These are not
        pushed to the firmware here — a caller applies the relevant one with
        apply_open_speed/apply_close_speed/apply_homing_speed before its move."""
        self._open_speed = open_speed
        self._close_speed = close_speed
        self._homing_speed = homing_speed

    def _apply_speed_deg_s(self, speed_deg_s: int | None) -> None:
        if speed_deg_s is None:
            return
        # Floor of 10 (1°/s) matches _SERVO_SPEED_FLOOR_TENTHS in the router.
        self.set_speed_limits(10, speed_deg_s * 10)

    def apply_open_speed(self) -> None:
        self._apply_speed_deg_s(self._open_speed)

    def apply_close_speed(self) -> None:
        self._apply_speed_deg_s(self._close_speed)

    def apply_homing_speed(self) -> None:
        self._apply_speed_deg_s(self._homing_speed)

    def set_acceleration(self, acceleration: int) -> None:
        """Set the acceleration for the servo in tenths of degrees per second squared."""
        self._gc.logger.info(f"Servo '{self._name}' ch{self._channel}: set_acceleration={acceleration} 0.1°/s²")
        payload = struct.pack("<H", acceleration)  # 2 bytes, little-endian unsigned integer
        self._dev.send_command(InterfaceCommandCode.SERVO_SET_ACCELERATION, self._channel, payload)

    def set_duty_limits(self, min_duty_us: int, max_duty_us: int) -> None:
        """Set the minimum and maximum duty cycle for the servo in microseconds.

         min_duty_us: Pulse width in microseconds (e.g. 1000 for 1ms) for the minimum position (0 degrees)
         max_duty_us: Pulse width in microseconds (e.g. 2000 for 2ms) for the maximum position (180 degrees)
        """
        if min_duty_us < 0 or max_duty_us < 0:
            raise ValueError("Duty limits must be non-negative")
        if min_duty_us >= max_duty_us:
            raise ValueError("min_duty_us must be less than max_duty_us")
        if max_duty_us > 20000:
            raise ValueError("max_duty_us must be less than or equal to 20000 (20ms period)")
        # Convert pulse widths (in microseconds) to PCA9685 12-bit counts (0-4095)
        # assuming a 20ms period (50Hz): counts = (pulse_us / 20000us) * 4095.
        min_duty = int((min_duty_us / 20000.0) * 4095)
        max_duty = int((max_duty_us / 20000.0) * 4095)
        self._gc.logger.info(f"Servo '{self._name}' ch{self._channel}: set_duty_limits {min_duty_us}µs-{max_duty_us}µs (counts {min_duty}-{max_duty})")
        payload = struct.pack("<HH", min_duty, max_duty)  # 4 bytes, two little-endian unsigned integers
        self._dev.send_command(InterfaceCommandCode.SERVO_SET_DUTY_LIMITS, self._channel, payload)

    def set_name(self, name: str) -> None:
        """Set a human-readable name for this servo."""
        self._name = name

    def set_preset_angles(self, open_angle: int | None, closed_angle: int | None) -> None:
        """Set the open and closed preset angles."""
        self._open_angle = open_angle
        self._closed_angle = closed_angle

    def set_open_angle(self, angle: int | None) -> None:
        """Lock in (or clear) the open-position angle without touching closed."""
        self._open_angle = angle

    def set_closed_angle(self, angle: int | None) -> None:
        """Lock in (or clear) the closed-position angle without touching open."""
        self._closed_angle = angle

    @property
    def open_angle(self) -> int | None:
        return self._open_angle

    @property
    def closed_angle(self) -> int | None:
        return self._closed_angle

    @property
    def requires_calibration(self) -> bool:
        return True

    @property
    def is_calibrated(self) -> bool:
        return self._open_angle is not None and self._closed_angle is not None

    @property
    def angle(self) -> int | None:
        """What we think the current servo angle is, or None if unknown
        (no move commanded since boot)."""
        return self._current_angle

    @property
    def channel(self):
        return self._channel


class SorterInterface(MCUDevice):
    steppers : tuple[StepperMotor, ...]
    servos: tuple[ServoMotor, ...]
    digital_inputs : tuple[DigitalInputPin, ...]
    digital_outputs : tuple[DigitalOutputPin, ...]

    def __init__(self, bus, address, gc: GlobalConfig):
        super().__init__(bus, address)
        self._gc = gc
        self._observability_info: dict | None = None
        # Obtain the device information to populate the internal objects
        retries = 5
        while retries > 0:
            try:
                self._board_info = self.detect()
                break
            except Exception as e:
                gc.logger.warning(f"Error initializing device: {e}. Retrying...")
                retries -= 1
                time.sleep(0.1)
        else:
            raise RuntimeError("Failed to initialize device.")
        # Populate the objects for all the capabilities based on the detected information
        digital_input_channels = range(self._board_info.get("digital_input_count", 0))
        digital_output_channels = range(self._board_info.get("digital_output_count", 0))
        stepper_channels = range(self._board_info.get("stepper_count", 0))
        servo_channels = range(self._board_info.get("servo_count", 0))
        self.digital_inputs = tuple(DigitalInputPin(self, ch, gc) for ch in digital_input_channels)
        self.digital_outputs = tuple(DigitalOutputPin(self, ch, gc) for ch in digital_output_channels)
        self.steppers = tuple(StepperMotor(self, ch, gc) for ch in stepper_channels)
        self.servos = tuple(ServoMotor(self, ch, gc) for ch in servo_channels)
        # Read the device name from the board info, or use a default name based on the address if not provided
        self._name = self._board_info.get("device_name", f"SorterInterface_{address}")
        self.hw_id: str = self._board_info.get("hw", "unknown")

    def shutdown(self):
        for dout in self.digital_outputs:
            dout.value = False

    @property
    def name(self):
        return self._name

    @property
    def board_info(self) -> dict:
        return dict(self._board_info)

    def get_stall_status(self) -> int:
        """Return this board's stall bitmask: bit i set => stepper channel i is
        latched-stalled. One bus round-trip covers every channel on the board.
        Channel arg is ignored by the firmware, so we send 0."""
        if DISABLE_STALLGUARD:
            return 0
        res = self.send_command(InterfaceCommandCode.STEPPER_GET_STALL_STATUS, 0, b"")
        return res.payload[0] if res.payload else 0

    def get_observability_info(self, *, force_refresh: bool = False) -> dict:
        if self._observability_info is not None and not force_refresh:
            return dict(self._observability_info)
        response = self.send_command(BaseCommandCode.GET_OBSERVABILITY, 0, b"")
        payload = json.loads(response.payload.decode())
        if not isinstance(payload, dict):
            payload = {}
        self._observability_info = payload
        return dict(payload)

if __name__ == "__main__":
    import logging as _logging
    import random
    import time
    from .bus import MCUBus
    from global_config import mkGlobalConfig

    _logging.basicConfig(level=_logging.INFO)
    _gc = mkGlobalConfig()

    interfaces: dict[str, SorterInterface] = {}

    print("Enumerating buses...")
    buses = MCUBus.enumerate_buses()
    print(f"Available buses: {buses}")
    if not buses:
        print("No buses found, exiting.")
    else:
        print(f"Testing bus on port {buses[0]}...")
        bus = MCUBus(port=buses[0])
        devices = bus.scan_devices()
        print(f"Devices found: {devices}")
        for device in devices:
            try:
                interface = SorterInterface(bus, device, _gc)
                interfaces[interface.name] = interface
                print(f"Initialized interface: {interface.name}")
            except Exception as e:
                _logging.error(f"Error initializing device at address {device}: {e}")
                continue
        _logging.info(f"Finished initializing interfaces: {list(interfaces.keys())}")
        start_time = time.monotonic()
        while True:
            now = time.monotonic()
            elapsed = now - start_time
            if elapsed > 1:
                for name, interface in interfaces.items():
                    _logging.info(f"Interface {name}:")
                    for i, stepper in enumerate(interface.steppers):
                        _logging.info(f"  Stepper {i}: position={stepper.position}, stopped={stepper.stopped}")
                    for i, dout in enumerate(interface.digital_outputs):
                        _logging.info(f"  Digital Output {i}: value={dout.value}")
                    for i, din in enumerate(interface.digital_inputs):
                        _logging.info(f"  Digital Input {i}: value={din.value}")
                start_time = now
            for name, interface in interfaces.items():
                if interface.servos and all(servo.stopped for servo in interface.servos):
                    for servo in interface.servos:
                        servo.enabled = True
                        servo.set_speed_limits(100, 20000) # Set speed limits to 10-2000 degrees per second
                        servo.set_acceleration(2000)
                        angle = random.choice([0, 90, 180]) # Move to either 0, 90, or 180 degrees
                        _logging.info(f"Moving servo {servo.channel} on interface {name} to {angle} degrees")
                        servo.move_to_and_release(angle)

                for stepper in interface.steppers:
                    if not stepper.stopped:
                        continue
                    # Randomly decide to move the stepper
                    steps = random.randint(-1000, 1000)
                    _logging.info(f"Moving stepper {stepper.channel} on interface {name} by {steps} steps")
                    stepper.move_steps(steps)
            time.sleep(0.01)
