jper1679/sorter-v2/software/firmware/sorter_interface_firmware/PCA9685.cpp

/*
 * Sorter Interface Firmware - PCA9685 PWM Driver
 * Copyright (C) 2026 Jose I Romero
 *
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
 * THE SOFTWARE IS PROVIDED "AS IS", WITHOUT WARRANTY OF ANY KIND, EXPRESS OR
 * IMPLIED, INCLUDING BUT NOT LIMITED TO THE WARRANTIES OF MERCHANTABILITY,
 * FITNESS FOR A PARTICULAR PURPOSE AND NONINFRINGEMENT. IN NO EVENT SHALL THE
 * AUTHORS OR COPYRIGHT HOLDERS BE LIABLE FOR ANY CLAIM, DAMAGES OR OTHER
 * LIABILITY, WHETHER IN AN ACTION OF CONTRACT, TORT OR OTHERWISE, ARISING FROM,
 * OUT OF OR IN CONNECTION WITH THE SOFTWARE OR THE USE OR OTHER DEALINGS IN THE
 * SOFTWARE.
 */

#include "PCA9685.h"

#define PCA9685_OSC_FREQ 25000000
#define PCA9685_MAX_PWM 4095
#define PCA9685_PWM_FULL 4096
#define PCA9685_I2C_TIMEOUT_US 1000 // 1ms timeout for I2C operations

PCA9685::PCA9685(uint8_t i2c_addr, i2c_inst_t *i2c_port)
    : _i2c_addr(i2c_addr), _i2c_port(i2c_port), _osc_freq(25000000), _use_ext_clock(false) {
    _channel_duty.fill(0);
}

/** \brief Select the clock source (Internal 25MHz Oscillator vs External EXTCLK pin)
 *
 * Per NXP PCA9685 datasheet section 7.3.1:
 * To use an external clock signal, the EXTCLK bit must be set when the SLEEP bit is HIGH.
 *
 * \param external_clock true to use external EXTCLK pin (e.g. Y1 25MHz crystal/oscillator), false for internal.
 * \param clock_freq Frequency of the clock source in Hz (default: 25000000).
 * \return true on successful configuration, false on I2C error.
 */
bool PCA9685::setClockSource(bool external_clock, uint32_t clock_freq) {
    _osc_freq = clock_freq;
    _use_ext_clock = external_clock;

    // Step 1: Put PCA9685 into sleep mode
    uint8_t cmd_sleep[] = {PCA_REG_MODE1, PCA_MODE1_SLEEP};
    int res = i2c_write_timeout_us(_i2c_port, _i2c_addr, cmd_sleep, 2, false, PCA9685_I2C_TIMEOUT_US);
    if (res < 0) return false;

    sleep_us(500);

    if (external_clock) {
        // Step 2: Set EXTCLK bit AND SLEEP bit simultaneously (datasheet requirement: EXTCLK can only be set when SLEEP is 1)
        uint8_t cmd_extclk[] = {PCA_REG_MODE1, static_cast<uint8_t>(PCA_MODE1_SLEEP | PCA_MODE1_EXTCLK)};
        res = i2c_write_timeout_us(_i2c_port, _i2c_addr, cmd_extclk, 2, false, PCA9685_I2C_TIMEOUT_US);
        if (res < 0) return false;
    }

    // Step 3: Turn off SLEEP bit (keep EXTCLK bit if set, and enable Auto-Increment)
    uint8_t mode1_val = external_clock ? (PCA_MODE1_EXTCLK | PCA_MODE1_AI) : PCA_MODE1_AI;
    uint8_t cmd_wake[] = {PCA_REG_MODE1, mode1_val};
    res = i2c_write_timeout_us(_i2c_port, _i2c_addr, cmd_wake, 2, false, PCA9685_I2C_TIMEOUT_US);
    if (res < 0) return false;

    sleep_us(500); // Wait for clock signal to stabilize
    return true;
}

/** \brief Detect if the PCA9685 is present on the I2C bus and initialize it
 *
 * This function attempts to write to the MODE1 and MODE2 registers of the PCA9685 to configure it for normal operation.
 * If the device is present and responds to the I2C commands, it will be configured to respond to ALL CALL addresses and
 * use a totem pole structure for the outputs. If any of the I2C operations fail (e.g. due to no response from the
 * device), the function will return false, indicating that the device was not detected.
 *
 * \return true if the device is detected and initialized successfully, false otherwise
 */
bool PCA9685::initialize() {
    int res;
    // Put device to sleep to set prescaler
    uint8_t cmd_sleep[] = {PCA_REG_MODE1, PCA_MODE1_SLEEP};
    res = i2c_write_timeout_us(_i2c_port, _i2c_addr, cmd_sleep, 2, false,
                               PCA9685_I2C_TIMEOUT_US);
    if (res < 0)
        return false;
    // Set prescaler for 50Hz: 25MHz / (4096 * 50) - 1 = 121
    uint8_t prescale = 121;
    uint8_t cmd_prescale[] = {PCA_REG_PRE_SCALE, prescale};
    res = i2c_write_timeout_us(_i2c_port, _i2c_addr, cmd_prescale, 2, false,
                               PCA9685_I2C_TIMEOUT_US);
    if (res < 0)
        return false;
    // Wake up
    uint8_t cmd_wake[] = {PCA_REG_MODE1, 0x00};
    res = i2c_write_timeout_us(_i2c_port, _i2c_addr, cmd_wake, 2, false,
                               PCA9685_I2C_TIMEOUT_US);
    if (res < 0)
        return false;
    // Enable auto-increment
    uint8_t cmd_ai[] = {PCA_REG_MODE1, PCA_MODE1_AI};
    res = i2c_write_timeout_us(_i2c_port, _i2c_addr, cmd_ai, 2, false,
                               PCA9685_I2C_TIMEOUT_US);
    if (res < 0)
        return false;
    // Initialize all channels to 0 duty cycle (ON=0, OFF=0)
    uint8_t all_led_data[5] = {PCA_REG_ALL_LED_ON_L, 0, 0, 0, 0};
    res = i2c_write_timeout_us(_i2c_port, _i2c_addr, all_led_data, 5, false, PCA9685_I2C_TIMEOUT_US);
    if (res < 0)
        return false;
    _channel_duty.fill(0);
    return true;
}

/** \brief Set the PWM frequency for all channels
 *
 * The PCA9685 has a fixed internal oscillator frequency (25MHz) or external clock and a 12-bit resolution for the PWM duty cycle (4096
 * steps). The PWM frequency is determined by the prescaler value, which is calculated using the formula:
 *
 * \f$ prescale = round(\frac{OSC\_FREQ}{4096 \cdot freq}) - 1 \f$
 *
 * \param freq Desired PWM frequency in Hz. Minimum value is approximately 24Hz (prescale=255), maximum value is
 * approximately 1526Hz (prescale=3). Values outside this range will be clamped.
 */
void PCA9685::setPWMFreq(uint16_t freq) {
    // Calculate prescale value using the datasheet formula and fixed point math
    int prescaleval = 10 * _osc_freq / ((PCA9685_MAX_PWM + 1) * freq);
    prescaleval = ((prescaleval + 5) / 10); // Round to nearest integer
    prescaleval -= 1;                       // Subtract 1 from the result

    if (prescaleval < 3)
        prescaleval = 3; // Minimum prescale value is 3
    if (prescaleval > 255)
        prescaleval = 255; // Maximum prescale value is 255
    uint8_t prescale = (uint8_t)prescaleval;

    // Put the device to sleep to set the prescaler
    uint8_t oldmode;

    uint8_t cmd_mode1_reg[] = {PCA_REG_MODE1};
    int res = i2c_write_timeout_us(_i2c_port, _i2c_addr, cmd_mode1_reg, 1, true,
                                   PCA9685_I2C_TIMEOUT_US); // Write register address
    if (res < 0)
        return;
    res = i2c_read_timeout_us(_i2c_port, _i2c_addr, &oldmode, 1, false, PCA9685_I2C_TIMEOUT_US);
    if (res < 0)
        return;
    uint8_t newmode = (oldmode & 0x7F) | PCA_MODE1_SLEEP; // Sleep
    uint8_t cmd_newmode[] = {PCA_REG_MODE1, newmode};
    res = i2c_write_timeout_us(_i2c_port, _i2c_addr, cmd_newmode, 2, false,
                               PCA9685_I2C_TIMEOUT_US);
    if (res < 0)
        return;

    sleep_us(500); // Wait for the oscillator to stabilize after sleeping (datasheet recommends at least 500us)

    // Set the prescaler
    uint8_t cmd_freq_prescale[] = {PCA_REG_PRE_SCALE, prescale};
    res = i2c_write_timeout_us(_i2c_port, _i2c_addr, cmd_freq_prescale, 2, false,
                               PCA9685_I2C_TIMEOUT_US);
    if (res < 0)
        return;

    // Wake up the device
    uint8_t cmd_oldmode[] = {PCA_REG_MODE1, oldmode};
    res = i2c_write_timeout_us(_i2c_port, _i2c_addr, cmd_oldmode, 2, false,
                               PCA9685_I2C_TIMEOUT_US);

    sleep_us(500); // Wait for the oscillator to stabilize after waking up

    if (res < 0)
        return;
}

/** \brief Set the PWM duty cycle for a specific channel
 *
 * The PCA9685 uses a 12-bit value to represent the duty cycle, where 0 means always off and 4095 means always on. The
 * duty cycle is set by specifying the count at which the signal turns on and off within the 4096-count PWM period. In
 * this implementation, we always start the signal at count 0 (on_l=0, on_h=0) and set the off count based on the
 * desired duty cycle.
 *
 * \param channel PWM channel number (0-15)
 * \param duty Desired duty cycle (0-4095). Values outside this range will be clamped.
 */
void PCA9685::setPWM(uint8_t channel, uint16_t duty) {
    if (channel > 15)
        return; // Invalid channel
    
    // Check if the duty cycle has changed to minimize I2C writes
    if (_channel_duty[channel] == duty)
        return; // No change, skip I2C write
    
    // Compute the new on and off times
    uint16_t on_time = 0;
    uint16_t off_time = 0;

    if (duty == 0) {
        // Special case for fully off: set the ON count to 0 and OFF count to 4096 (full off)
        on_time = 0;
        off_time = PCA9685_PWM_FULL; // This will set the full off bit
    } else if (duty >= PCA9685_PWM_FULL) {
        // Special case for fully on: set the ON count to 4096 and OFF count to 0
        on_time = PCA9685_PWM_FULL; // This will set the full on bit
        off_time = 0;
    } else {
        // Normal case: ON count is 0, OFF count is equal to the duty cycle
        on_time = 0;
        off_time = duty;
    }

    const uint8_t on_l = on_time & 0xFF;
    const uint8_t on_h = (on_time >> 8) & 0x0F;
    const uint8_t off_l = off_time & 0xFF;
    const uint8_t off_h = (off_time >> 8) & 0x0F;

    uint8_t reg_base = PCA_REG_LED0_ON_L + (4 * channel);
    uint8_t cmd_pwm[] = {reg_base, on_l, on_h, off_l, off_h};
    int res = i2c_write_timeout_us(_i2c_port, _i2c_addr, cmd_pwm, 5, false,
                                   PCA9685_I2C_TIMEOUT_US);
    // If the write succeeds, update the shadow copy of the duty cycle. If it fails, we leave the shadow copy unchanged so that we will attempt to write again on the next call.
    if (res >= 0) {
        _channel_duty[channel] = duty;
    }
}
