jper1679/sorter-v2/software/firmware/sorter_interface_firmware/hwcfg_basically_v1_3.h

// Basically V1-3 — 5-stepper control board (with Y1 25MHz external oscillator on PCA9685 EXTCLK)
// LED/24V-en: GPIO1 (ch0), GPIO6 (ch1) — AO3400A NMOS
// Hall inputs: GPIO3, GPIO2

const char* const HW_ID = "basically_v1_3";

const uint8_t STEPPER_COUNT = 5;
const uint8_t STEPPER_STEP_PINS[] = {28, 26, 21, 19, 8};
const uint8_t STEPPER_DIR_PINS[]  = {27, 22, 20, 18, 7};

#ifdef FIRMWARE_ROLE_DISTRIBUTION
const char* const STEPPER_NAMES[] = {
    "chute_stepper",       // ch0 — STEP=GP28, DIR=GP27 — uart0 addr0
    "c_channel_1_rotor",   // ch1 — STEP=GP26, DIR=GP22 — uart0 addr1
    "c_channel_3_rotor",   // ch2 — STEP=GP21, DIR=GP20 — uart0 addr2
    "carousel",            // ch3 — STEP=GP19, DIR=GP18 — uart0 addr3
    "c_channel_2_rotor"    // ch4 — STEP=GP8,  DIR=GP7  — uart1 addr0
};
#else
const char* const STEPPER_NAMES[] = {
    "carousel",
    "third_c_channel_rotor",
    "second_c_channel_rotor",
    "first_c_channel_rotor",
    "fifth_stepper"
};
#endif

#define TMC_UART_BUS_COUNT 2
uart_inst_t* const TMC_UART_BUSES[] = {uart0, uart1};
const int TMC_UART_BUS_TX_PINS[] = {16, 4};
const int TMC_UART_BUS_RX_PINS[] = {17, 5};
const int TMC_UART_BAUDRATE = 400000;

const uint8_t TMC_UART_BUS_INDEX[]  = {0, 0, 0, 0, 1};
const uint8_t TMC_UART_ADDRESSES[]  = {0, 1, 2, 3, 0};

const int STEPPER_nEN_PINS[] = {0, 0, 0, 0, 0};
const int STEPPER_DIAG_PINS[] = {12, 13, 14, 15, 9};

const uint8_t DIGITAL_INPUT_COUNT = 2;
const int digital_input_pins[] = {3, 2};

const uint8_t DIGITAL_OUTPUT_COUNT = 2;
const int digital_output_pins[] = {1, 6};
const int FAN0_OUTPUT_CHANNEL = -1;
const uint8_t LED_OUTPUT_COUNT = 2;

i2c_inst_t* const I2C_PORT = i2c1;
const int I2C_SDA_PIN = 10;
const int I2C_SCL_PIN = 11;

const uint8_t SERVO_I2C_ADDRESS = 0x40;
