jper1679/sorter-v2/software/sorter/backend/tests/test_servo_bus_fatal.py

"""Fail-fast behavior when the Waveshare servo bus is unreachable.

The backend used to log a one-line warning and keep running when the
Waveshare bus failed to open — every piece silently fell into the
discard bucket. These tests verify the new fail-fast path:

1. Positioning notices that every configured layer servo is offline,
   pauses the controller via the command queue, sets a red banner, and
   records the fault on ``runtime_stats``.
2. A single-layer servo failure (the other layer's servo is healthy)
   does **not** trip the fatal banner.
3. Once any servo reports healthy again, the banner auto-clears so a
   Resume after reconnecting the bus recovers without a full restart.
"""

from __future__ import annotations

import queue
import unittest
from types import SimpleNamespace
from unittest.mock import MagicMock, patch

from defs.events import PauseCommandEvent
from defs.known_object import KnownObject
from irl.bin_layout import Bin, BinSection, BinSize, DistributionLayout, Layer
from runtime_stats import RuntimeStatsCollector
from server import shared_state
from sorting_profile import MISC_CATEGORY, SortingProfile
from subsystems.distribution.chute import Chute
from subsystems.distribution.positioning import (
    DISTRIBUTION_NO_BIN_AVAILABLE_INCIDENT_KIND,
    DOORS_STOP_WAIT_S,
    Positioning,
    SERVO_BUS_OFFLINE_TITLE,
)
from subsystems.distribution.states import DistributionState
from subsystems.shared_variables import SharedVariables


class _Logger:
    def __init__(self) -> None:
        self.messages: list[tuple[str, str]] = []

    def info(self, msg: str, *args, **kwargs) -> None:
        self.messages.append(("info", str(msg)))

    def warning(self, msg: str, *args, **kwargs) -> None:
        self.messages.append(("warning", str(msg)))

    def warn(self, msg: str, *args, **kwargs) -> None:
        self.messages.append(("warn", str(msg)))

    def error(self, msg: str, *args, **kwargs) -> None:
        self.messages.append(("error", str(msg)))


class _AllCategoriesProfile(SortingProfile):
    def __init__(self, category_id: str = "cat_a") -> None:
        self._category_id = category_id

    def getCategoryIdForPart(self, part_id: str, color_id: str = "any_color") -> str:
        return self._category_id


def _mk_offline_servo() -> SimpleNamespace:
    servo = SimpleNamespace(available=False, stopped=True)
    servo.isClosed = lambda: False
    servo.isOpen = lambda: False
    servo.open = MagicMock(side_effect=RuntimeError("bus offline"))
    servo.close = MagicMock(side_effect=RuntimeError("bus offline"))
    return servo


def _mk_healthy_servo() -> SimpleNamespace:
    servo = SimpleNamespace(available=True, stopped=True)
    servo.isClosed = lambda: True
    servo.isOpen = lambda: False
    servo.open = MagicMock()
    servo.close = MagicMock()
    return servo


def _mk_layout(num_layers: int = 2) -> DistributionLayout:
    layers: list[Layer] = []
    for _ in range(num_layers):
        section = BinSection(bins=[Bin(size=BinSize.MEDIUM, category_ids=["cat_a"])])
        layer = Layer(sections=[section])
        layer.enabled = True
        layer.max_pieces_per_bin = None
        layers.append(layer)
    return DistributionLayout(layers=layers)


def _mk_piece() -> KnownObject:
    return KnownObject(part_id="3001", color_id="5")


class ServoBusFatalTests(unittest.TestCase):
    def setUp(self) -> None:
        # Distribution incidents default to Off; these tests exercise the
        # Manual path unless they patch it themselves.
        handling_off = patch(
            "subsystems.distribution.positioning._incidentHandlingOff", return_value=False
        )
        handling_off.start()
        self.addCleanup(handling_off.stop)
        self._saved_error = shared_state.hardware_error
        self._saved_state = shared_state.hardware_state
        self._saved_queue = shared_state.command_queue
        shared_state.hardware_error = None
        shared_state.hardware_state = "standby"
        shared_state.distribution_no_bin_passthrough_approvals.clear()
        self.cmd_queue: queue.Queue = queue.Queue()
        shared_state.command_queue = self.cmd_queue

        self.runtime_stats = RuntimeStatsCollector()
        self.logger = _Logger()
        self.gc = SimpleNamespace(
            logger=self.logger,
            disable_servos=False,
            runtime_stats=self.runtime_stats,
            run_recorder=SimpleNamespace(markPaused=lambda: None, markRunning=lambda: None),
        )

    def tearDown(self) -> None:
        shared_state.hardware_error = self._saved_error
        shared_state.hardware_state = self._saved_state
        shared_state.command_queue = self._saved_queue

    def _mk_positioning(
        self,
        servos: list[SimpleNamespace],
        *,
        layout: DistributionLayout | None = None,
        sorting_profile: SortingProfile | None = None,
        piece: KnownObject | None = None,
    ) -> Positioning:
        layout = layout or _mk_layout(num_layers=len(servos))
        irl = SimpleNamespace(servos=servos)
        piece = piece or _mk_piece()
        transport = SimpleNamespace(
            getPieceForDistributionPositioning=lambda: piece,
        )
        shared = SharedVariables(gc=self.gc, bus=None)
        shared.transport = transport
        chute = MagicMock(spec=Chute)
        chute.isBinReachable = MagicMock(return_value=True)
        chute.moveToBin = MagicMock(return_value=250)
        chute.stepper = SimpleNamespace(stopped=True)
        chute.checking = False
        chute.positionCheckDue = MagicMock(return_value=False)
        positioning = Positioning(
            irl=irl,
            gc=self.gc,
            shared=shared,
            chute=chute,
            layout=layout,
            sorting_profile=sorting_profile or _AllCategoriesProfile(),
            event_queue=queue.Queue(),
        )
        return positioning

    def test_all_layers_offline_raises_fatal_and_pauses(self) -> None:
        positioning = self._mk_positioning(
            servos=[_mk_offline_servo(), _mk_offline_servo()]
        )
        positioning.step()

        # Fatal banner set.
        self.assertIsNotNone(shared_state.hardware_error)
        assert shared_state.hardware_error is not None
        self.assertEqual(SERVO_BUS_OFFLINE_TITLE, shared_state.hardware_error["title"])

        # A pause command was enqueued for the main-thread handler.
        self.assertFalse(self.cmd_queue.empty())
        event = self.cmd_queue.get_nowait()
        self.assertIsInstance(event, PauseCommandEvent)

        # Runtime stats recorded the fault timestamp for the UI.
        self.assertIsNotNone(self.runtime_stats.servo_bus_offline_since_ts)
        snap = self.runtime_stats.snapshot()
        self.assertIsNotNone(snap.get("servo_bus_offline_since_ts"))
        self.assertIsNotNone(snap.get("active_incident"))
        self.assertEqual(
            "distribution_servo_bus_offline",
            snap["active_incident"]["kind"],
        )

    def test_single_offline_layer_does_not_trip_fatal(self) -> None:
        # Layer 0 is offline but layer 1's servo is healthy — Positioning
        # must keep running on the remaining layer, NOT raise the fatal
        # bus-offline banner.
        positioning = self._mk_positioning(
            servos=[_mk_offline_servo(), _mk_healthy_servo()]
        )
        positioning.step()

        self.assertIsNone(shared_state.hardware_error)
        self.assertTrue(self.cmd_queue.empty())
        self.assertIsNone(self.runtime_stats.servo_bus_offline_since_ts)

    def test_a_refused_chute_move_is_resent_and_never_reaches_ready(self) -> None:
        positioning = self._mk_positioning(servos=[_mk_healthy_servo()])
        positioning.chute.moveToBin = MagicMock(side_effect=[None, 250])
        positioning.chute.stepper = SimpleNamespace(stopped=False)

        self.assertIsNone(positioning.step())  # the board refuses: the chute is busy
        self.assertIsNone(positioning.step())  # still moving: wait, send nothing
        self.assertEqual(1, positioning.chute.moveToBin.call_count)

        positioning.chute.stepper.stopped = True
        self.assertIsNone(positioning.step())  # stopped: sent again and accepted
        self.assertEqual(2, positioning.chute.moveToBin.call_count)
        self.assertEqual(DistributionState.READY, positioning.step())

    def test_the_doors_for_a_piece_are_set_only_once_every_door_has_stopped(self) -> None:
        moving = _mk_healthy_servo()
        moving.stopped = False
        servos = [_mk_healthy_servo(), moving]
        positioning = self._mk_positioning(servos=servos)
        commands = lambda servo: servo.open.call_count + servo.close.call_count

        self.assertIsNone(positioning.step())  # layer 1's door is still moving
        self.assertIsNone(positioning.step())
        self.assertEqual([0, 0], [commands(servo) for servo in servos])
        positioning.chute.moveToBin.assert_not_called()

        moving.stopped = True
        self.assertIsNone(positioning.step())  # doors set, chute sent
        self.assertEqual([1, 1], [commands(servo) for servo in servos])
        positioning.chute.moveToBin.assert_called_once()

    def test_a_door_that_never_stops_is_set_anyway_after_the_wait(self) -> None:
        moving = _mk_healthy_servo()
        moving.stopped = False
        positioning = self._mk_positioning(servos=[_mk_healthy_servo(), moving])

        self.assertIsNone(positioning.step())
        positioning._doors_wait_since -= DOORS_STOP_WAIT_S
        positioning.step()
        positioning.chute.moveToBin.assert_called_once()

    def test_a_refused_door_close_marks_the_layer_unavailable(self) -> None:
        servo = _mk_healthy_servo()
        servo.close = MagicMock(return_value=False)
        positioning = self._mk_positioning(servos=[servo])

        self.assertEqual(DistributionState.IDLE, positioning.step())
        positioning.chute.moveToBin.assert_not_called()
        self.assertIn(0, positioning._blocked_layers)

    def test_no_bin_available_publishes_distribution_incident_before_passthrough(self) -> None:
        positioning = self._mk_positioning(
            servos=[_mk_healthy_servo()],
            sorting_profile=_AllCategoriesProfile("cat_missing"),
        )

        next_state = positioning.step()

        self.assertEqual(DistributionState.IDLE, next_state)
        snap = self.runtime_stats.snapshot()
        self.assertIsNotNone(snap.get("active_incident"))
        self.assertEqual(
            DISTRIBUTION_NO_BIN_AVAILABLE_INCIDENT_KIND,
            snap["active_incident"]["kind"],
        )
        self.assertEqual("cat_missing", snap["active_incident"]["category_id"])
        self.assertEqual("positioning.no_bin_incident", positioning._occupancy_state)

    def test_no_bin_clear_approval_allows_one_shot_passthrough(self) -> None:
        piece = _mk_piece()
        positioning = self._mk_positioning(
            servos=[_mk_healthy_servo()],
            sorting_profile=_AllCategoriesProfile("cat_missing"),
            piece=piece,
        )
        shared_state.approveDistributionNoBinPassthrough(piece.uuid)

        next_state = positioning.step()

        self.assertEqual(DistributionState.READY, next_state)
        self.assertIsNone(self.runtime_stats.snapshot().get("active_incident"))
        self.assertEqual("positioning.passthrough_no_bin", positioning._occupancy_state)
        self.assertEqual(set(), shared_state.distribution_no_bin_passthrough_approvals)

    def test_misc_without_assigned_bin_passes_through_without_incident(self) -> None:
        servo = _mk_healthy_servo()
        positioning = self._mk_positioning(
            servos=[servo],
            sorting_profile=_AllCategoriesProfile(MISC_CATEGORY),
        )

        next_state = positioning.step()

        self.assertEqual(DistributionState.READY, next_state)
        self.assertIsNone(self.runtime_stats.snapshot().get("active_incident"))
        self.assertEqual("positioning.passthrough_no_bin", positioning._occupancy_state)
        servo.open.assert_called_once()

    def test_misc_assigned_bin_is_ignored_for_bottom_passthrough(self) -> None:
        servo = _mk_healthy_servo()
        section = BinSection(bins=[Bin(size=BinSize.MEDIUM, category_ids=[MISC_CATEGORY])])
        layer = Layer(sections=[section])
        layer.enabled = True
        layout = DistributionLayout(layers=[layer])
        positioning = self._mk_positioning(
            servos=[servo],
            layout=layout,
            sorting_profile=_AllCategoriesProfile(MISC_CATEGORY),
        )

        next_state = positioning.step()

        self.assertEqual(DistributionState.READY, next_state)
        self.assertIsNone(self.runtime_stats.snapshot().get("active_incident"))
        self.assertIsNone(positioning._piece.destination_bin)
        self.assertEqual("positioning.passthrough_no_bin", positioning._occupancy_state)
        positioning.chute.moveToBin.assert_not_called()
        servo.open.assert_called_once()

    def test_repeat_detection_does_not_spam_error_or_queue(self) -> None:
        # Re-entering Positioning while the bus is still offline must not
        # enqueue a second pause or re-log the banner on every tick.
        positioning = self._mk_positioning(
            servos=[_mk_offline_servo(), _mk_offline_servo()]
        )
        positioning.step()
        first_stamp = self.runtime_stats.servo_bus_offline_since_ts

        positioning._phase = "init"
        positioning.step()
        positioning._phase = "init"
        positioning.step()

        drained: list = []
        while not self.cmd_queue.empty():
            drained.append(self.cmd_queue.get_nowait())
        self.assertEqual(1, len(drained))
        # Timestamp must not be reset on each observation.
        self.assertEqual(first_stamp, self.runtime_stats.servo_bus_offline_since_ts)

    def test_banner_clears_when_servo_comes_back_online(self) -> None:
        # Simulate mid-run failure: first step finds every layer offline →
        # banner + pause. Then the bus recovers (both servos flip back
        # to available=True) and a follow-up step is allowed to proceed,
        # which clears the banner.
        servos = [_mk_offline_servo(), _mk_offline_servo()]
        positioning = self._mk_positioning(servos=servos)
        positioning.step()
        self.assertEqual(
            SERVO_BUS_OFFLINE_TITLE, (shared_state.hardware_error or {}).get("title")
        )

        # Bus recovered: flip the servos back to healthy.
        for servo in servos:
            servo.available = True
            servo.isClosed = lambda: True
            servo.open = MagicMock()
            servo.close = MagicMock()

        positioning._phase = "init"
        positioning.step()

        self.assertIsNone(shared_state.hardware_error)
        self.assertIsNone(self.runtime_stats.servo_bus_offline_since_ts)
        self.assertIsNone(self.runtime_stats.snapshot().get("active_incident"))


class MainBootServoHealthCheckTests(unittest.TestCase):
    """Boot-time: main.py's ``_checkServoBusHealth`` flips the red banner
    if every configured servo comes back with ``available=False`` after
    the ``servo.open()`` pass. A successful boot (at least one healthy
    servo) must NOT set any error.
    """

    def setUp(self) -> None:
        self._saved_error = shared_state.hardware_error
        shared_state.hardware_error = None
        self.runtime_stats = RuntimeStatsCollector()
        self.logger = _Logger()
        self.gc = SimpleNamespace(
            logger=self.logger,
            runtime_stats=self.runtime_stats,
        )

    def tearDown(self) -> None:
        shared_state.hardware_error = self._saved_error

    def _run_check(self, servos: list[SimpleNamespace]) -> None:
        from main import _checkServoBusHealth

        irl = SimpleNamespace(servos=servos)
        _checkServoBusHealth(self.gc, irl)

    def test_boot_with_all_offline_sets_fatal_banner(self) -> None:
        self._run_check([_mk_offline_servo(), _mk_offline_servo()])
        self.assertIsNotNone(shared_state.hardware_error)
        assert shared_state.hardware_error is not None
        self.assertEqual(SERVO_BUS_OFFLINE_TITLE, shared_state.hardware_error["title"])
        self.assertIsNotNone(self.runtime_stats.servo_bus_offline_since_ts)

    def test_boot_with_at_least_one_online_leaves_error_clear(self) -> None:
        self._run_check([_mk_offline_servo(), _mk_healthy_servo()])
        self.assertIsNone(shared_state.hardware_error)
        self.assertIsNone(self.runtime_stats.servo_bus_offline_since_ts)

    def test_boot_with_no_servos_configured_is_a_noop(self) -> None:
        self._run_check([])
        self.assertIsNone(shared_state.hardware_error)


if __name__ == "__main__":
    unittest.main()
