jper1679/sorter-v2/software/sorter/backend/tests/test_hive_models.py

"""Tests for ``server.hive_models``.

These tests never hit the network — ``HiveClient.get_model`` and
``HiveClient.download_model_variant`` are stubbed via monkeypatch.
"""

from __future__ import annotations

import io
import json
import os
import sys
import tarfile
import threading
import time
from pathlib import Path
from typing import Any, Callable
from unittest.mock import Mock, call

import pytest

from server import hive_models


HiveError = hive_models.HiveError


# ---------------------------------------------------------------------------
# Runtime selection
# ---------------------------------------------------------------------------


@pytest.fixture(autouse=True)
def hardwareWithoutAccelerators(monkeypatch: pytest.MonkeyPatch) -> None:
    monkeypatch.setattr(hive_models, "_HAS_HAILO_CACHE", False)
    monkeypatch.setattr(hive_models, "_HAS_RKNN_NPU_CACHE", False)


class TestPickRuntime:
    @pytest.mark.parametrize("runtimes", [[], ["pytorch"], ["unknown"]])
    def test_no_deployable_runtime_skips_hardware_probe(
        self, monkeypatch: pytest.MonkeyPatch, runtimes: list[str]
    ) -> None:
        probe = Mock(side_effect=AssertionError("should not probe hardware"))
        monkeypatch.setattr(hive_models, "compatible_runtimes_for_this_machine", probe)
        assert hive_models.pick_runtime_for_this_machine(runtimes) is None
        probe.assert_not_called()

    def test_prefers_hailo_when_available(self, monkeypatch: pytest.MonkeyPatch) -> None:
        monkeypatch.setattr(hive_models, "_has_hailo", lambda: True)
        assert (
            hive_models.pick_runtime_for_this_machine(["onnx", "hailo", "ncnn"])
            == "hailo"
        )

    def test_ncnn_on_aarch64(self, monkeypatch: pytest.MonkeyPatch) -> None:
        monkeypatch.setattr(hive_models, "_has_hailo", lambda: False)
        monkeypatch.setattr(hive_models.platform, "machine", lambda: "aarch64")
        assert (
            hive_models.pick_runtime_for_this_machine(["onnx", "ncnn", "pytorch"])
            == "ncnn"
        )

    def test_onnx_on_x86_64(self, monkeypatch: pytest.MonkeyPatch) -> None:
        monkeypatch.setattr(hive_models, "_has_hailo", lambda: False)
        monkeypatch.setattr(hive_models.platform, "machine", lambda: "x86_64")
        assert (
            hive_models.pick_runtime_for_this_machine(["onnx", "ncnn", "pytorch"])
            == "onnx"
        )

    @pytest.mark.parametrize("runtimes", [["pytorch"], ["unknown"], ["hailo"], ["rknn"], ["pytorch", "unknown", "hailo", "rknn"]])
    def test_unsupported_runtimes_return_none(
        self, monkeypatch: pytest.MonkeyPatch, runtimes: list[str]
    ) -> None:
        monkeypatch.setattr(hive_models, "compatible_runtimes_for_this_machine", lambda: ["onnx", "ncnn"])
        assert hive_models.pick_runtime_for_this_machine(runtimes) is None

    def test_automatic_variant_selection_rejects_unsupported_runtime(
        self, monkeypatch: pytest.MonkeyPatch
    ) -> None:
        monkeypatch.setattr(hive_models, "compatible_runtimes_for_this_machine", lambda: ["onnx", "ncnn"])
        detail = {"variants": [{"runtime": "pytorch"}, {"runtime": "hailo"}]}
        assert hive_models._pick_variant(detail, None) is None

    def test_hailo_not_selected_when_hardware_missing(
        self, monkeypatch: pytest.MonkeyPatch
    ) -> None:
        monkeypatch.setattr(hive_models, "_has_tensorrt", lambda: False)
        monkeypatch.setattr(hive_models, "_has_hailo", lambda: False)
        monkeypatch.setattr(hive_models.platform, "machine", lambda: "x86_64")
        # Hailo is offered but hardware isn't present — we should pick onnx.
        assert (
            hive_models.pick_runtime_for_this_machine(["hailo", "onnx"]) == "onnx"
        )

    def test_rknn_on_an_rk3588(self, monkeypatch: pytest.MonkeyPatch) -> None:
        monkeypatch.setattr(hive_models, "_has_tensorrt", lambda: False)
        monkeypatch.setattr(hive_models, "_has_hailo", lambda: False)
        monkeypatch.setattr(hive_models, "_has_rknn_npu", lambda: True)
        monkeypatch.setattr(hive_models.platform, "machine", lambda: "aarch64")
        assert hive_models.compatible_runtimes_for_this_machine() == ["rknn", "ncnn", "onnx"]
        assert (
            hive_models.pick_runtime_for_this_machine(["onnx", "ncnn", "rknn"]) == "rknn"
        )

    def test_tensorrt_on_a_jetson(self, monkeypatch: pytest.MonkeyPatch) -> None:
        monkeypatch.setattr(hive_models, "_has_tensorrt", lambda: True)
        monkeypatch.setattr(hive_models, "_has_hailo", lambda: False)
        monkeypatch.setattr(hive_models, "_has_rknn_npu", lambda: False)
        monkeypatch.setattr(hive_models.platform, "machine", lambda: "aarch64")
        assert hive_models.compatible_runtimes_for_this_machine() == ["tensorrt", "ncnn", "onnx"]
        assert (
            hive_models.pick_runtime_for_this_machine(["onnx", "ncnn", "tensorrt"]) == "tensorrt"
        )

    def test_compatible_runtimes_without_accelerators(
        self, monkeypatch: pytest.MonkeyPatch
    ) -> None:
        monkeypatch.setattr(hive_models, "_has_tensorrt", lambda: False)
        monkeypatch.setattr(hive_models, "_has_hailo", lambda: False)
        monkeypatch.setattr(hive_models, "_has_rknn_npu", lambda: False)
        monkeypatch.setattr(hive_models.platform, "machine", lambda: "x86_64")
        assert hive_models.compatible_runtimes_for_this_machine() == ["onnx", "ncnn"]
        monkeypatch.setattr(hive_models.platform, "machine", lambda: "aarch64")
        assert hive_models.compatible_runtimes_for_this_machine() == ["ncnn", "onnx"]


@pytest.mark.parametrize(
    "probe_name,cache_name,first_path,fallback_path",
    [
        ("_has_hailo", "_HAS_HAILO_CACHE", "/dev/hailo0", "/sys/class/misc/hailo0"),
        ("_has_rknn_npu", "_HAS_RKNN_NPU_CACHE", "/sys/kernel/debug/rknpu/version", "/usr/lib/librknnrt.so"),
    ],
)
@pytest.mark.parametrize("fallback_present", [False, True, OSError("unreadable")])
def test_runtime_probe_checks_fallback_after_permission_error(
    monkeypatch: pytest.MonkeyPatch,
    probe_name: str,
    cache_name: str,
    first_path: str,
    fallback_path: str,
    fallback_present: bool | OSError,
) -> None:
    first = Mock()
    first.exists.side_effect = PermissionError("access denied")
    fallback = Mock()
    if isinstance(fallback_present, OSError):
        fallback.exists.side_effect = fallback_present
    else:
        fallback.exists.return_value = fallback_present
    paths = Mock(side_effect=[first, fallback])
    monkeypatch.setattr(hive_models, "Path", paths)
    monkeypatch.setattr(hive_models, cache_name, None)
    probe = getattr(hive_models, probe_name)
    expected = fallback_present is True
    assert probe() is expected
    assert probe() is expected
    assert paths.call_args_list == [call(first_path), call(fallback_path)]


# ---------------------------------------------------------------------------
# DownloadJobManager
# ---------------------------------------------------------------------------


def _configure_target(monkeypatch: pytest.MonkeyPatch) -> None:
    monkeypatch.setattr(
        hive_models,
        "resolve_targets",
        lambda: [
            {
                "id": "hive-a",
                "name": "Hive A",
                "url": "https://hive.example",
                "api_token": "token-xyz",
                "machine_id": None,
            }
        ],
    )


class _StubClient:
    """Stand-in for ``HiveClient`` recording the last call."""

    def __init__(
        self,
        *,
        detail: dict,
        downloader: Callable[..., str] | None = None,
    ) -> None:
        self._detail = detail
        self._downloader = downloader or (lambda *a, **kw: "deadbeef")
        self.downloaded: list[tuple[str, str, Path]] = []

    def get_model(self, model_id: str) -> dict:
        return self._detail

    def list_models(self, **_: Any) -> dict:
        return {"items": [], "total": 0, "page": 1, "page_size": 30, "pages": 0}

    def download_model_variant(
        self,
        model_id: str,
        variant_id: str,
        dest_path: Path,
        on_progress: Callable[[int, int], None] | None = None,
        expected_sha256: str | None = None,
    ) -> str:
        self.downloaded.append((model_id, variant_id, Path(dest_path)))
        return self._downloader(
            model_id, variant_id, Path(dest_path), on_progress, expected_sha256
        )


def _install_stub_client(
    monkeypatch: pytest.MonkeyPatch, stub: _StubClient
) -> None:
    def _factory(target_id: str) -> tuple[_StubClient, dict]:
        return stub, {
            "id": target_id,
            "name": "Hive",
            "url": "https://hive.example",
            "api_token": "token",
        }

    monkeypatch.setattr(hive_models, "_get_client_for_target", _factory)


def _make_detail(model_id: str = "model-1") -> dict:
    return {
        "id": model_id,
        "name": "Test Detector",
        "model_family": "yolo",
        "training_metadata": {"imgsz": 320, "epochs": 200},
        "variants": [
            {
                "id": "variant-onnx",
                "runtime": "onnx",
                "file_name": "detector.onnx",
                "file_size": 1234,
                "sha256": "expected-sha",
                "format_meta": {},
                "uploaded_at": "2026-04-01T00:00:00Z",
            }
        ],
    }


class TestDownloadJobManager:
    def test_happy_path_writes_file_and_run_json(
        self, tmp_path: Path, monkeypatch: pytest.MonkeyPatch
    ) -> None:
        monkeypatch.setattr(hive_models, "LOCAL_MODELS_DIR", tmp_path)
        _configure_target(monkeypatch)

        detail = _make_detail()
        payload = b"fake-onnx-bytes"

        def _downloader(
            model_id: str,
            variant_id: str,
            dest_path: Path,
            on_progress: Callable[[int, int], None] | None,
            expected_sha256: str | None,
        ) -> str:
            dest_path.parent.mkdir(parents=True, exist_ok=True)
            dest_path.write_bytes(payload)
            if on_progress is not None:
                on_progress(len(payload), len(payload))
            assert expected_sha256 == "expected-sha"
            return "expected-sha"

        stub = _StubClient(detail=detail, downloader=_downloader)
        _install_stub_client(monkeypatch, stub)

        manager = hive_models.DownloadJobManager()
        job_id = manager.enqueue("hive-a", "model-1")

        final = manager.wait_for_terminal(job_id, timeout=5.0)
        assert final.get("status") == "done", final
        assert final.get("error") is None
        assert final.get("progress_bytes") == len(payload)

        dest_file = tmp_path / "hive-model-1-onnx" / "exports" / "detector.onnx"
        assert dest_file.exists()
        assert dest_file.read_bytes() == payload

        run_json_path = tmp_path / "hive-model-1-onnx" / "run.json"
        assert run_json_path.exists()
        run_json = json.loads(run_json_path.read_text())
        assert hive_models.HIVE_SENTINEL_KEY in run_json
        sentinel = run_json[hive_models.HIVE_SENTINEL_KEY]
        assert sentinel["target_id"] == "hive-a"
        assert sentinel["model_id"] == "model-1"
        assert sentinel["variant_runtime"] == "onnx"
        assert sentinel["sha256"] == "expected-sha"
        # Training metadata + name/family carry over for installed-model UI.
        assert run_json.get("name") == "Test Detector"
        assert run_json.get("model_family") == "yolo"
        assert run_json.get("imgsz") == 320

        # And it should show up under list_installed_models().
        installed = hive_models.list_installed_models()
        assert len(installed) == 1
        assert installed[0]["local_id"] == "hive-model-1-onnx"
        assert installed[0]["target_id"] == "hive-a"

    def test_sha_mismatch_is_captured_as_failure(
        self, tmp_path: Path, monkeypatch: pytest.MonkeyPatch
    ) -> None:
        monkeypatch.setattr(hive_models, "LOCAL_MODELS_DIR", tmp_path)
        _configure_target(monkeypatch)

        def _downloader(*_args: Any, **_kwargs: Any) -> str:
            raise HiveError(500, "SHA256 mismatch on download", "SHA256_MISMATCH")

        stub = _StubClient(detail=_make_detail(), downloader=_downloader)
        _install_stub_client(monkeypatch, stub)

        manager = hive_models.DownloadJobManager()
        job_id = manager.enqueue("hive-a", "model-1")

        final = manager.wait_for_terminal(job_id, timeout=5.0)
        assert final.get("status") == "failed"
        assert "SHA256 mismatch" in (final.get("error") or "")

        # No run.json should have been written on mismatch.
        assert not (tmp_path / "hive-model-1-onnx" / "run.json").exists()

    def test_ncnn_tarball_is_extracted_in_place(
        self, tmp_path: Path, monkeypatch: pytest.MonkeyPatch
    ) -> None:
        monkeypatch.setattr(hive_models, "LOCAL_MODELS_DIR", tmp_path)
        _configure_target(monkeypatch)

        detail = _make_detail()
        detail["variants"] = [
            {
                "id": "variant-ncnn",
                "runtime": "ncnn",
                "file_name": "detector.tar.gz",
                "file_size": 1234,
                "sha256": "expected-sha",
                "format_meta": {},
                "uploaded_at": "2026-04-01T00:00:00Z",
            }
        ]

        def _downloader(
            model_id: str,
            variant_id: str,
            dest_path: Path,
            on_progress: Callable[[int, int], None] | None,
            expected_sha256: str | None,
        ) -> str:
            dest_path.parent.mkdir(parents=True, exist_ok=True)
            with tarfile.open(dest_path, "w:gz") as tar:
                payload = b"fake-ncnn-model"
                model_info = tarfile.TarInfo("best_ncnn_model/model.bin")
                model_info.size = len(payload)
                tar.addfile(model_info, io.BytesIO(payload))
            if on_progress is not None:
                size = dest_path.stat().st_size
                on_progress(size, size)
            assert expected_sha256 == "expected-sha"
            return "expected-sha"

        stub = _StubClient(detail=detail, downloader=_downloader)
        _install_stub_client(monkeypatch, stub)

        manager = hive_models.DownloadJobManager()
        job_id = manager.enqueue("hive-a", "model-1")

        final = manager.wait_for_terminal(job_id, timeout=5.0)
        assert final.get("status") == "done", final
        assert (tmp_path / "hive-model-1-ncnn" / "exports" / "best_ncnn_model" / "model.bin").exists()

    def test_piece_link_model_installs_inert(
        self, tmp_path: Path, monkeypatch: pytest.MonkeyPatch
    ) -> None:
        """A piece_link model is an encoder+head pair shipped as one onnx-runtime
        tarball. It must install like any other model but report itself inert, so
        the UI greys it out instead of offering an Activate that does nothing."""
        monkeypatch.setattr(hive_models, "LOCAL_MODELS_DIR", tmp_path)
        _configure_target(monkeypatch)

        detail = _make_detail()
        detail["purpose"] = "piece_link"
        detail["model_family"] = "piece_link_matcher"
        detail["training_metadata"] = {"input_size": 96, "embed_dim": 64, "meta_dim": 11}
        detail["variants"] = [
            {
                "id": "variant-onnx",
                "runtime": "onnx",
                "file_name": "link-v3.tar.gz",
                "file_size": 1234,
                "sha256": "expected-sha",
                "format_meta": {"archive": "tar.gz", "members": ["encoder.onnx", "head.onnx"]},
                "uploaded_at": "2026-04-01T00:00:00Z",
            }
        ]

        def _downloader(
            model_id: str,
            variant_id: str,
            dest_path: Path,
            on_progress: Callable[[int, int], None] | None,
            expected_sha256: str | None,
        ) -> str:
            dest_path.parent.mkdir(parents=True, exist_ok=True)
            with tarfile.open(dest_path, "w:gz") as tar:
                for member in ("encoder.onnx", "head.onnx"):
                    payload = f"fake-{member}".encode()
                    info = tarfile.TarInfo(member)
                    info.size = len(payload)
                    tar.addfile(info, io.BytesIO(payload))
            if on_progress is not None:
                size = dest_path.stat().st_size
                on_progress(size, size)
            return "expected-sha"

        stub = _StubClient(detail=detail, downloader=_downloader)
        _install_stub_client(monkeypatch, stub)

        manager = hive_models.DownloadJobManager()
        final = manager.wait_for_terminal(manager.enqueue("hive-a", "model-1"), timeout=5.0)
        assert final.get("status") == "done", final

        exports = tmp_path / "hive-model-1-onnx" / "exports"
        # Extraction is gated on the file being a tarball, not on runtime == ncnn.
        assert (exports / "encoder.onnx").exists()
        assert (exports / "head.onnx").exists()

        run_json = json.loads((tmp_path / "hive-model-1-onnx" / "run.json").read_text())
        assert run_json[hive_models.HIVE_SENTINEL_KEY]["purpose"] == "piece_link"

        installed = hive_models.list_installed_models()
        assert len(installed) == 1
        assert installed[0]["purpose"] == "piece_link"
        assert installed[0]["inert"] is True
        # Nothing consumes it, so it must not present as activatable.
        assert installed[0]["compatible"] is False

    def test_purpose_defaults_to_detection_for_models_installed_before_the_field(
        self, tmp_path: Path, monkeypatch: pytest.MonkeyPatch
    ) -> None:
        monkeypatch.setattr(hive_models, "LOCAL_MODELS_DIR", tmp_path)
        entry = tmp_path / "hive-legacy-onnx"
        entry.mkdir()
        (entry / "run.json").write_text(
            json.dumps(
                {
                    "name": "Legacy",
                    "model_family": "yolo",
                    hive_models.HIVE_SENTINEL_KEY: {
                        "target_id": "hive-a",
                        "model_id": "legacy",
                        "variant_runtime": "onnx",
                        "sha256": "abc",
                    },
                }
            )
        )
        installed = hive_models.list_installed_models()
        assert installed[0]["purpose"] == "detection"
        assert installed[0]["inert"] is False
        assert installed[0]["compatible"] is True

    def test_ncnn_tarball_rejects_path_traversal(
        self, tmp_path: Path, monkeypatch: pytest.MonkeyPatch
    ) -> None:
        monkeypatch.setattr(hive_models, "LOCAL_MODELS_DIR", tmp_path)
        _configure_target(monkeypatch)

        detail = _make_detail()
        detail["variants"] = [
            {
                "id": "variant-ncnn",
                "runtime": "ncnn",
                "file_name": "detector.tar.gz",
                "file_size": 1234,
                "sha256": "expected-sha",
                "format_meta": {},
                "uploaded_at": "2026-04-01T00:00:00Z",
            }
        ]

        outside_target = tmp_path / "outside.txt"

        def _downloader(
            model_id: str,
            variant_id: str,
            dest_path: Path,
            on_progress: Callable[[int, int], None] | None,
            expected_sha256: str | None,
        ) -> str:
            dest_path.parent.mkdir(parents=True, exist_ok=True)
            with tarfile.open(dest_path, "w:gz") as tar:
                payload = b"nope"
                member = tarfile.TarInfo("../outside.txt")
                member.size = len(payload)
                tar.addfile(member, io.BytesIO(payload))
            if on_progress is not None:
                size = dest_path.stat().st_size
                on_progress(size, size)
            assert expected_sha256 == "expected-sha"
            return "expected-sha"

        stub = _StubClient(detail=detail, downloader=_downloader)
        _install_stub_client(monkeypatch, stub)

        manager = hive_models.DownloadJobManager()
        job_id = manager.enqueue("hive-a", "model-1")

        final = manager.wait_for_terminal(job_id, timeout=5.0)
        assert final.get("status") == "failed", final
        assert "unsafe archive member" in (final.get("error") or "")
        assert not outside_target.exists()

    def test_no_matching_variant_fails_fast(
        self, tmp_path: Path, monkeypatch: pytest.MonkeyPatch
    ) -> None:
        monkeypatch.setattr(hive_models, "LOCAL_MODELS_DIR", tmp_path)
        _configure_target(monkeypatch)
        stub = _StubClient(detail=_make_detail())
        _install_stub_client(monkeypatch, stub)

        manager = hive_models.DownloadJobManager()
        job_id = manager.enqueue("hive-a", "model-1", variant_runtime="hailo")

        with hive_models._job_manager_lock if False else threading.Lock():
            pass
        final = manager.wait_for_terminal(job_id, timeout=1.0)
        assert final.get("status") == "failed"
        assert "no variant" in (final.get("error") or "").lower()


# ---------------------------------------------------------------------------
# remove_installed_model path safety
# ---------------------------------------------------------------------------


class TestRemoveInstalledModel:
    def test_rejects_path_traversal(
        self, tmp_path: Path, monkeypatch: pytest.MonkeyPatch
    ) -> None:
        monkeypatch.setattr(hive_models, "LOCAL_MODELS_DIR", tmp_path)

        # Create a sibling directory outside LOCAL_MODELS_DIR we do NOT want
        # deleted.
        outside = tmp_path.parent / "outside_dir"
        outside.mkdir(exist_ok=True)
        sentinel_file = outside / "precious.txt"
        sentinel_file.write_text("do not delete")

        with pytest.raises(ValueError):
            hive_models.remove_installed_model("../outside_dir")

        assert sentinel_file.exists(), "traversal path must not touch sibling dir"
        assert outside.exists()

    def test_rejects_absolute_path(
        self, tmp_path: Path, monkeypatch: pytest.MonkeyPatch
    ) -> None:
        monkeypatch.setattr(hive_models, "LOCAL_MODELS_DIR", tmp_path)
        with pytest.raises(ValueError):
            hive_models.remove_installed_model("/etc")

    def test_missing_dir_raises_filenotfounderror(
        self, tmp_path: Path, monkeypatch: pytest.MonkeyPatch
    ) -> None:
        monkeypatch.setattr(hive_models, "LOCAL_MODELS_DIR", tmp_path)
        with pytest.raises(FileNotFoundError):
            hive_models.remove_installed_model("hive-does-not-exist")

    def test_removes_valid_directory(
        self, tmp_path: Path, monkeypatch: pytest.MonkeyPatch
    ) -> None:
        monkeypatch.setattr(hive_models, "LOCAL_MODELS_DIR", tmp_path)
        target = tmp_path / "hive-abc"
        (target / "exports").mkdir(parents=True)
        (target / "run.json").write_text("{}")
        hive_models.remove_installed_model("hive-abc")
        assert not target.exists()


# ---------------------------------------------------------------------------
# Local models — put in the models dir by hand, no hive block
# ---------------------------------------------------------------------------


class TestLocalModels:
    def test_listing_tells_hive_downloads_and_local_models_apart(
        self, tmp_path: Path, monkeypatch: pytest.MonkeyPatch
    ) -> None:
        from vision import detection_registry

        monkeypatch.setattr(hive_models, "LOCAL_MODELS_DIR", tmp_path)
        monkeypatch.setattr(detection_registry, "MODELS_DIR", tmp_path)
        detection_registry.invalidate_registry()
        _write_legacy_install(tmp_path)

        local = tmp_path / "my-model"
        (local / "exports").mkdir(parents=True)
        (local / "exports" / "best.onnx").write_bytes(b"onnx")
        (local / "run.json").write_text(json.dumps({"name": "My model", "model_family": "yolo"}))

        junk = tmp_path / "not-a-model"
        (junk / "exports").mkdir(parents=True)
        (junk / "run.json").write_text(json.dumps({"notes": "no family, no artifact"}))

        by_id = {entry["local_id"]: entry for entry in hive_models.list_installed_models()}
        assert set(by_id) == {"hive-model-1-onnx", "my-model"}

        hive_entry = by_id["hive-model-1-onnx"]
        assert hive_entry["source"] == "hive"
        assert hive_entry["algorithm_id"] == "hive:hive-model-1-onnx"
        assert hive_entry["target_id"] == "hive-a"

        local_entry = by_id["my-model"]
        assert local_entry["source"] == "local"
        assert local_entry["algorithm_id"] == "local:my-model"
        assert local_entry["name"] == "My model"
        assert local_entry["variant_runtime"] == "onnx"
        assert local_entry["compatible"] is True
        assert local_entry["target_id"] is None

        # The registry agrees on the id.
        assert detection_registry.detection_algorithm_definition("local:my-model") is not None

    def test_local_model_is_removable(
        self, tmp_path: Path, monkeypatch: pytest.MonkeyPatch
    ) -> None:
        monkeypatch.setattr(hive_models, "LOCAL_MODELS_DIR", tmp_path)
        local = tmp_path / "my-model"
        (local / "exports").mkdir(parents=True)
        (local / "exports" / "best.onnx").write_bytes(b"onnx")
        (local / "run.json").write_text(json.dumps({"model_family": "yolo"}))

        hive_models.remove_installed_model("my-model")

        assert not local.exists()
        assert hive_models.list_installed_models() == []


# ---------------------------------------------------------------------------
# Codenames — Hive's human-readable identity carried onto the machine
# ---------------------------------------------------------------------------


class TestCodenames:
    def test_download_records_codename_and_color(
        self, tmp_path: Path, monkeypatch: pytest.MonkeyPatch
    ) -> None:
        monkeypatch.setattr(hive_models, "LOCAL_MODELS_DIR", tmp_path)
        _configure_target(monkeypatch)

        detail = {**_make_detail(), "codename": "Ember", "codename_color": "#E25822"}

        def _downloader(
            model_id: str,
            variant_id: str,
            dest_path: Path,
            on_progress: Callable[[int, int], None] | None,
            expected_sha256: str | None,
        ) -> str:
            dest_path.parent.mkdir(parents=True, exist_ok=True)
            dest_path.write_bytes(b"bytes")
            return "expected-sha"

        _install_stub_client(monkeypatch, _StubClient(detail=detail, downloader=_downloader))

        manager = hive_models.DownloadJobManager()
        job_id = manager.enqueue("hive-a", "model-1")
        assert manager.wait_for_terminal(job_id, timeout=5.0).get("status") == "done"

        sentinel = json.loads((tmp_path / "hive-model-1-onnx" / "run.json").read_text())[
            hive_models.HIVE_SENTINEL_KEY
        ]
        assert sentinel["codename"] == "Ember"
        assert sentinel["codename_color"] == "#E25822"

        installed = hive_models.list_installed_models()
        assert installed[0]["codename"] == "Ember"
        assert installed[0]["codename_color"] == "#E25822"

    def test_installs_predating_the_field_report_none(
        self, tmp_path: Path, monkeypatch: pytest.MonkeyPatch
    ) -> None:
        monkeypatch.setattr(hive_models, "LOCAL_MODELS_DIR", tmp_path)
        _write_legacy_install(tmp_path)

        installed = hive_models.list_installed_models()
        assert installed[0]["codename"] is None
        assert installed[0]["codename_color"] is None

    def test_browsing_backfills_a_legacy_install(
        self, tmp_path: Path, monkeypatch: pytest.MonkeyPatch
    ) -> None:
        monkeypatch.setattr(hive_models, "LOCAL_MODELS_DIR", tmp_path)
        _configure_target(monkeypatch)
        run_path = _write_legacy_install(tmp_path)

        stub = _StubClient(detail=_make_detail())
        stub.list_models = lambda **_: {  # type: ignore[method-assign]
            "items": [
                {
                    "id": "model-1",
                    "name": "Test Detector",
                    "codename": "Ember",
                    "codename_color": "#E25822",
                }
            ],
            "total": 1,
            "page": 1,
            "page_size": 30,
            "pages": 1,
        }
        _install_stub_client(monkeypatch, stub)

        page = hive_models.list_remote_models("hive-a")
        assert page["items"][0]["installed"] is True

        sentinel = json.loads(run_path.read_text())[hive_models.HIVE_SENTINEL_KEY]
        assert sentinel["codename"] == "Ember"
        assert sentinel["codename_color"] == "#E25822"
        assert hive_models.list_installed_models()[0]["codename"] == "Ember"


def test_a_default_install_counts_as_installed_on_its_hive(
    tmp_path: Path, monkeypatch: pytest.MonkeyPatch
) -> None:
    """The default-model install has no target; browsing the same Hive through
    a target still shows the model as installed."""
    monkeypatch.setattr(hive_models, "LOCAL_MODELS_DIR", tmp_path)
    _configure_target(monkeypatch)
    run_path = _write_legacy_install(tmp_path)
    payload = json.loads(run_path.read_text())
    payload[hive_models.HIVE_SENTINEL_KEY].update(
        {"target_id": None, "source_url": "https://hive.example/", "installed_as_default": True}
    )
    run_path.write_text(json.dumps(payload))

    stub = _StubClient(detail=_make_detail())
    stub.list_models = lambda **_: {  # type: ignore[method-assign]
        "items": [{"id": "model-1"}, {"id": "model-2"}],
        "total": 2,
        "page": 1,
        "page_size": 30,
        "pages": 1,
    }
    _install_stub_client(monkeypatch, stub)

    items = hive_models.list_remote_models("hive-a")["items"]
    assert [item["installed"] for item in items] == [True, False]
    assert hive_models.get_remote_model("hive-a", "model-1")["installed"] is True


def _write_legacy_install(root: Path) -> Path:
    """An installed model whose run.json predates the codename fields."""
    dest = root / "hive-model-1-onnx"
    (dest / "exports").mkdir(parents=True)
    run_path = dest / "run.json"
    run_path.write_text(
        json.dumps(
            {
                "name": "Test Detector",
                "model_family": "yolo",
                hive_models.HIVE_SENTINEL_KEY: {
                    "target_id": "hive-a",
                    "model_id": "model-1",
                    "variant_runtime": "onnx",
                    "sha256": "abc",
                },
            }
        )
    )
    return run_path
