jper1679/sorter-v2/(commit log)

2026-10-12 Fix Y1 oscillator supply routing and switch to 5V
    [1_Distribution_Board.kicad_pcb, 1_Distribution_Board.kicad_sch, 815.kicad_sch, Level_Shifters.kicad_sch, Power.kicad_sch, Stepper_Module.kicad_sch]
2026-10-12 feat(firmware): add test console firmware and Flet GUI test suite for Distribution Board v1.3
2026-10-12 feat(electronics): update Distribution Board v1.3+ schematic and PCB layout
    [1_Distribution_Board.kicad_pcb]
2026-10-12 fix(vision): add Windows USB camera enumeration and DirectShow capture support
    [cameras.py]
2026-10-16 docs: add Jetson Orin Nano Super roadmap and architecture notes
2026-10-17 docs(jetson): update checklist with hardware detection, systemd service, and TensorRT setup
2026-10-17 feat(vision): add native TensorRT 10.x GPU runtime processor and Jetson discovery
2026-10-17 fix(test): correct import in test_tensorrt_processor.py
    [test_tensorrt_processor.py]
2026-10-17 fix(vision): strict engine artifact resolution and add tensorrt test cases in test_hive_models
    [test_hive_models.py]
2026-10-17 docs(jetson): document completed TensorRT integration and 263 FPS benchmark
2026-10-17 fix(tensorrt): add explicit 64-bit ctypes argtypes for libcudart, shared trt logger, and thread synchronization
2026-10-17 fix(tensorrt): import threading
2026-10-20 fix(chute): increase HOME_TIMEOUT_MS to 45s to allow full 360-degree homing sweep
    [chute.py]
2026-10-20 fix(chute): ensure stepper is stopped on homing timeout
    [chute.py]
2026-10-20 fix(chute): do not treat disabled chute as unhomed stall incident
    [chute.py, stepper_stall_monitor.py]
2026-10-22 fix(zones): add backward-compatible /api/polygons routes for legacy frontends
    [zones.py]
2026-11-07 feat(classification): capture burst au repos et ajustements timeouts/seuils Jetson
